pedapudi/oddstride/longshanks/README.md

# Longshanks

Longshanks is the humanoid biped robot in [Oddstride](../README.md).

This directory is for Longshanks' design notes, hardware, and software. Development is at the initial design stage.
