pedapudi/oddstride/tinfox/proposals/sculpted/model/output/flat-patterns/README.txt

TINFOX FLAT CUTTING PROFILES — MILLIMETRES

Electronics deck: the current part is 4 mm PETG, printed flat. The DXF is a
profile candidate for later flat cutting or CNC. A thinner aluminum version
requires revised screw lengths, equipment height and a stiffness check.

Fixed lower brace: 3 mm aluminum candidate. The midplane DXF gives the cut
outline and holes. Finish the four 2.5 mm pilot holes as M3 x 0.5 threads;
four 3.4 mm holes are rail clearances. Deburr edges. The STEP includes small
edge radii that a cutting operation alone does not produce.

Confirm available stock thickness, cutting process, hole limits and tapping
with the fabricator. These files are not a manufacturing release.
