pedapudi/oddstride/tinfox/proposals/sculpted/design/rounded-shell-concept-v1/index.html

# Tinfox / rounded shell concept

Proposed articulated shoulder covers, rounded structural thighs and smooth oval shins. These generated images illustrate surface shape and assembly seams. They are not CAD exports or evidence of validated clearance, strength or manufacturability.

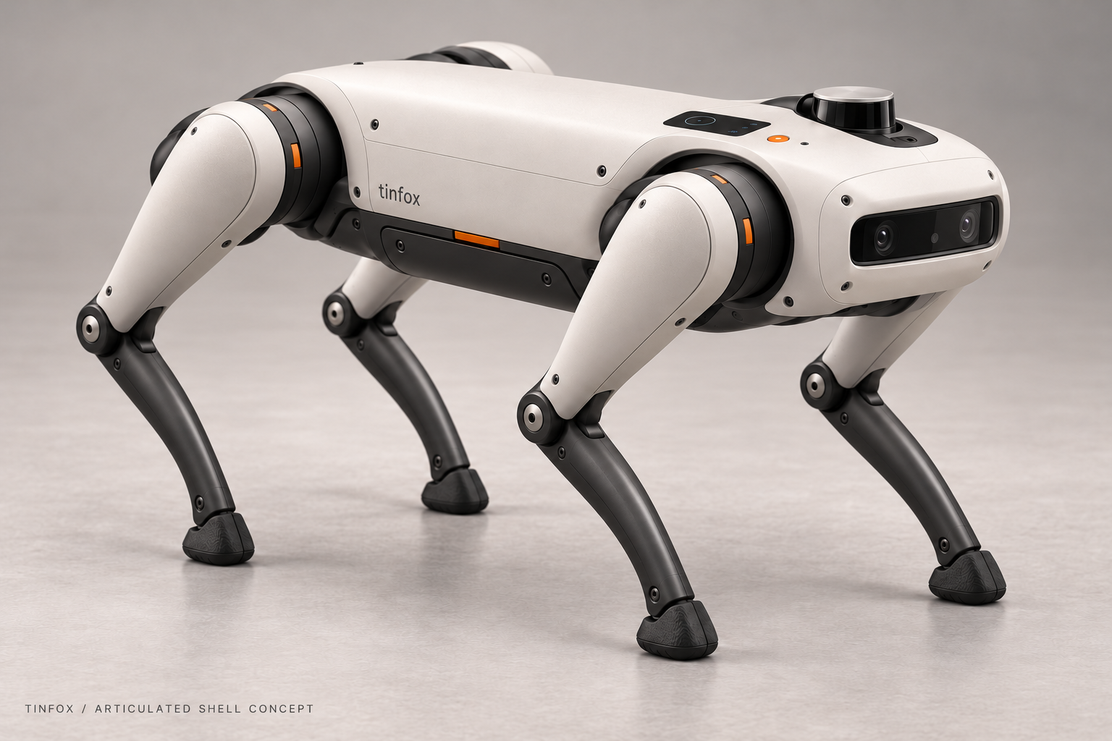
[picture p2: tinfox/proposals/sculpted/design/rounded-shell-concept-v1/full-robot.png]
Proposed Tinfox exterior with moving shoulder covers and smoothly rounded limbs


Complete robot: warm off-white body and thighs, graphite shoulder pods and closed oval shins.

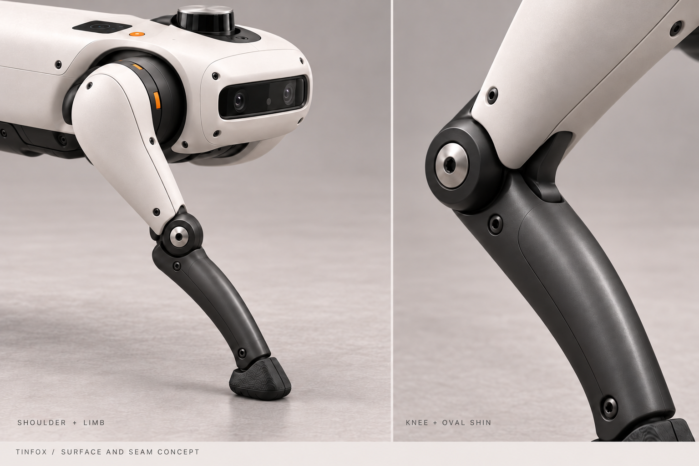
[picture p3: tinfox/proposals/sculpted/design/rounded-shell-concept-v1/limb-detail.png]
Shoulder and complete limb beside a close view of the knee transition and rounded shin


Detail: compact shoulder packaging, two-piece limb seams and broad knee transitions. Hardware interfaces remain subject to CAD development.

Generation prompts and provenance · Generated with the built-in image tool. The existing CAD and native Fusion conversion remain unchanged by this concept study.
