pedapudi/oddstride/tinfox/proposals/sculpted/model/output/service-design/README.html

# Tinfox chassis-mounted head and service revision

This CAD revision changes the shin split to two structural side halves. Each half contains a complete 28 mm bearing bore and an integral pushrod ear. The thigh cheeks provide backup axial stops. Motor connector envelopes and local housing openings are included in the robot view.

Open interactive CAD · Open bearing extraction view · Labeled bearing section · Updated whole robot STEP · Updated front-left leg STEP

## Chassis-mounted head; cosmetic rear cap removed

The narrow lower strips beneath the head and tail have been removed. The front bridge attaches directly to the chassis crossmember through a 48 mm-wide mounting lap and two vertical M3 screws. Deep rounded shoulder sockets follow a conservative hip-roll envelope. Leg loads still pass through the independent motor cartridges and metal chassis.

The curved central bridge rises locally to about 68 mm above the hip-roll axis, compared with the earlier 55.5 mm shoulder crown. This extra depth preserves material above the sockets. The front retains a reinforced lower camera surround and removable curved fascia. The rear cap carries no equipment or chassis load and has been removed, together with its two screws and two nuts. The rear chassis crossmember remains to connect the motor rails. The head bridge is not a qualified lifting handle.

The provisional lidar moves 30 mm rearward onto the central cover to clear the front bridge. The two head nuts now sit below the front chassis crossmember; the earlier placement overlapped the metal. Existing screw locations remain unchanged.

For end-module service, remove the upper body cover, disconnect sensor wiring, undo the two cap screws and lift the module. The front fascia remains independently removable for camera service. Battery removal remains independent. Print the supplied oriented head bridge with removable supports beneath curved surfaces and local returns; it is not a support-free part. Inspect the sliced screw holes and narrowest bridge sections before printing.

Inspect the head bridge · Fixed interfaces and removal-path checks

## Knee linkage display correction

The isolated thigh view previously discarded the crank and rod transforms, incorrectly drawing the rod eye at the motor center. That view now preserves the assembled transforms. The rod attaches to a pin 22 mm from the motor axis, and its eyes are 170 mm apart. The dedicated linkage view exposes both connections. The geometry audit checks both eye-to-pin positions on all four legs in all 35 sampled poses.

Inspect the knee linkage

## Native Fusion conversion

A native-feature conversion is in progress. This revision remains the reference geometry until the Fusion parts pass shape, interface, assembly, motion and editability audits. STEP files below preserve solids but do not supply a native editable feature history.

## Removing a bearing

1. Support the leg. Disconnect the pushrod and remove the knee axle retention. Separate the shin from the thigh cheeks. The cheeks normally limit outward bearing movement, with 0.3 mm nominal axial clearance.
2. Remove the two M4 × 25 cross bolts and open the shin sideways. Bearings remain in their complete circular seats. The 18 mm compression sleeves and standard nuts are removable hardware.
3. Support the removed half close to its bearing housing with an opening beneath the bearing. Insert two blunt 2 mm service pins through the 2.6 mm holes behind the bearing outer ring.
4. Apply even force with a small press or suitable parallel tool so the bearing exits outward. Avoid loading the inner ring or seals. The pins are temporary tools, not installed leg components.

The opposed inward shoulders locate the bearing outer rings. The thigh faces are backup stops and are not intended to rub continuously. The inner-race spacer stack must let normal axial loads pass through the bearings.

The access holes pass through the rear shoulder. They do not split the cylindrical seat. Their contact positions must be checked against the selected bearing's outer-ring face before pressing. The model uses nominal 12 × 28 × 8 mm bearing envelopes.

Section through the bearing shoulder and two rear extraction holes

## How the halves locate and clamp

Broad mating faces and two alignment tongues locate the side halves. Two M4 cross bolts run parallel to the knee axle. Metal compression sleeves carry bolt preload. The shin retains the curved outer profile and internal cavity. Both halves are required for operation.

The complete bore improves repeatability relative to two semicircular seats, but two printed seats can still be misaligned. The nominal 28 mm CAD bore is not a specified interference fit. Print bearing-seat coupons in the same orientation and material before choosing hole compensation. Measure the assembled axle alignment and check running resistance before and after tightening.

## Principles carried into the thigh

The thigh keeps its integrated motor cradle and removable outer structural half. The motor plate is accessible after opening the shell. Broad load paths, metal compression sleeves and open service access also apply to the shin. The revision adds knee outer-race backup stops to the existing thigh cheeks, avoiding another installed bearing cover.

The thigh does not need the same bearing-extraction holes at the knee: its knee interface holds the axle, while the rolling bearings live in the shin. The separate hip-roll bearing needs its own retention and extraction design.

## Connector geometry and assumptions

The cached RobStride STEP contains two opposed radial ports near the rear cover. Both are represented on each of the twelve motors, for 24 reserved port positions. The housing envelope uses a 15.5 × 5.2 mm mouth; the cable plug uses the AMASS 12.3 × 4.2 × 11.8 mm outline. These are packaging solids, not contact-level connector CAD.

The provisional insertion overlap is 5 mm. Heat-shrink space, a 7 mm cable-bundle envelope and a straight 22 mm cable segment are included. The model reserves a 20 × 14 mm withdrawal corridor. These dimensions do not establish a cable bend radius or qualify flexing across hip roll and pitch. Harness anchor positions, slack loops, abrasion protection and fatigue life remain open.

The knee stator plate rotates its nine-hole pattern by 20 degrees while retaining the three structural tie positions. This gives the knee ports a different clocking from the hip and roll ports to clear the proximal carrier in the named poses. Socket position is measured approximately from the cached vendor STEP; final clocking and insertion depth require a fit check with the supplied motor and plug.

Housing windows and an underside-panel opening accommodate the modeled connectors. The cutouts remain unsealed. They do not establish an environmental protection rating. Local strength around the windows requires review.

## Measured checks and limits

All 24 plug positions pass the sampled 25 mm withdrawal path in neutral with exterior body covers removed. Seven named poses clear the revised interfaces. The deep fold retains front-thigh contact with the underside panel. Additional combined-angle samples also contain collisions; the model does not establish an unrestricted joint range.

Exact-solid checks cover bearing withdrawal, shell separation, extraction-pin access, clamp hardware and nominal thigh-stop gaps. The browser highlights reported interference in the selected pose. Collision samples cover plugs, initial cable segments and revised structural parts; they do not model a deforming harness.

Estimated base mass is 13.213 kg. The modeled change is +24.9 g relative to the previous assembly. This remains a CAD estimate with battery, electronics and wiring allowances. It exceeds the 10 kg target.

Geometry checks · Recomputed torque screen · Export inventory

Load case | Payload kg | Roll, hip, knee motor torque N·m
four foot stand | 0 | 1.73, 0.11, 2.61
two foot stand | 0 | 3.90, 0.47, 5.27
three foot crouch | 0 | 2.45, 0.41, 6.34
stair reach 60 percent | 0 | 6.59, 13.43, 12.51
reach with braking | 0 | 6.59, 9.50, 11.76
splayed two foot | 0 | 13.41, 0.42, 4.96
four foot stand | 1 | 1.89, 0.14, 2.81
two foot stand | 1 | 4.23, 0.52, 5.67
three foot crouch | 1 | 2.67, 0.48, 6.83
stair reach 60 percent | 1 | 7.13, 14.46, 13.46
reach with braking | 1 | 7.13, 10.24, 12.66
splayed two foot | 1 | 14.47, 0.47, 5.34
unloaded 2p5g pulse | 0 | 10.41, 1.54, 13.26
unloaded 3g landing screen | 0 | 12.58, 1.89, 15.93

The torque screen uses prescribed foot forces and moving-link gravity. It does not certify stairs, running, jumping, thermal endurance or self-righting. Printed strength, creep, bearing fits, actual fastener lengths and cable life require physical testing.

## Printing and machining

Orient the side halves with the open cavity upward and the long limb axis in the bed plane. The bearing axis then prints vertically. Rounded exterior surfaces still need local support review in the slicer. Check first-layer distortion, bearing bores and alignment tongues. Solid infill does not establish strength or eliminate creep.

For CNC, machine complete bearing seats from common datums and inspect the assembled coaxiality. The two rear access holes are straight drilling operations. The integral fork and cross-bolt pockets still require tool-reach and setup review. STEP files preserve solids but not a native Fusion feature timeline.

## Printed fit parts

The keyed two-piece motor-carrier mockups include connector windows. These files are left-side fit mockups; right-side carriers require mirroring. They remain unloaded prototypes.

- printed carrier -1 trunnion · STL
- printed carrier -1 flange · STL
- printed carrier 1 trunnion · STL
- printed carrier 1 flange · STL
- bearing coupon 27p9 · STL
- bearing coupon 28p0 · STL
- bearing coupon 28p1 · STL
- bearing coupon 28p2 · STL

## Sources

- RobStride RS02 manual (https://www.robstride.com/assets/product_manual_robStride02-e7f9f7c4.pdf): connector pair and motor interface.
- RobStride product repository (https://github.com/RobStride/Product_Information): manufacturer CAD reference. This revision uses the previously cached RS02 STEP.
- AMASS connector catalog, page 11 (https://www.china-amass.com/public/upload/20240723/c1ae9604bbe795ebfd366c9063019e3e.pdf): XT30(2+2)-F plug outline.
- AMASS XT30 2+2 PB-M specification (https://www.tme.eu/Document/127227924e5d7adc643d586e8218a55a/XT30PB-M.pdf): board connector outline.
