pedapudi/oddstride/tinfox/analysis/dfma/fastener-reduction/thigh-detail/300-root.png

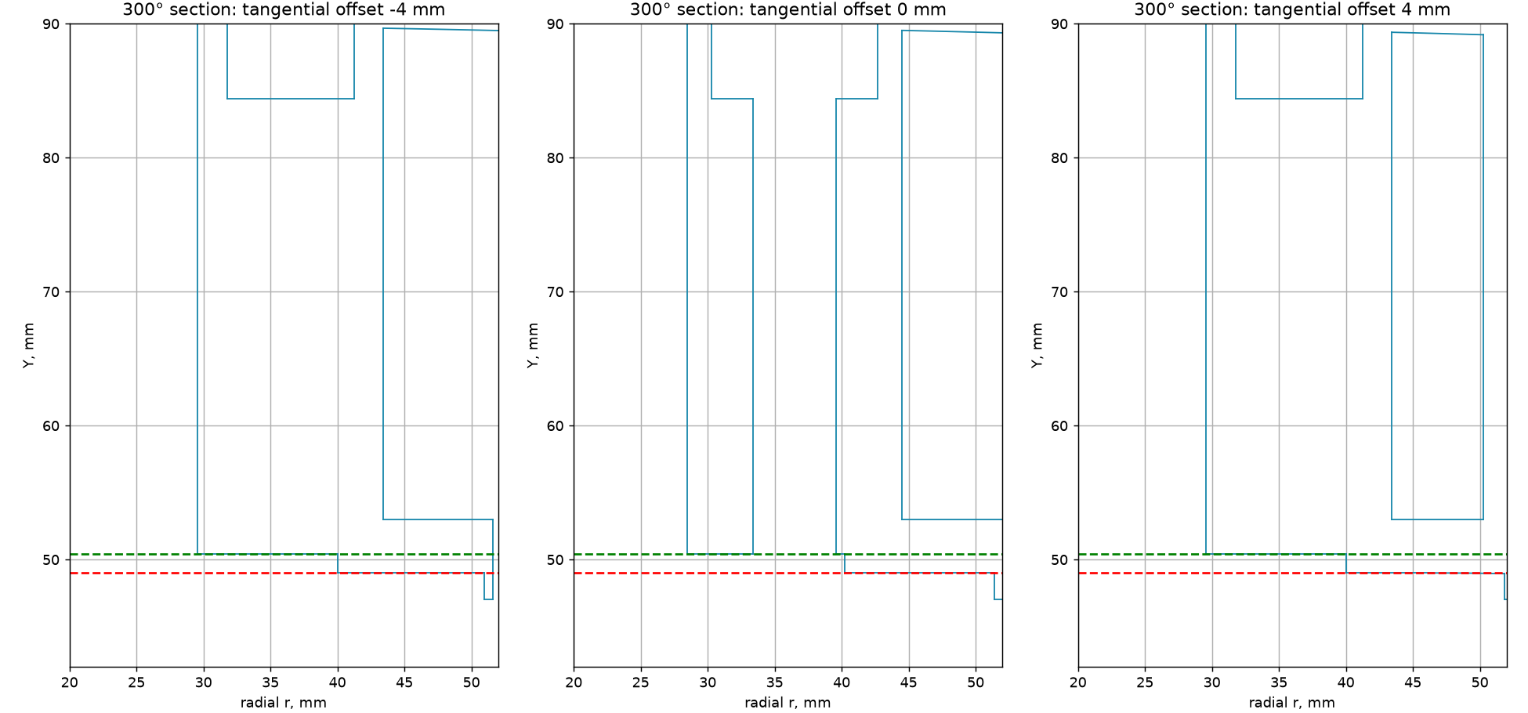
tinfox/analysis/dfma/fastener-reduction/thigh-detail/300-root.png
