pedapudi/oddstride/tinfox/analysis/dfma/fastener-reduction/thigh-detail/sections-y.png

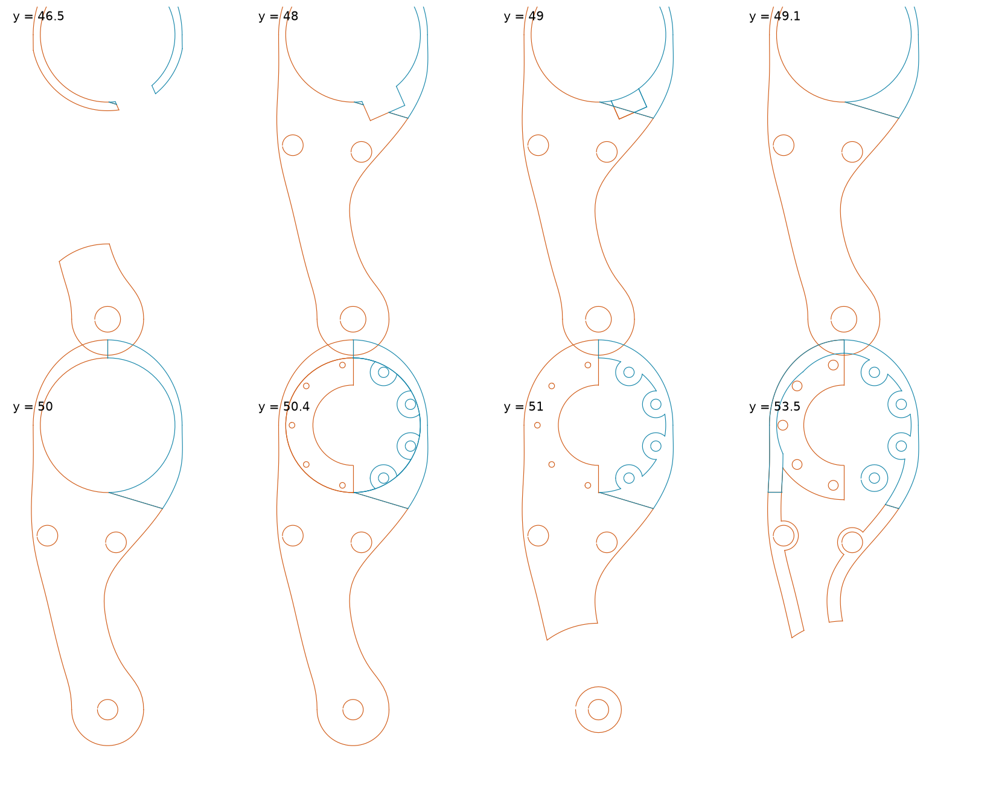
tinfox/analysis/dfma/fastener-reduction/thigh-detail/sections-y.png
