pedapudi/oddstride/tinfox/analysis/dfma/fastener-reduction/thigh-detail/sections-z.png

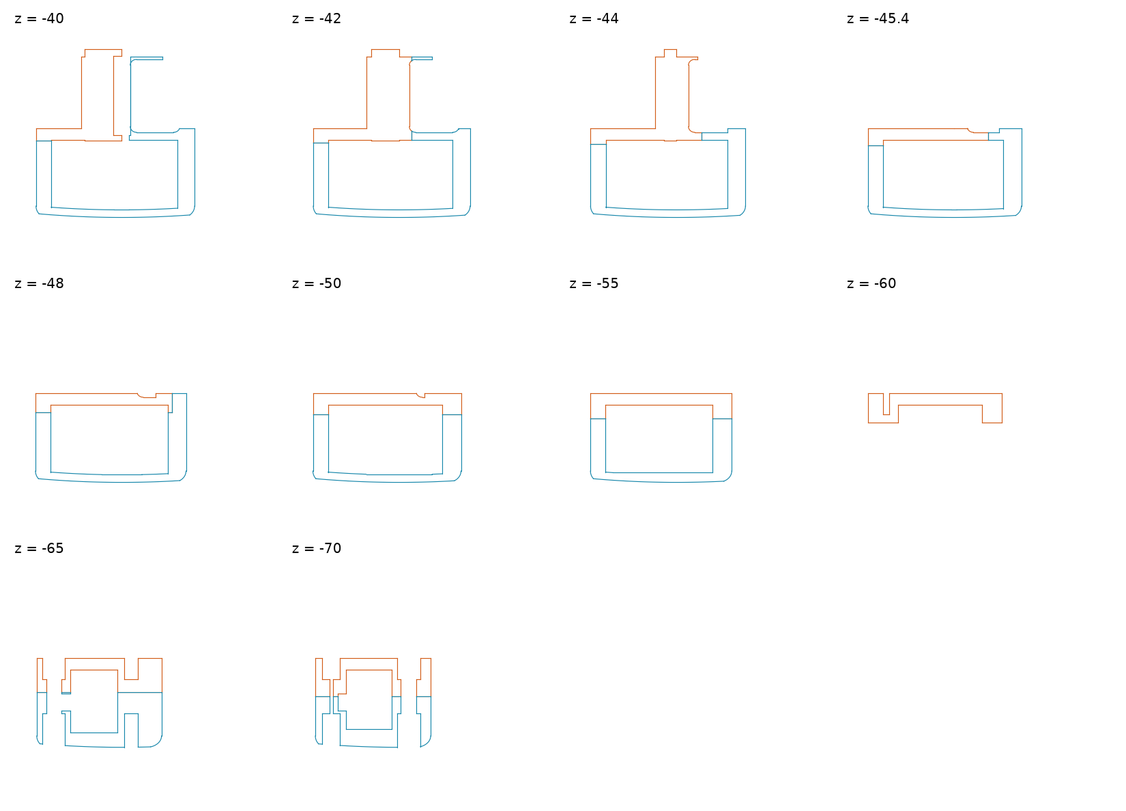
tinfox/analysis/dfma/fastener-reduction/thigh-detail/sections-z.png
