pedapudi/oddstride/tinfox/analysis/dfma/motor-complex-fit/rs02-side-datums.png

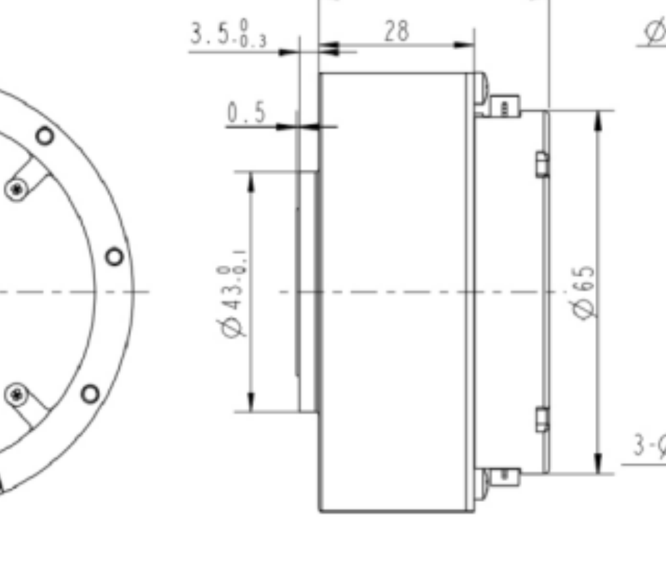
tinfox/analysis/dfma/motor-complex-fit/rs02-side-datums.png
