pedapudi/oddstride/tinfox/design/06-tinfox-instrument-concept.png

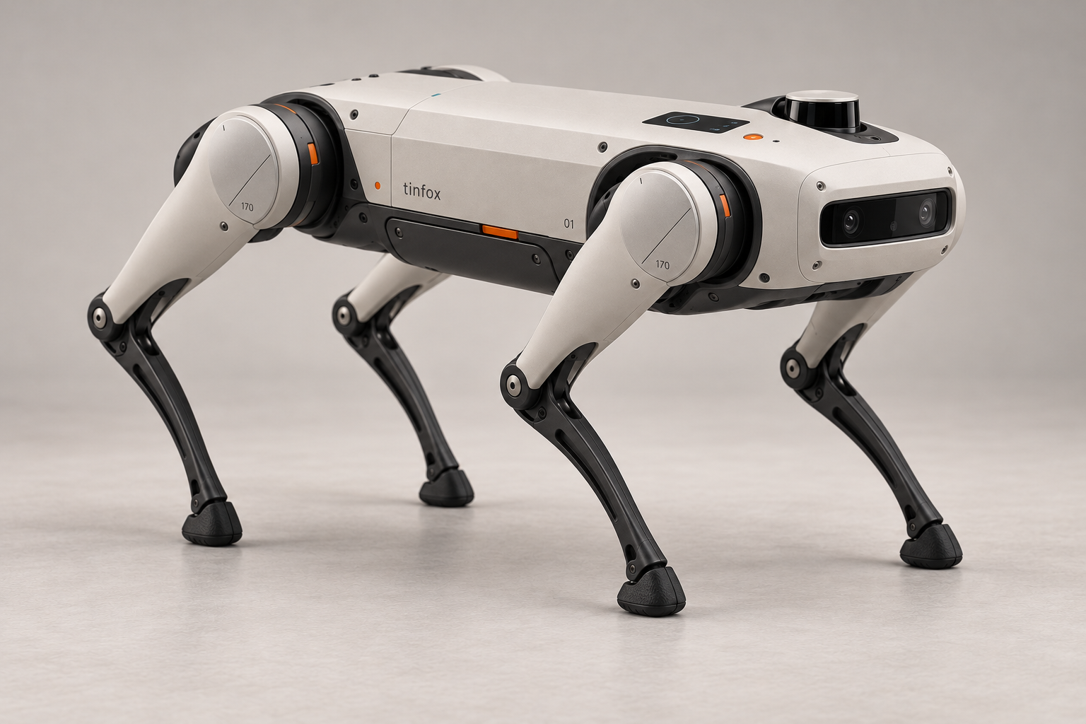
tinfox/design/06-tinfox-instrument-concept.png
