pedapudi/oddstride/tinfox/design/08-articulated-hip-studio.png

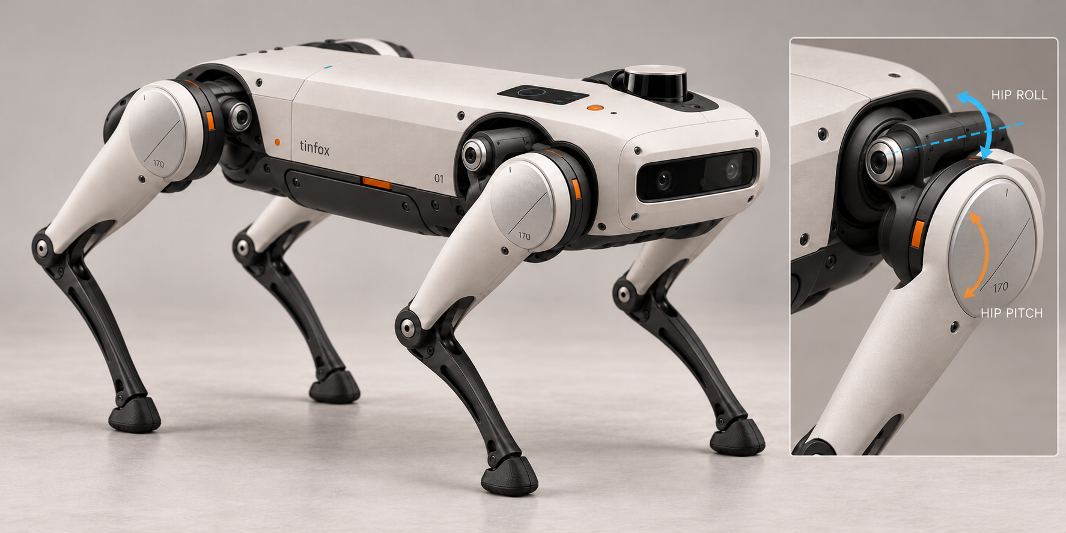
tinfox/design/08-articulated-hip-studio.png
