pedapudi/oddstride/tinfox/design/09-cad-studio.png

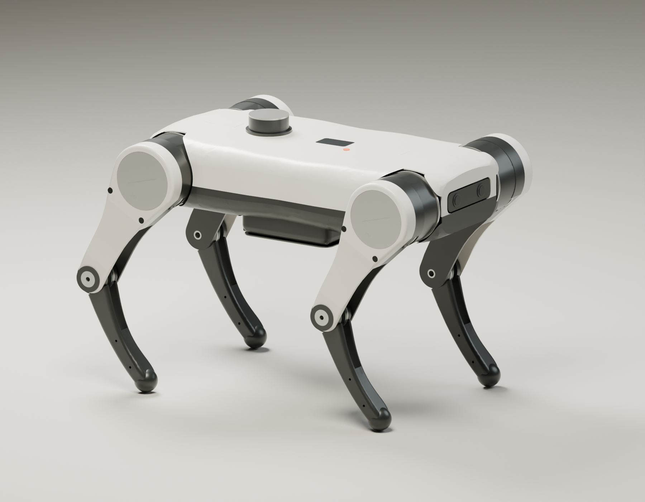
tinfox/design/09-cad-studio.png
