pedapudi/oddstride/tinfox/design/body-options/01-pebble.png

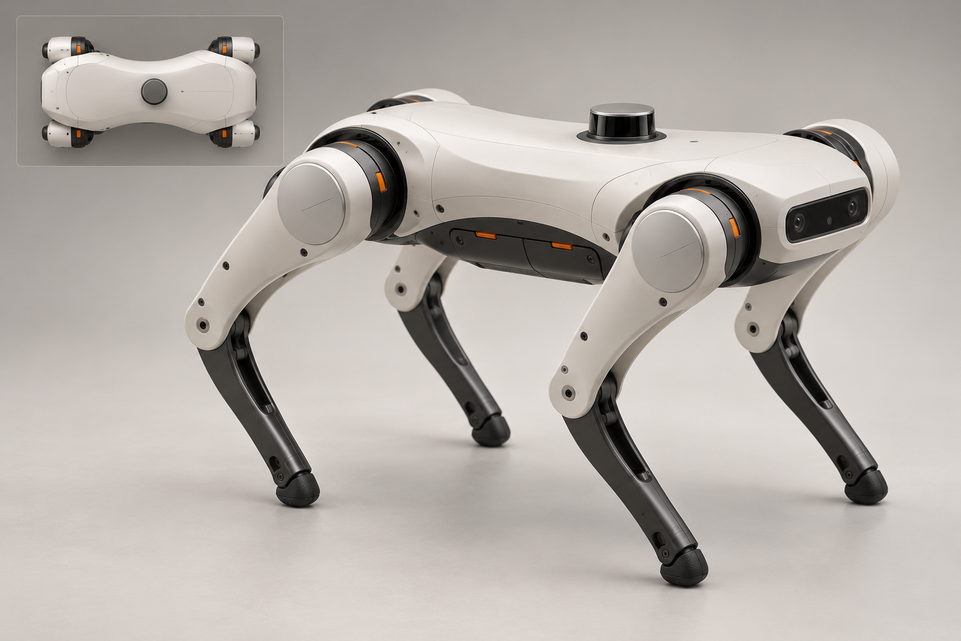
tinfox/design/body-options/01-pebble.png
