pedapudi/oddstride/tinfox/design/body-options/02-keel.png

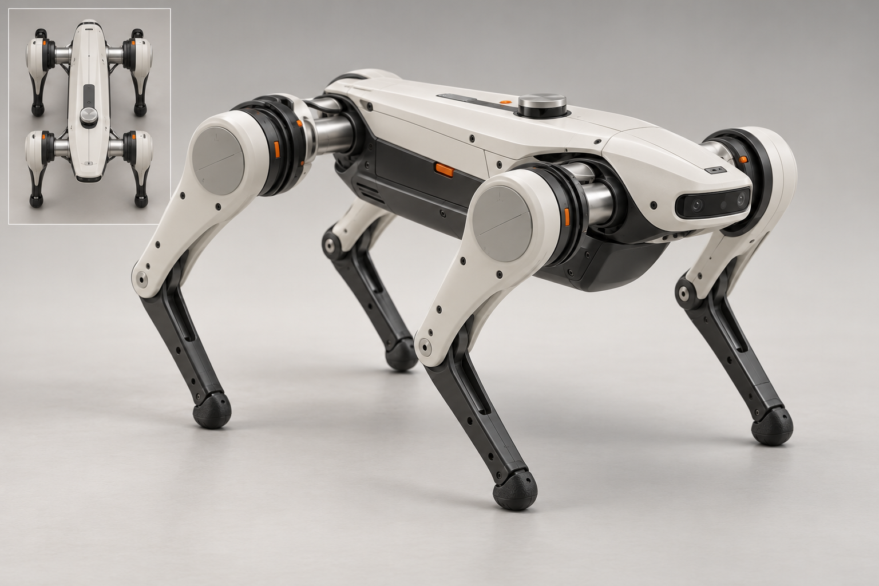
tinfox/design/body-options/02-keel.png
