pedapudi/oddstride/tinfox/design/body-options/03-twin-rail.png

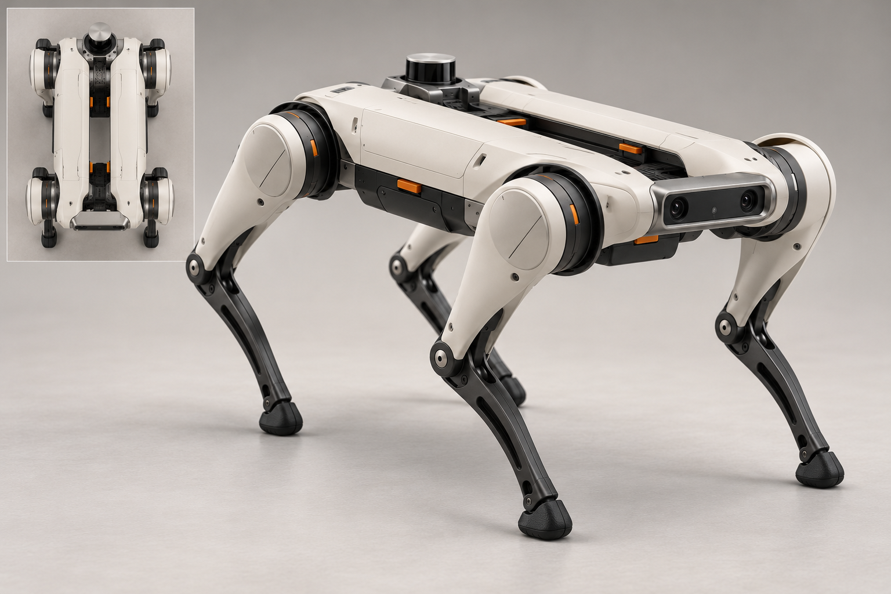
tinfox/design/body-options/03-twin-rail.png
