pedapudi/oddstride/tinfox/design/body-options/04-manta.png

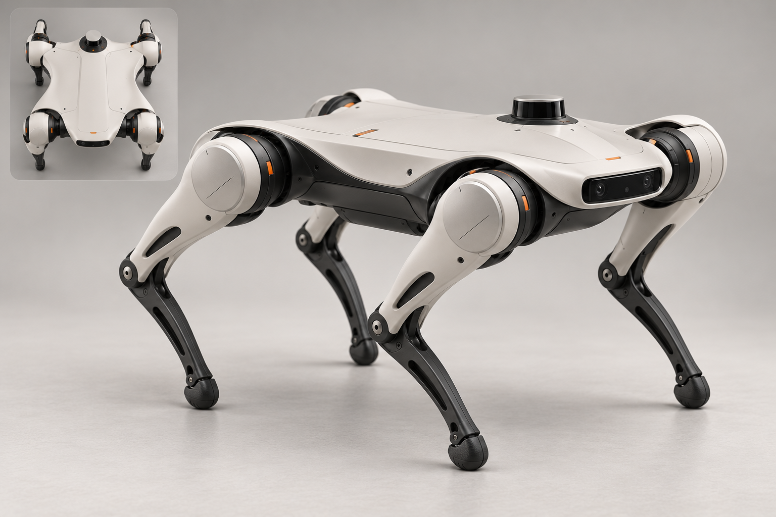
tinfox/design/body-options/04-manta.png
