pedapudi/oddstride/tinfox/design/body-options/baseline-cad.png

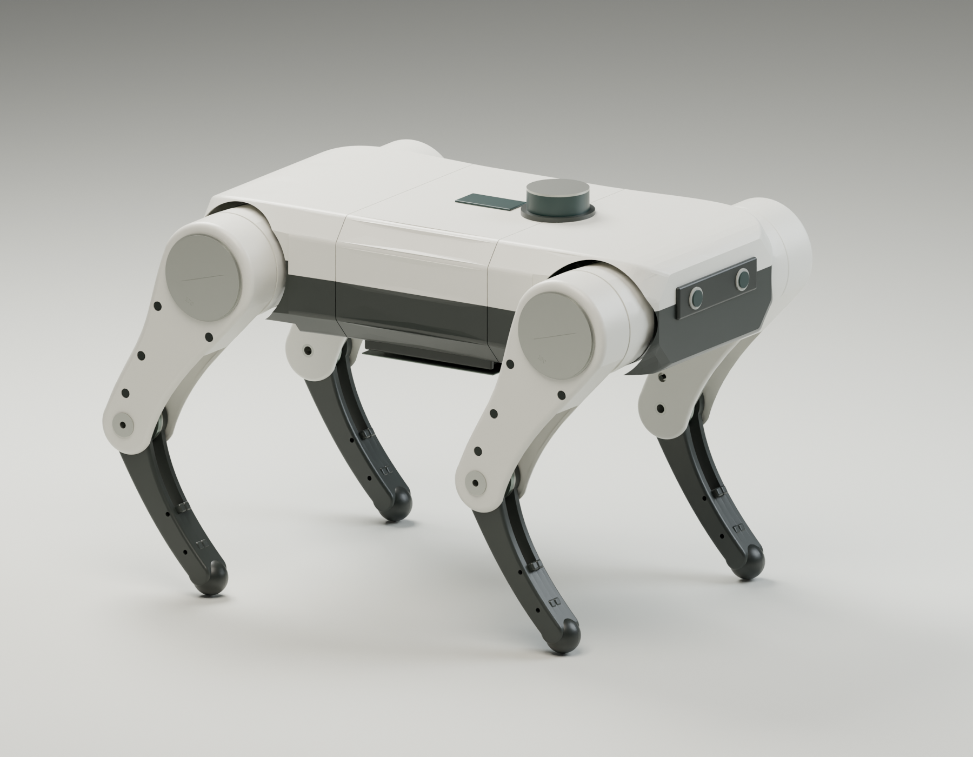
tinfox/design/body-options/baseline-cad.png
