pedapudi/oddstride/tinfox/design/body-options/review-preview.png

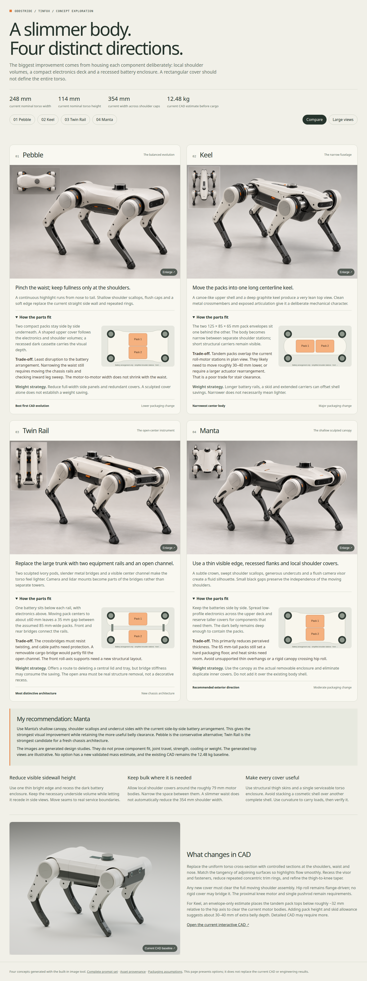
tinfox/design/body-options/review-preview.png
