pedapudi/oddstride/tinfox/model/output/body-comparison-preview.png

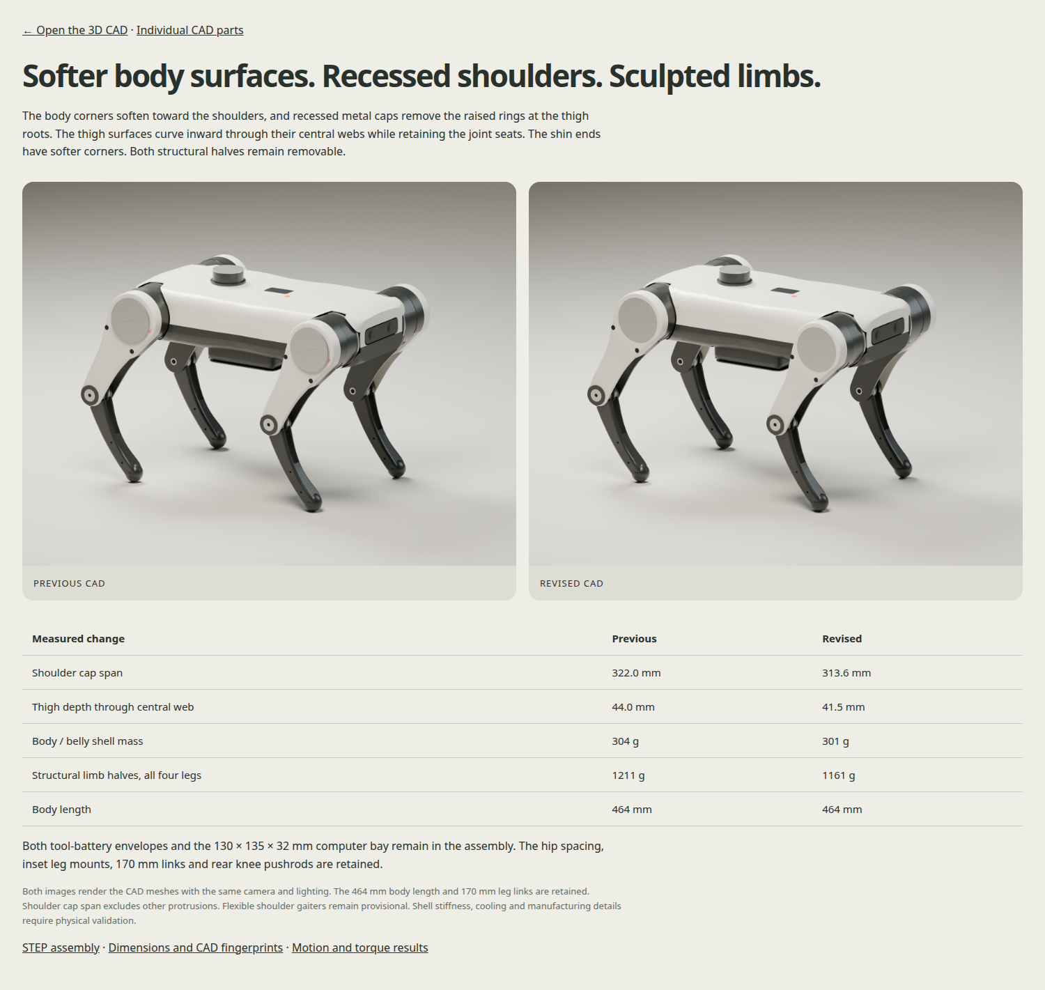
tinfox/model/output/body-comparison-preview.png
