pedapudi/oddstride/tinfox/model/output/exterior-preview.png

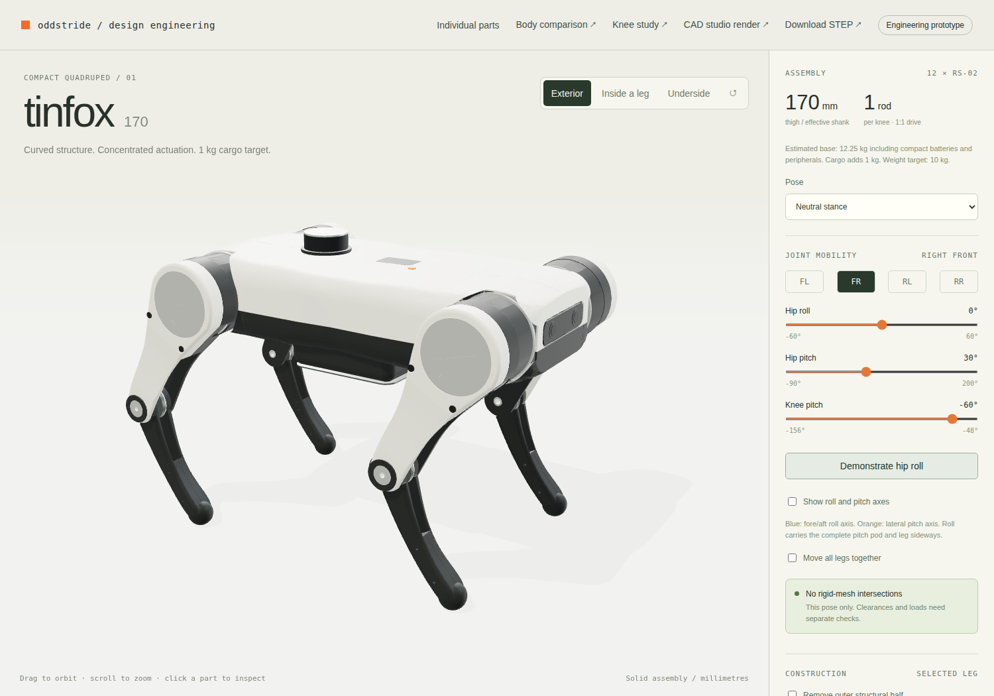
tinfox/model/output/exterior-preview.png
