pedapudi/oddstride/tinfox/model/output/integrated-thigh-preview.png

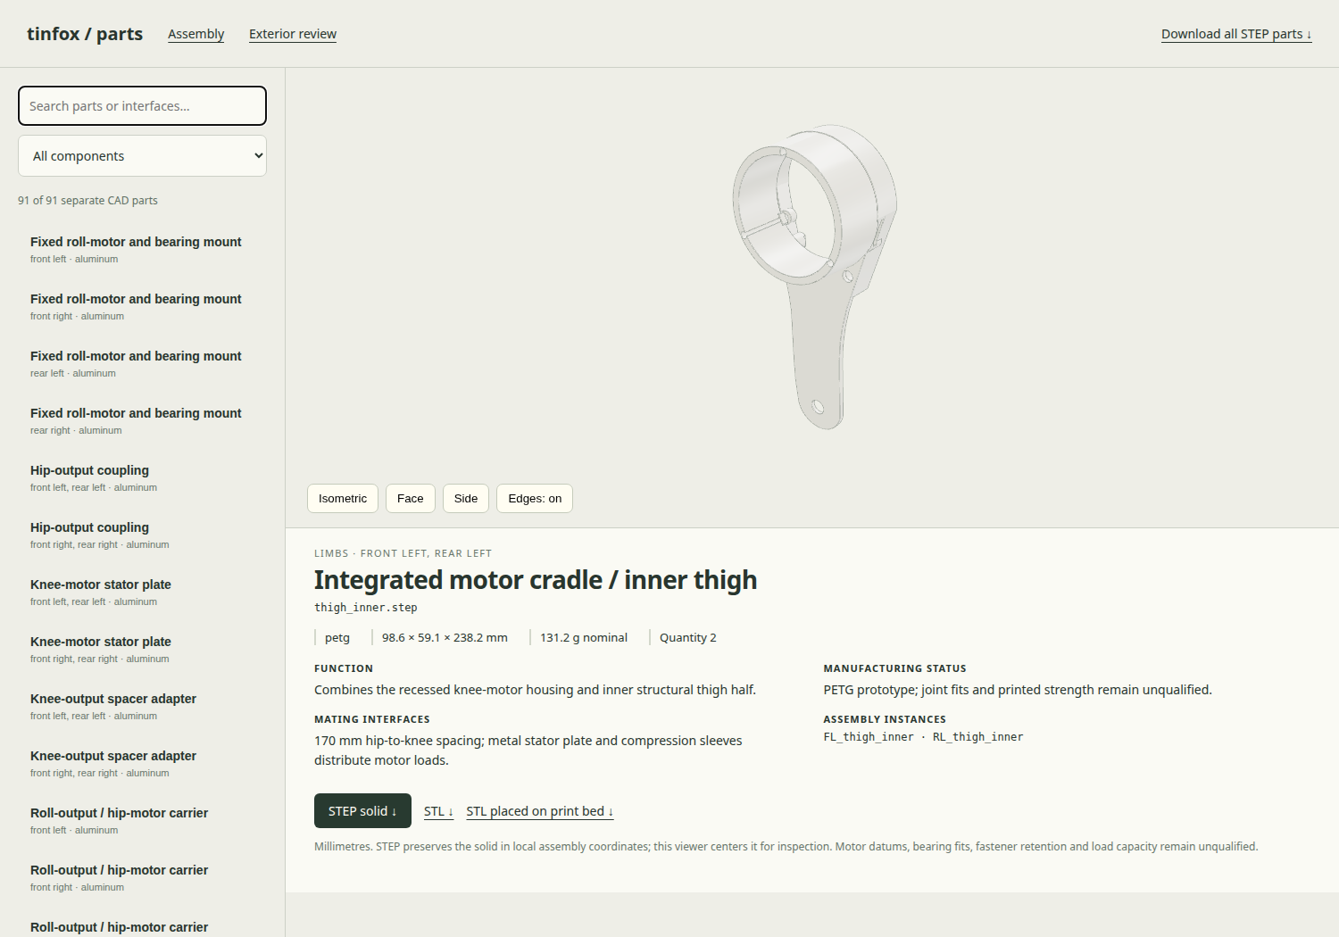
tinfox/model/output/integrated-thigh-preview.png
