pedapudi/oddstride/tinfox/model/output/knee-study-preview.png

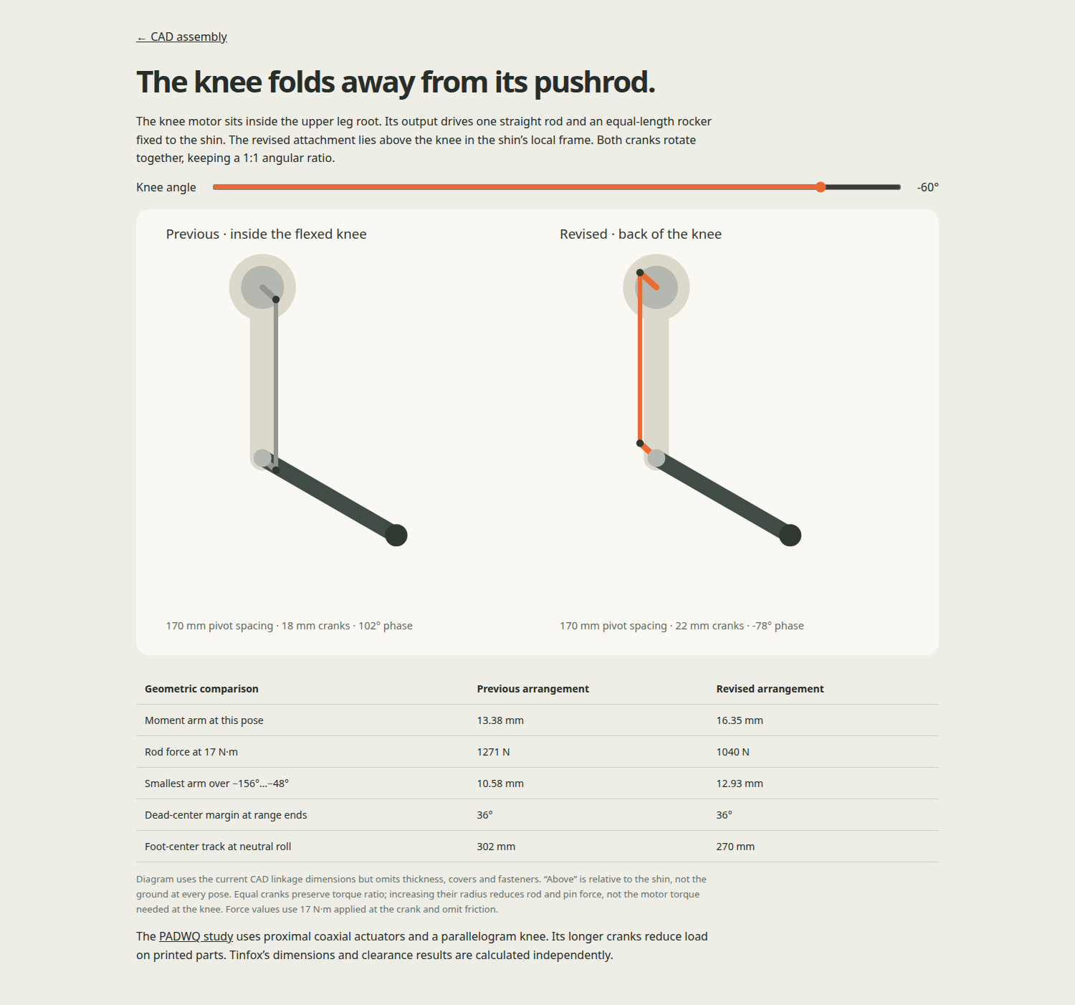
tinfox/model/output/knee-study-preview.png
