pedapudi/oddstride/tinfox/model/output/leg-section-preview.png

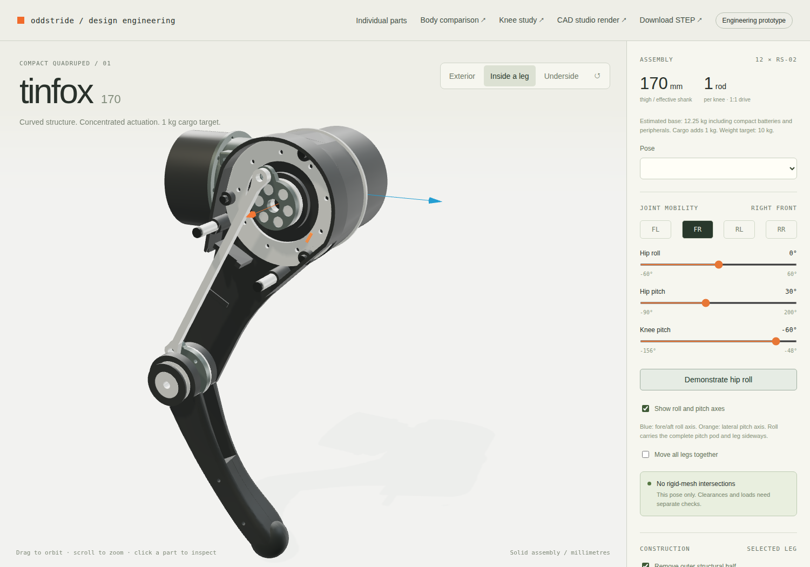
tinfox/model/output/leg-section-preview.png
