pedapudi/oddstride/tinfox/model/output/motor-carrier-preview.png

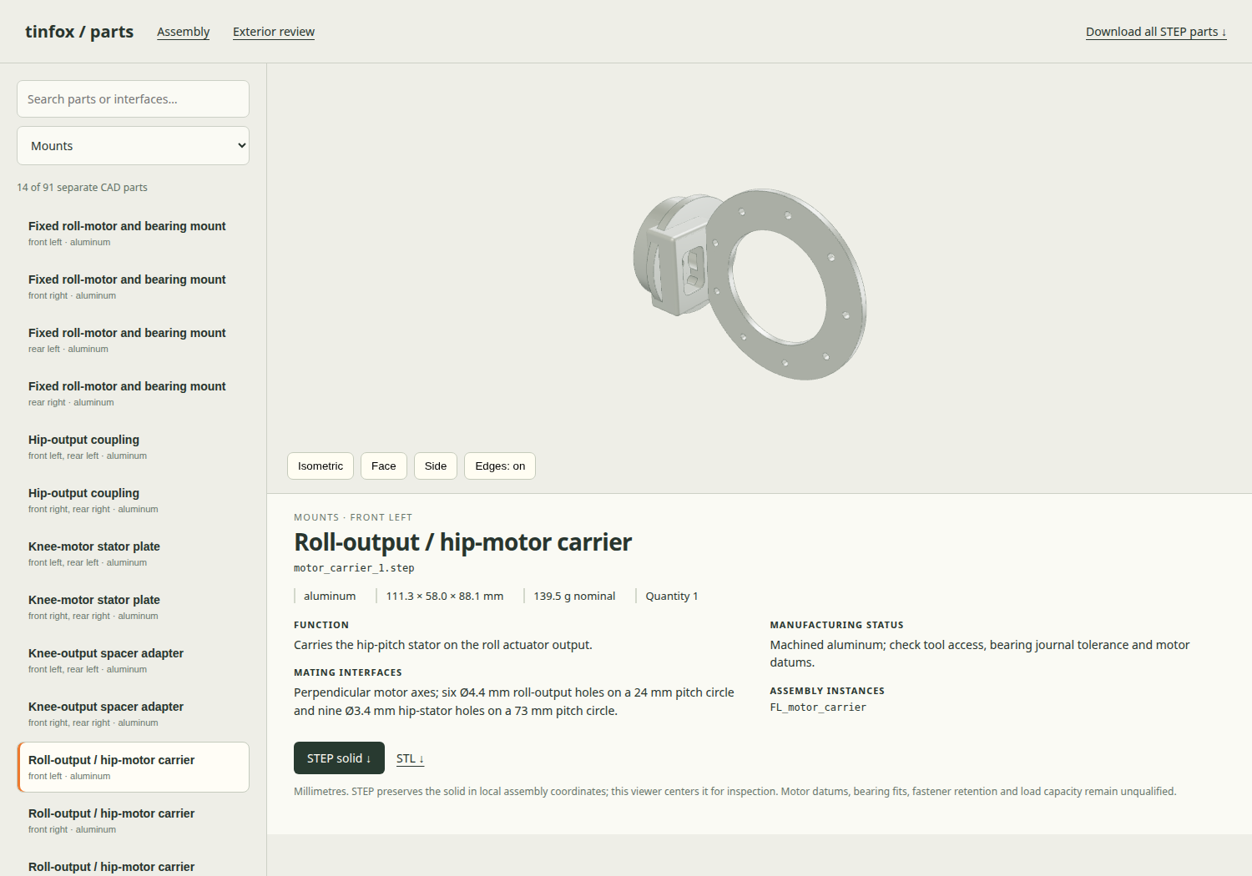
tinfox/model/output/motor-carrier-preview.png
