pedapudi/oddstride/tinfox/proposals/baseline-comparison-preview.png

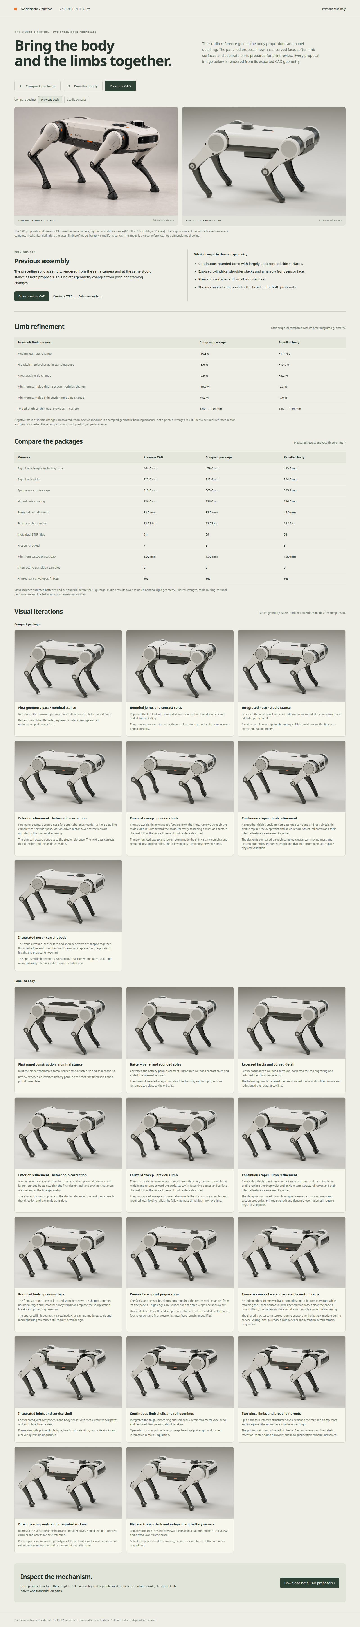
tinfox/proposals/baseline-comparison-preview.png
