pedapudi/oddstride/tinfox/proposals/baseline-studio-view.png

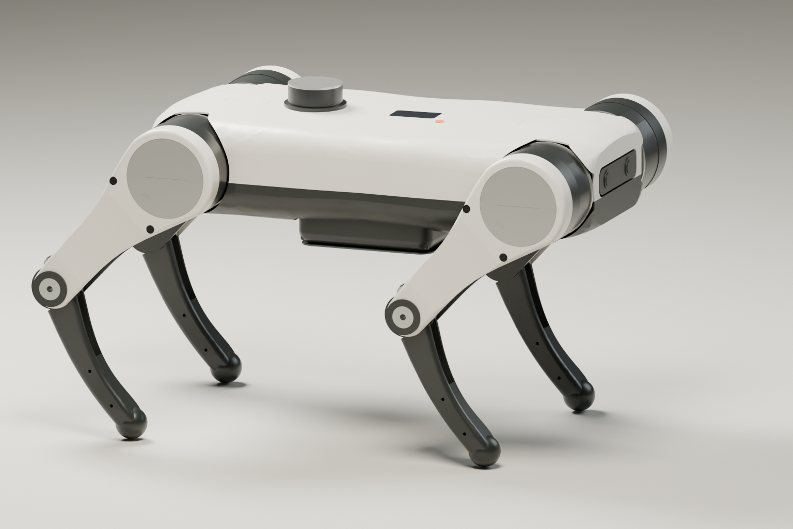
tinfox/proposals/baseline-studio-view.png
