pedapudi/oddstride/tinfox/proposals/compact-comparison-preview.png

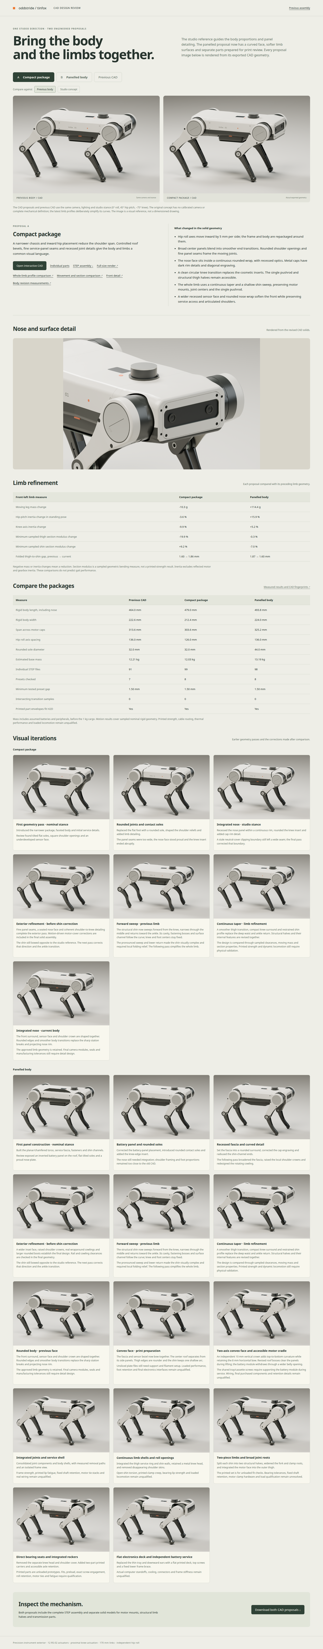
tinfox/proposals/compact-comparison-preview.png
