pedapudi/oddstride/tinfox/proposals/compact/design/09-cad-studio.png

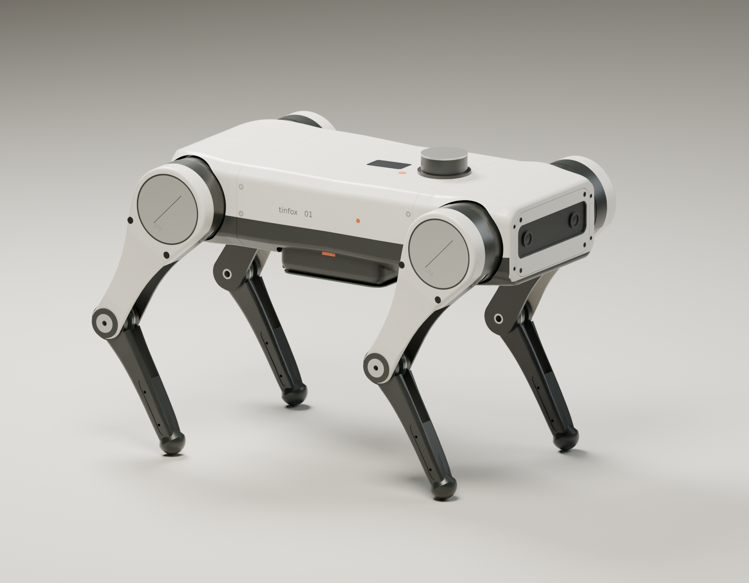
tinfox/proposals/compact/design/09-cad-studio.png
