pedapudi/oddstride/tinfox/proposals/compact/design/12-studio-view.png

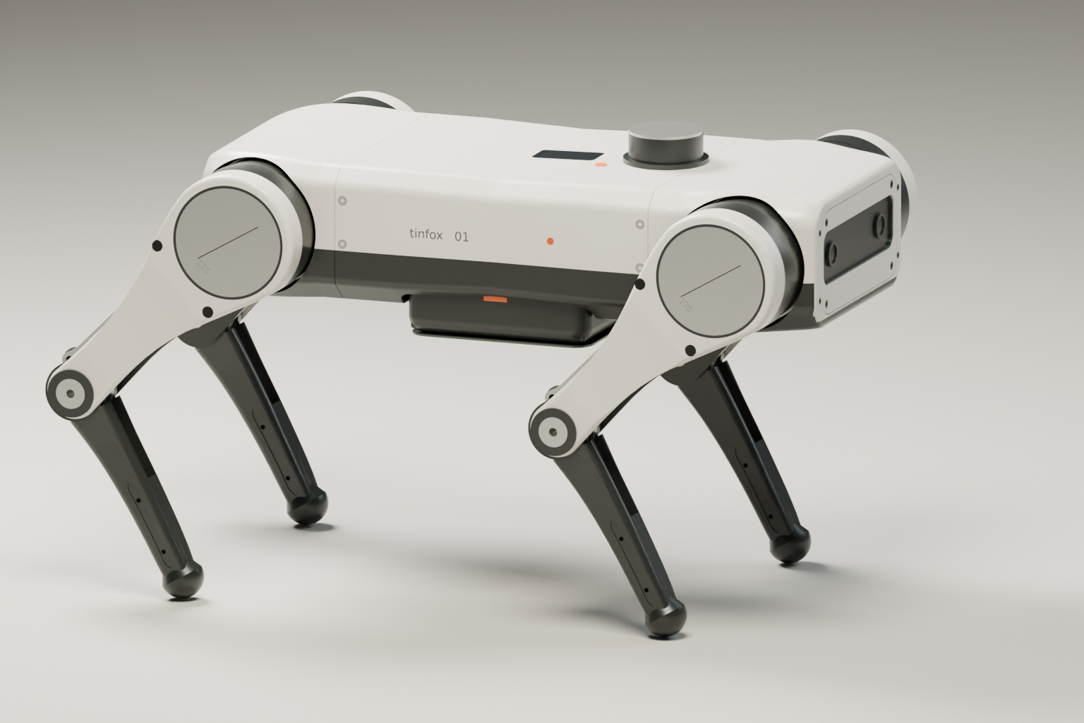
tinfox/proposals/compact/design/12-studio-view.png
