pedapudi/oddstride/tinfox/proposals/compact/design/15-body-detail.png

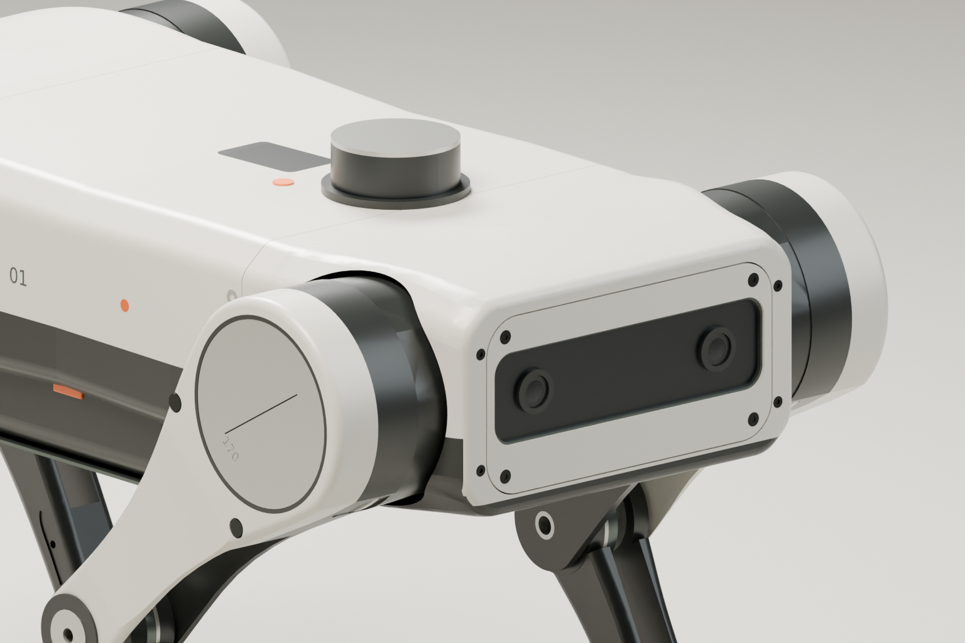
tinfox/proposals/compact/design/15-body-detail.png
