pedapudi/oddstride/tinfox/proposals/compact/model/output/exterior-preview.png

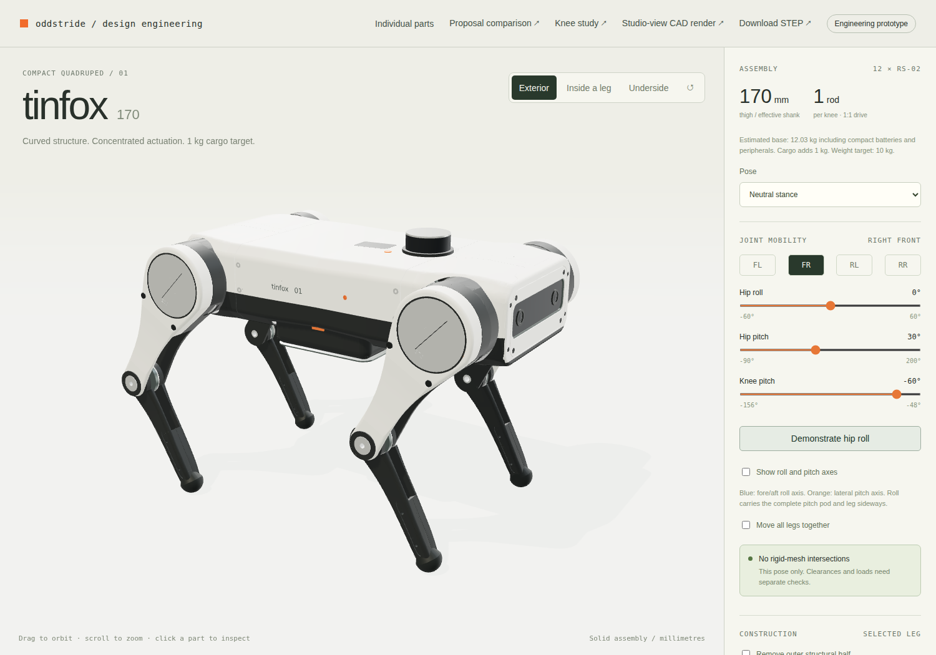
tinfox/proposals/compact/model/output/exterior-preview.png
