pedapudi/oddstride/tinfox/proposals/compact/model/output/hip-roll-preview.png

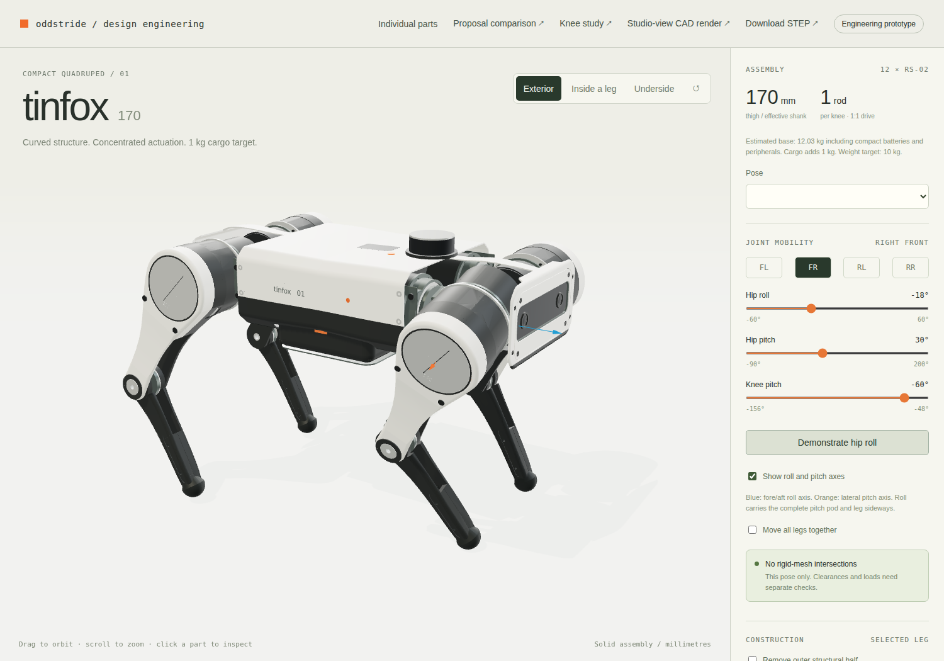
tinfox/proposals/compact/model/output/hip-roll-preview.png
