pedapudi/oddstride/tinfox/proposals/compact/model/output/limb-profile-preview.png

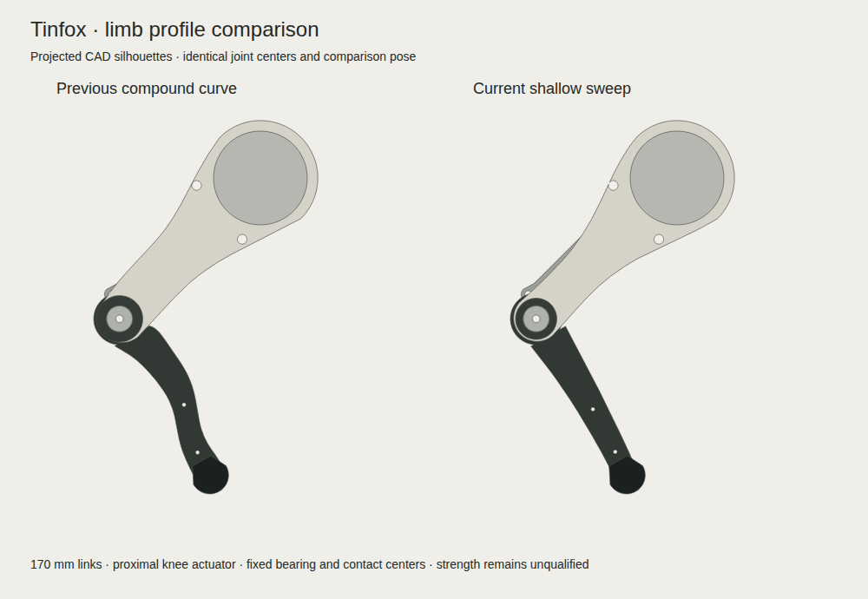
tinfox/proposals/compact/model/output/limb-profile-preview.png
