pedapudi/oddstride/tinfox/proposals/sculpted/design/09-cad-studio.png

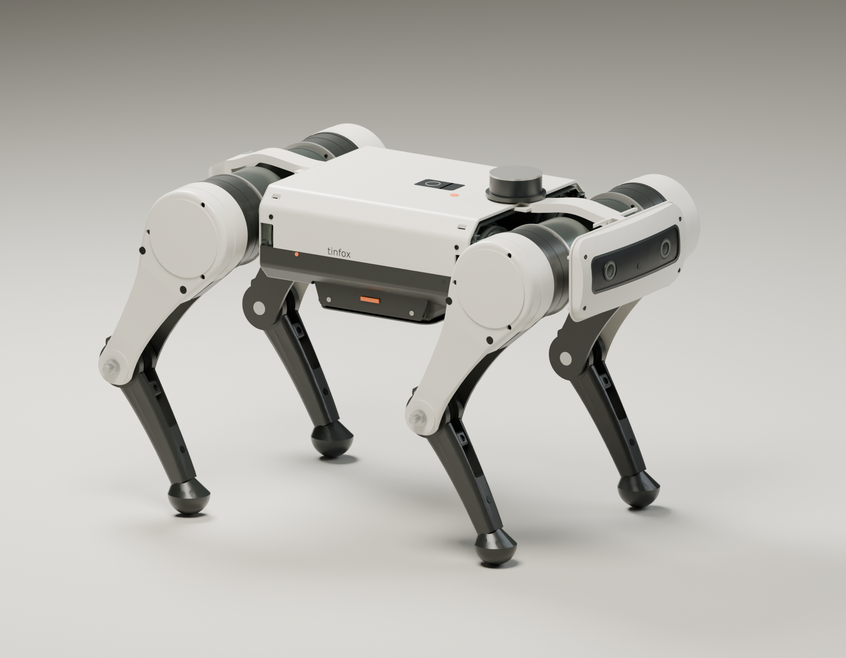
tinfox/proposals/sculpted/design/09-cad-studio.png
