pedapudi/oddstride/tinfox/proposals/sculpted/design/15-body-detail.png

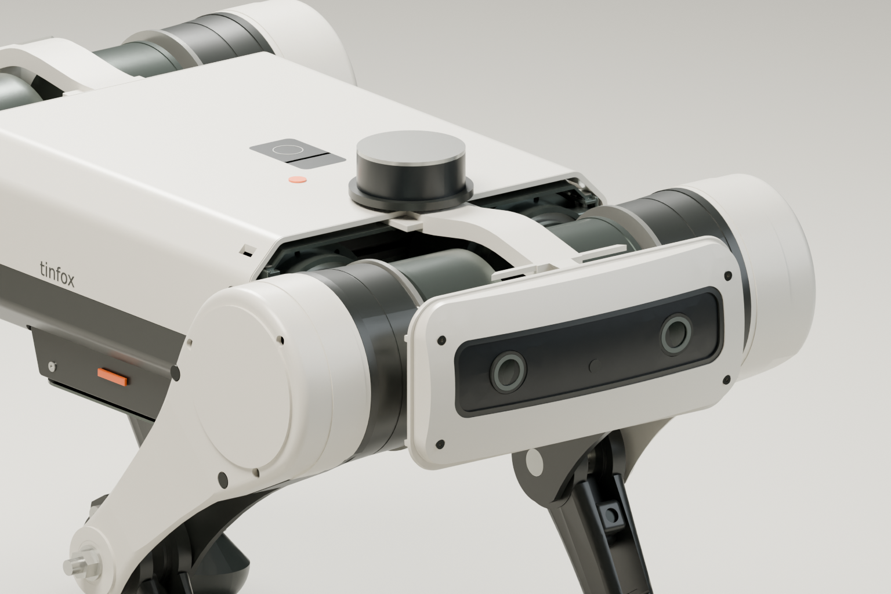
tinfox/proposals/sculpted/design/15-body-detail.png
