pedapudi/oddstride/tinfox/proposals/sculpted/design/20-face-profile.png

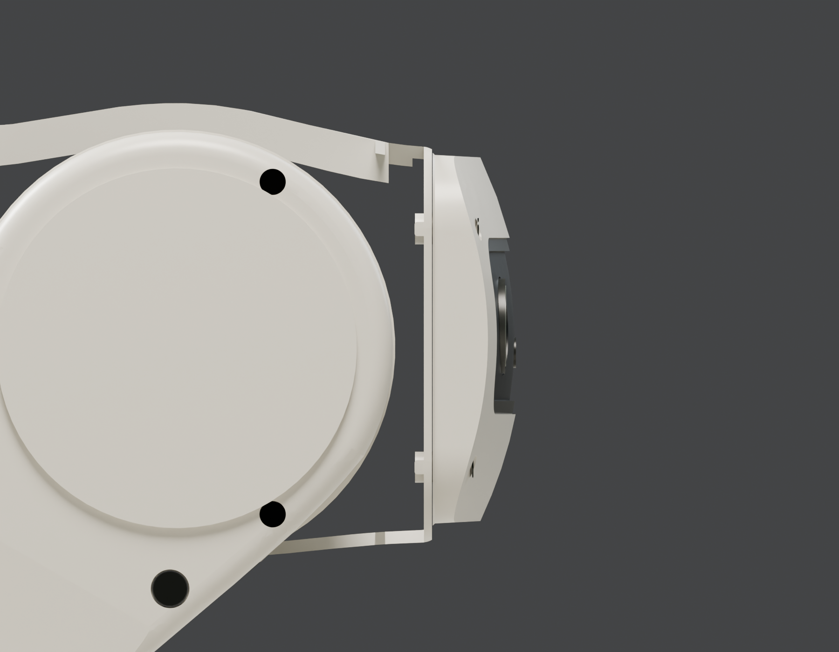
tinfox/proposals/sculpted/design/20-face-profile.png
