pedapudi/oddstride/tinfox/proposals/sculpted/model/fusion_native/audits/cohesive-leg-silhouettes.png

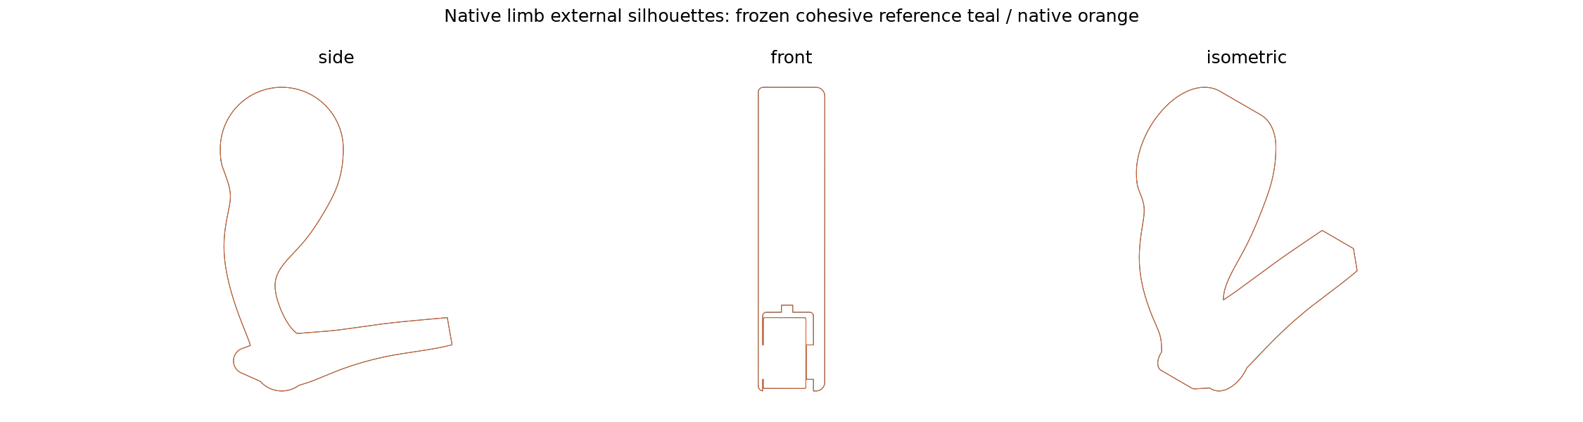
tinfox/proposals/sculpted/model/fusion_native/audits/cohesive-leg-silhouettes.png
