pedapudi/oddstride/tinfox/proposals/sculpted/model/fusion_native/audits/cohesive-shin-silhouettes.png

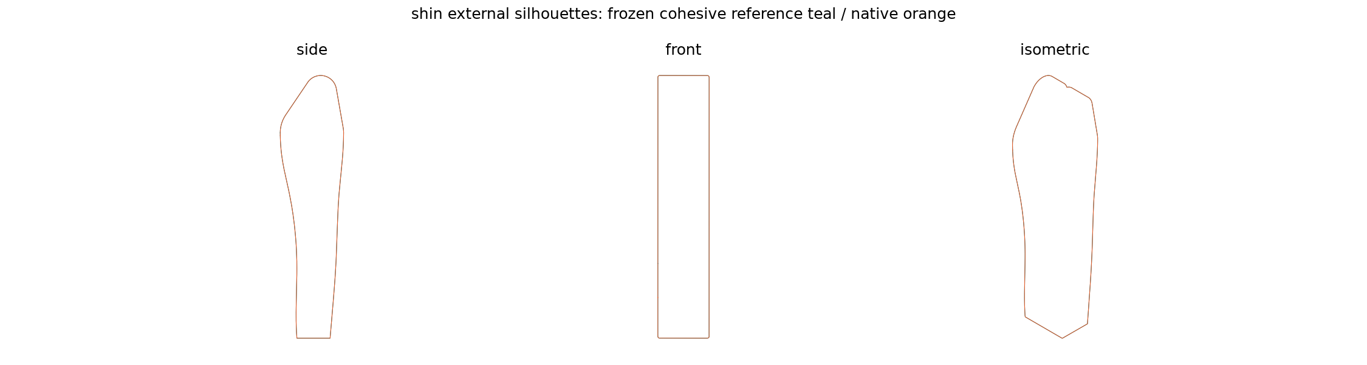
tinfox/proposals/sculpted/model/fusion_native/audits/cohesive-shin-silhouettes.png
