pedapudi/oddstride/tinfox/proposals/sculpted/model/fusion_native/audits/corrected-bench-browser.png

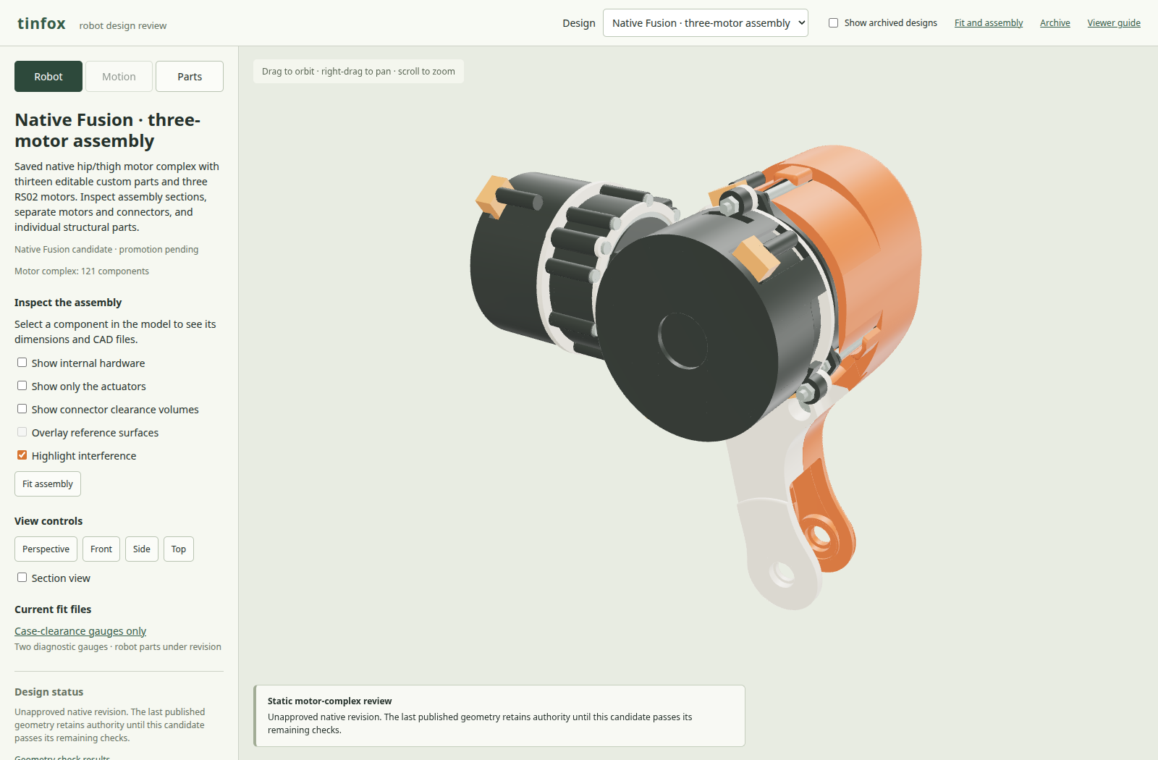
tinfox/proposals/sculpted/model/fusion_native/audits/corrected-bench-browser.png
