pedapudi/oddstride/tinfox/proposals/sculpted/model/fusion_native/audits/dfma-master64-browser.png

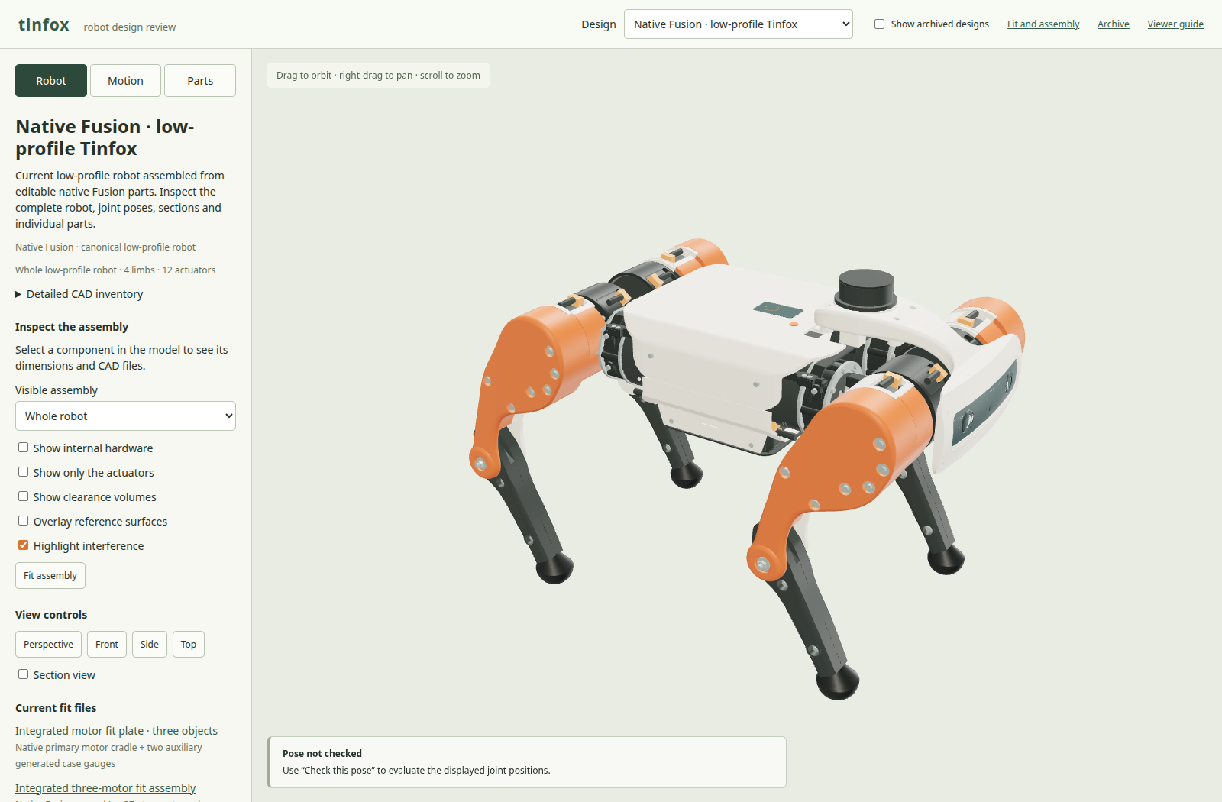
tinfox/proposals/sculpted/model/fusion_native/audits/dfma-master64-browser.png
