pedapudi/oddstride/tinfox/proposals/sculpted/model/fusion_native/audits/head-silhouettes.png

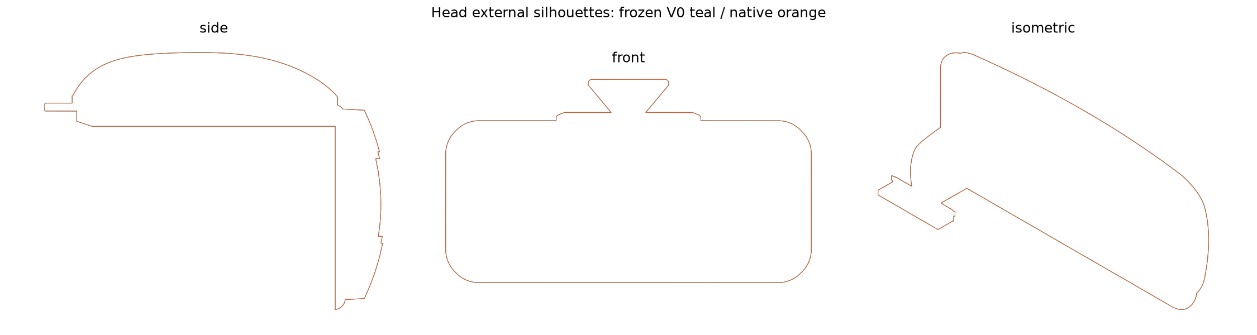
tinfox/proposals/sculpted/model/fusion_native/audits/head-silhouettes.png
