pedapudi/oddstride/tinfox/proposals/sculpted/model/fusion_native/audits/whole-browser-candidate/native-candidate-front.png

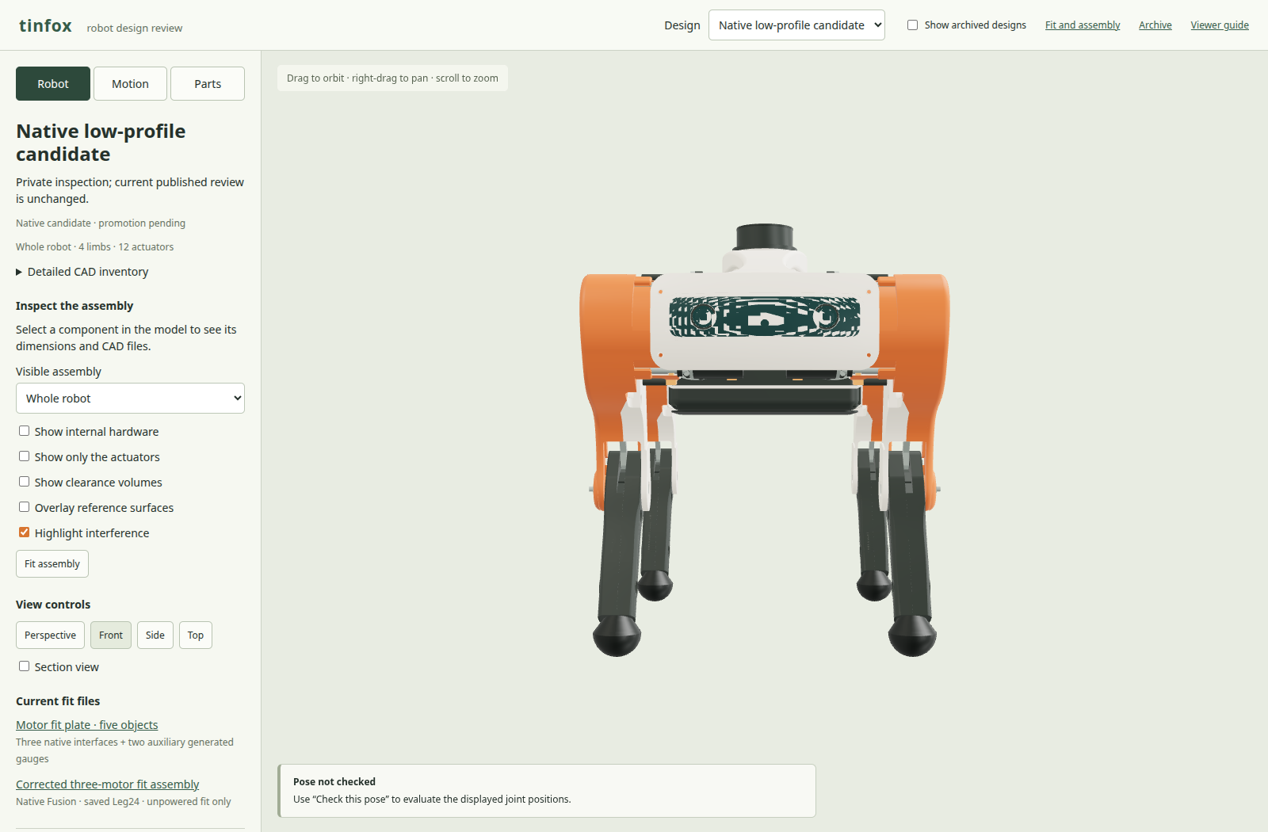
tinfox/proposals/sculpted/model/fusion_native/audits/whole-browser-candidate/native-candidate-front.png
