pedapudi/oddstride/tinfox/proposals/sculpted/model/fusion_native/audits/whole-browser-candidate/native-candidate-side.png

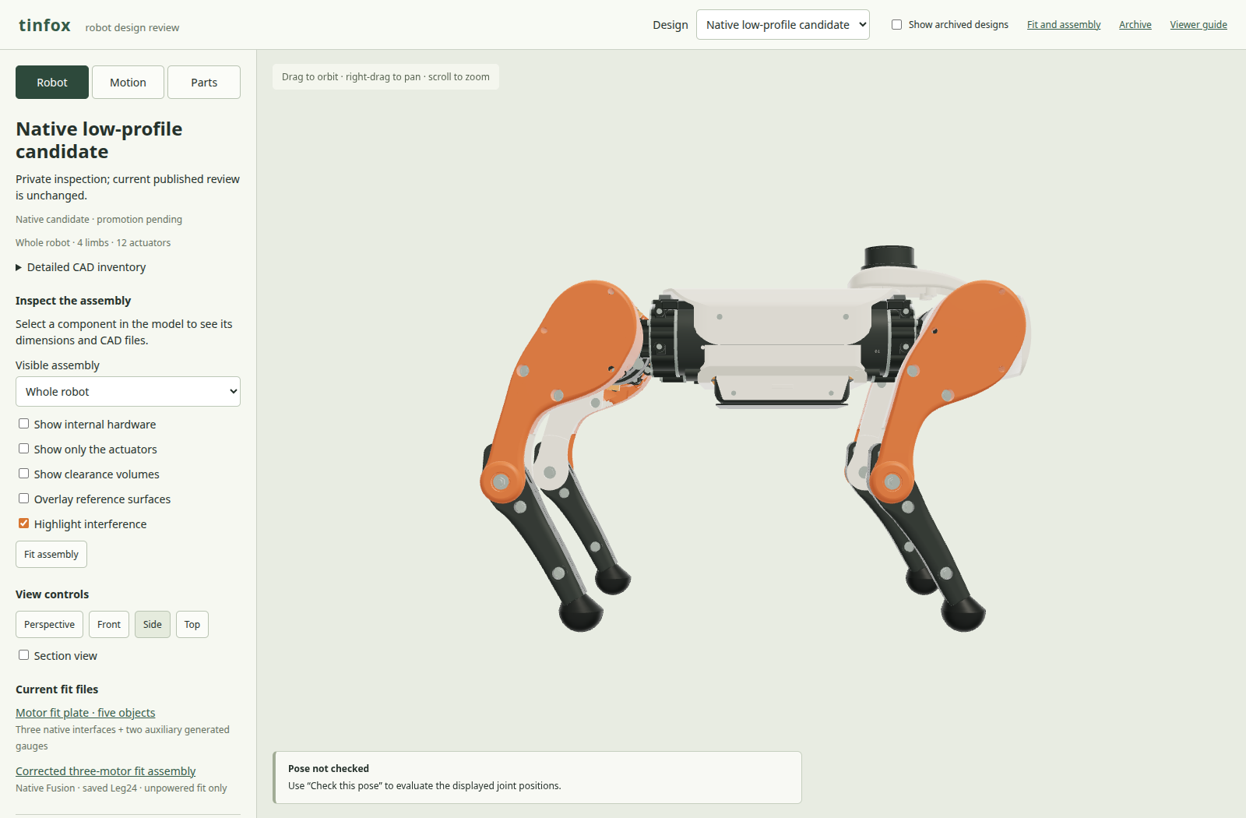
tinfox/proposals/sculpted/model/fusion_native/audits/whole-browser-candidate/native-candidate-side.png
