pedapudi/oddstride/tinfox/proposals/sculpted/model/fusion_native/exports/dfma-architecture-v1/dfma-bearing-cup-proposal.png

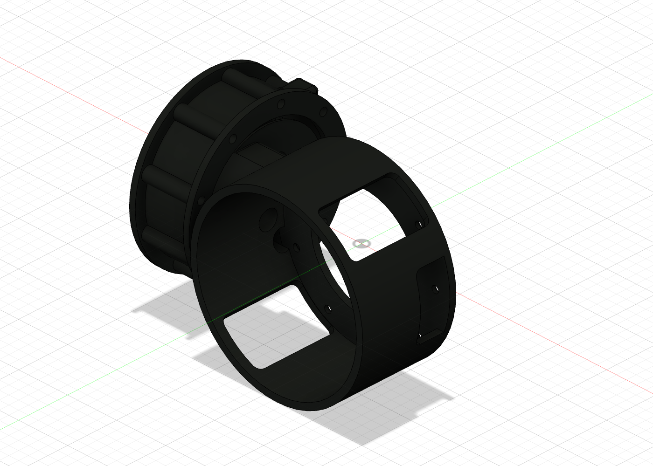
tinfox/proposals/sculpted/model/fusion_native/exports/dfma-architecture-v1/dfma-bearing-cup-proposal.png
