pedapudi/oddstride/tinfox/proposals/sculpted/model/fusion_native/exports/dfma-architecture-v1/dfma-integrated-motor-complex.png

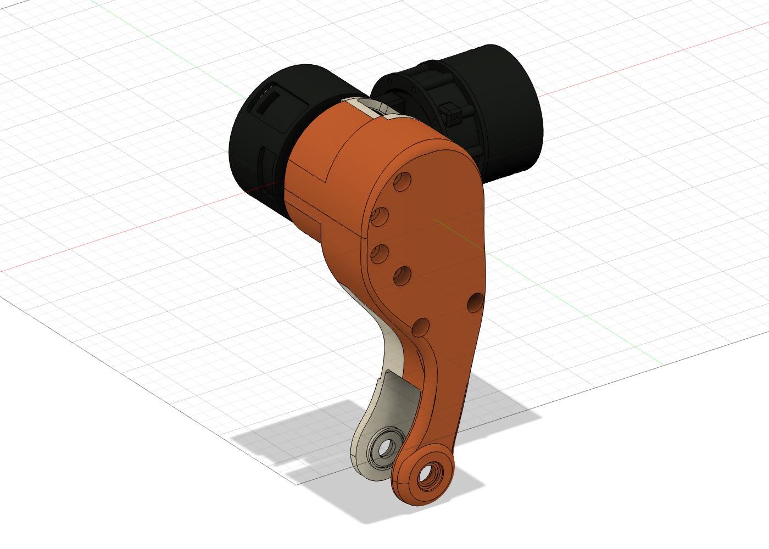
tinfox/proposals/sculpted/model/fusion_native/exports/dfma-architecture-v1/dfma-integrated-motor-complex.png
