pedapudi/oddstride/tinfox/proposals/sculpted/model/fusion_native/exports/dfma-architecture-v1/dfma-thigh-round-inboard-open.png

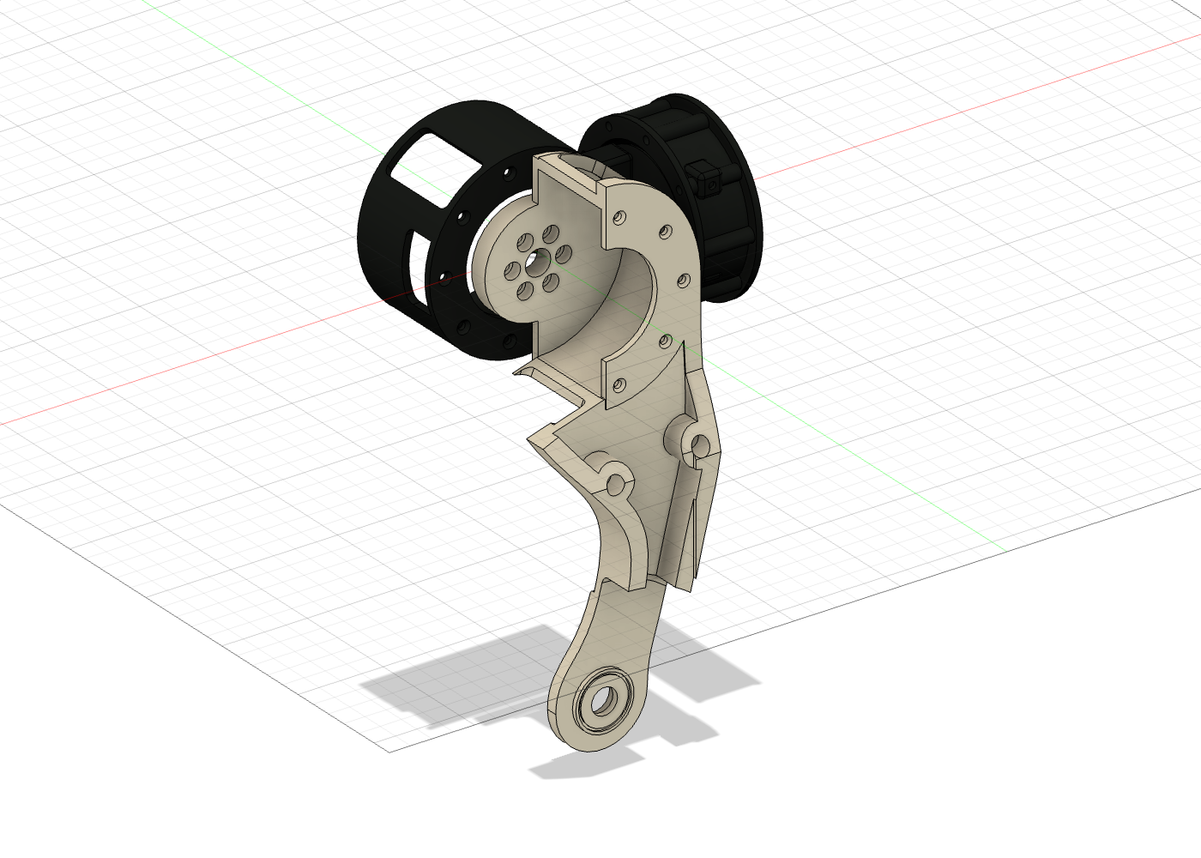
tinfox/proposals/sculpted/model/fusion_native/exports/dfma-architecture-v1/dfma-thigh-round-inboard-open.png
