pedapudi/oddstride/tinfox/proposals/sculpted/model/fusion_native/exports/Tinfox-Head-native-checkpoint.png

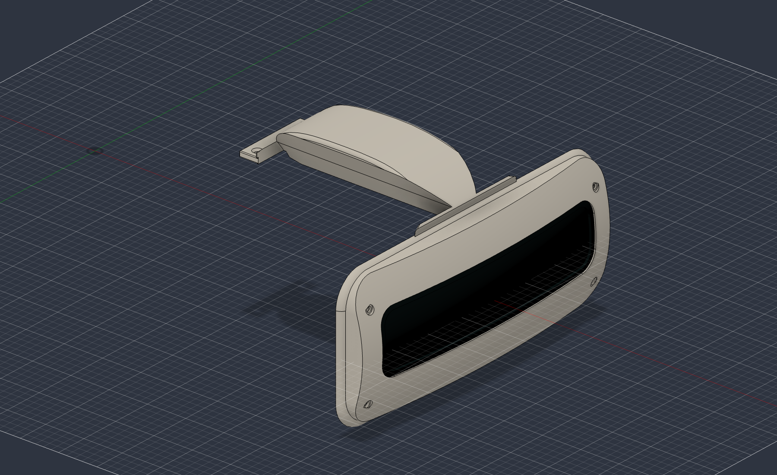
tinfox/proposals/sculpted/model/fusion_native/exports/Tinfox-Head-native-checkpoint.png
