pedapudi/oddstride/tinfox/proposals/sculpted/model/fusion_native/exports/Tinfox-native-robot-candidate.png

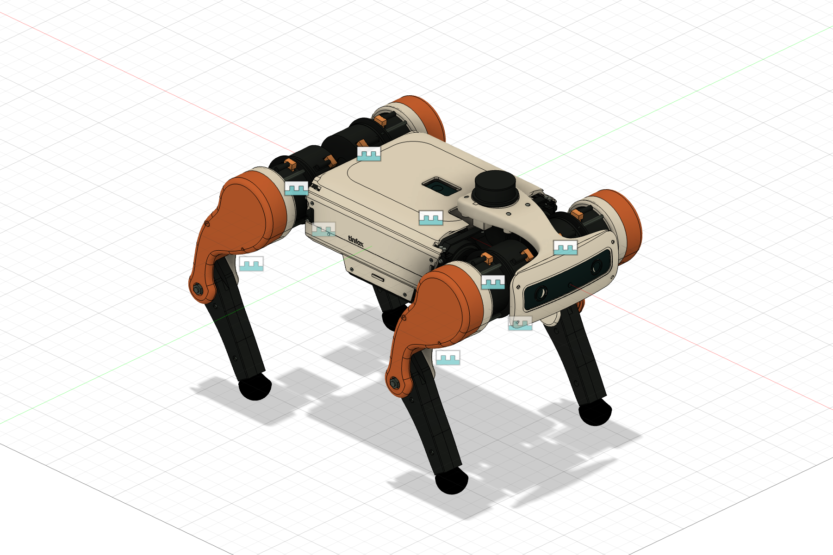
tinfox/proposals/sculpted/model/fusion_native/exports/Tinfox-native-robot-candidate.png
