pedapudi/oddstride/tinfox/proposals/sculpted/model/output/chassis_lower_brace-review.png

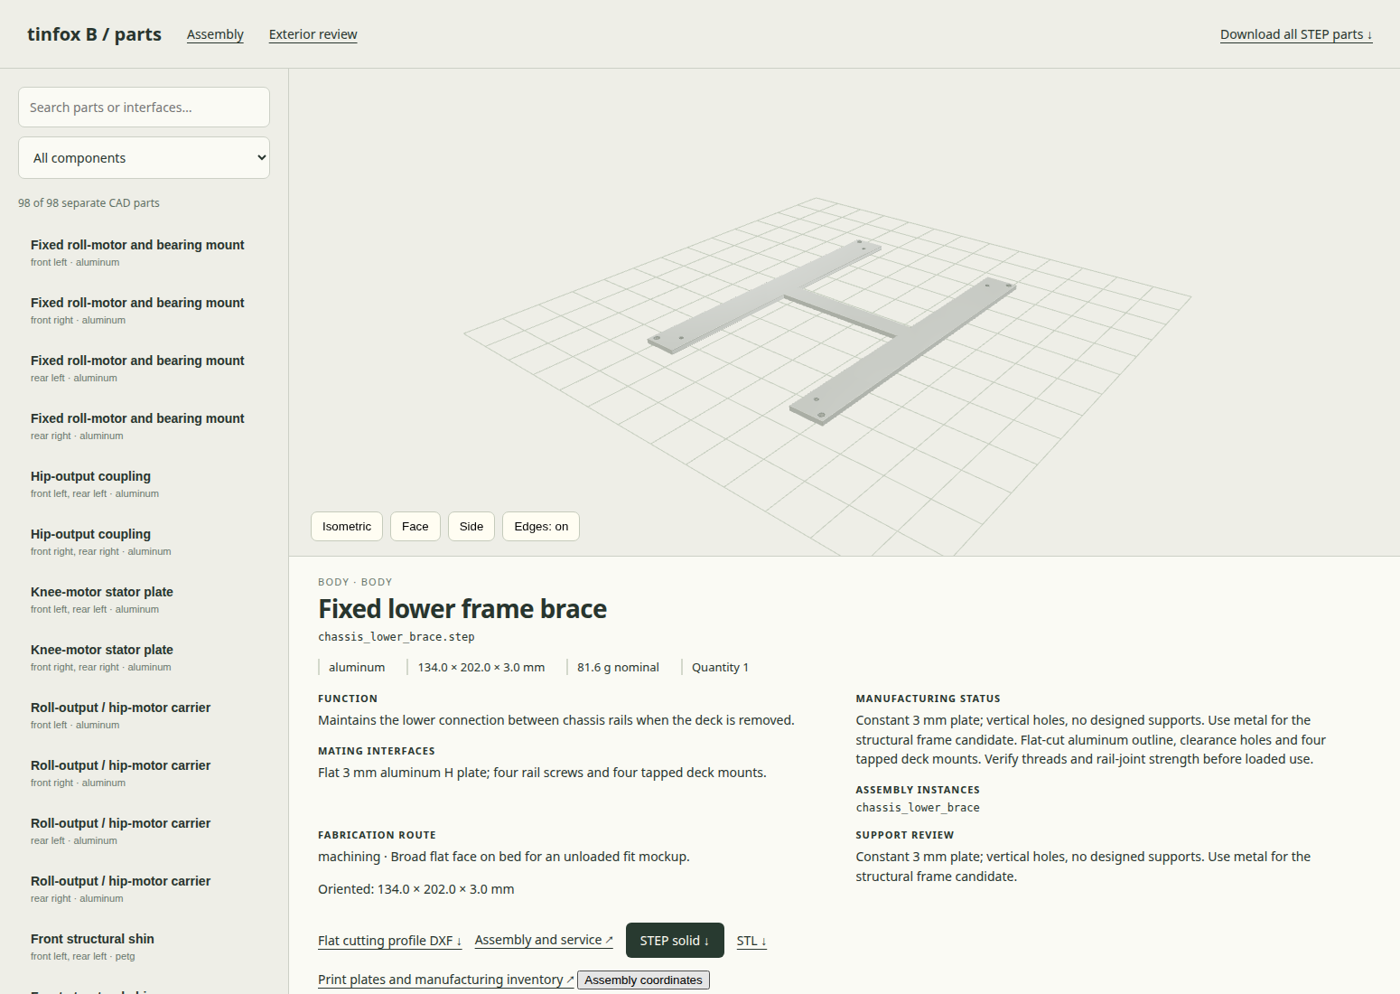
tinfox/proposals/sculpted/model/output/chassis_lower_brace-review.png
