pedapudi/oddstride/tinfox/proposals/sculpted/model/output/deck-service-stage-2.png

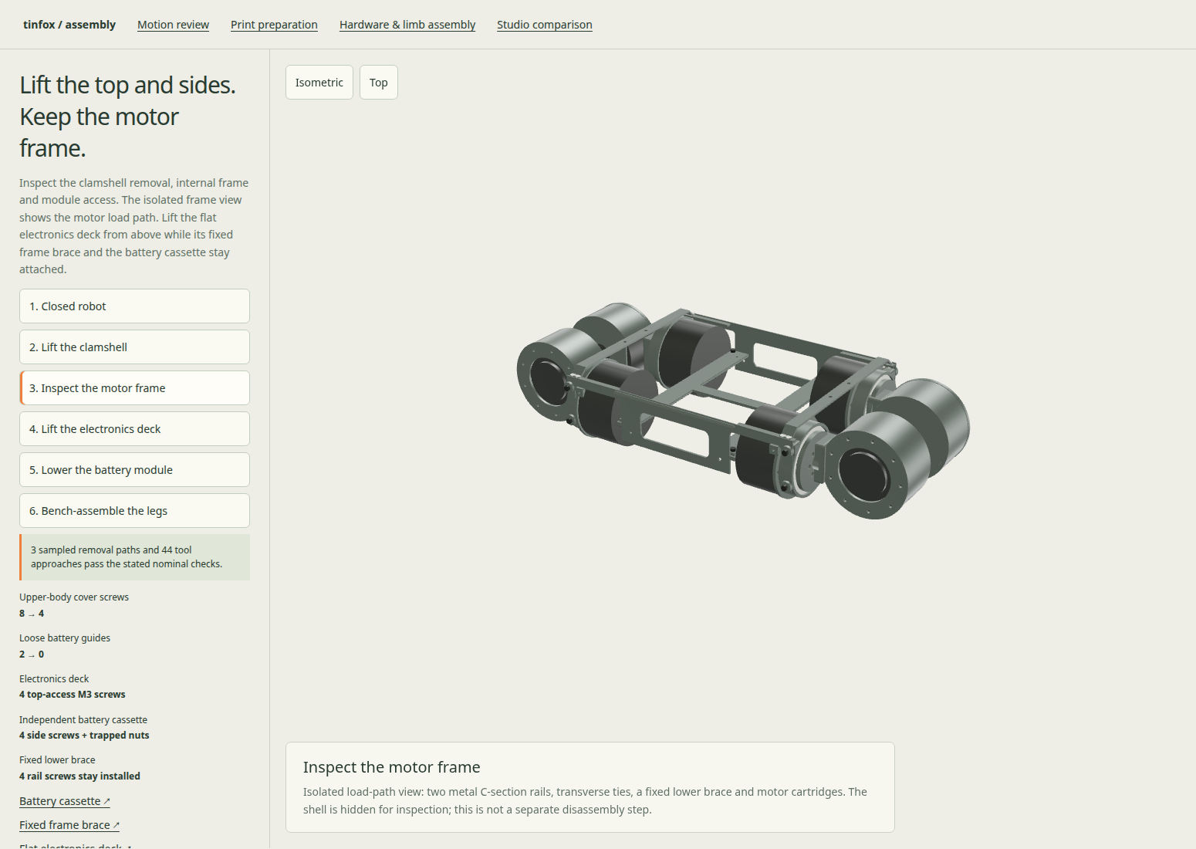
tinfox/proposals/sculpted/model/output/deck-service-stage-2.png
