pedapudi/oddstride/tinfox/proposals/sculpted/model/output/deck-service-stage-3.png

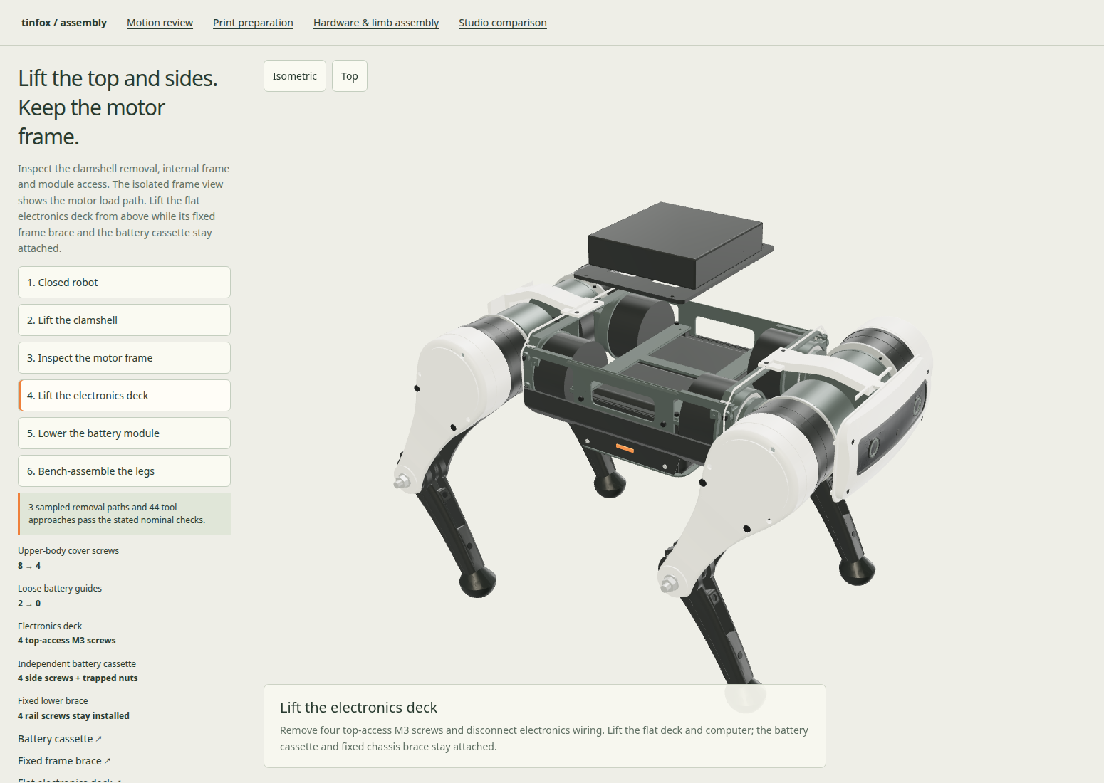
tinfox/proposals/sculpted/model/output/deck-service-stage-3.png
