pedapudi/oddstride/tinfox/proposals/sculpted/model/output/deck-service-stage-4.png

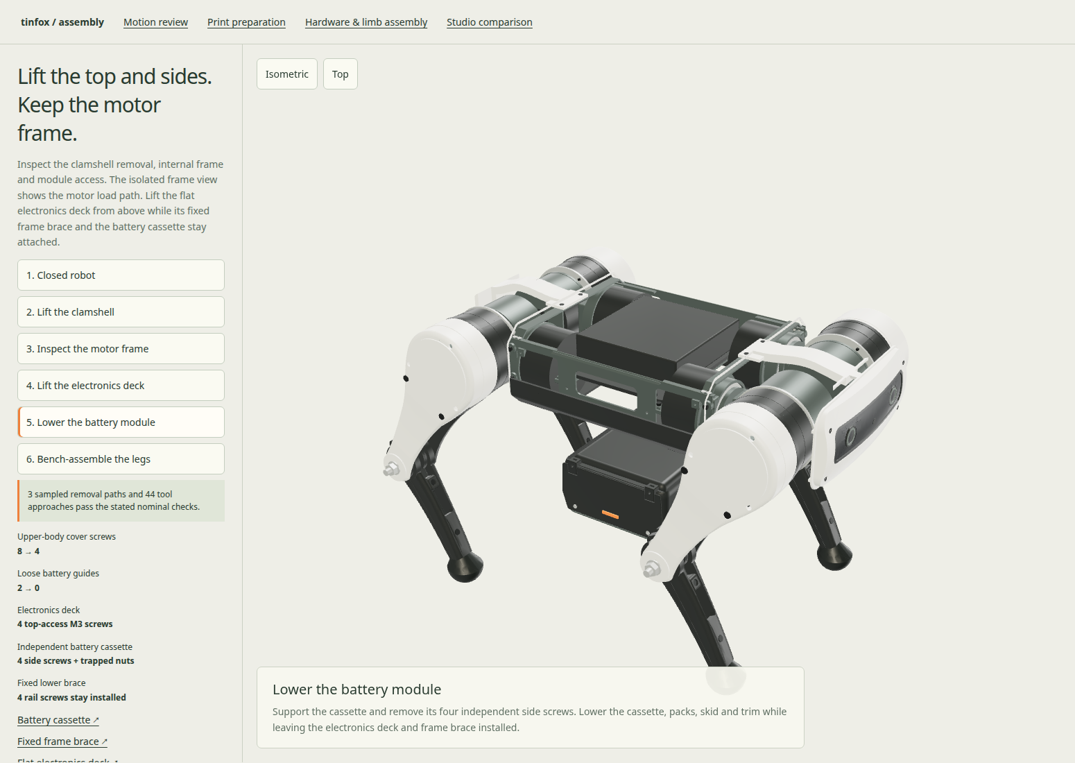
tinfox/proposals/sculpted/model/output/deck-service-stage-4.png
