pedapudi/oddstride/tinfox/proposals/sculpted/model/output/exterior-preview.png

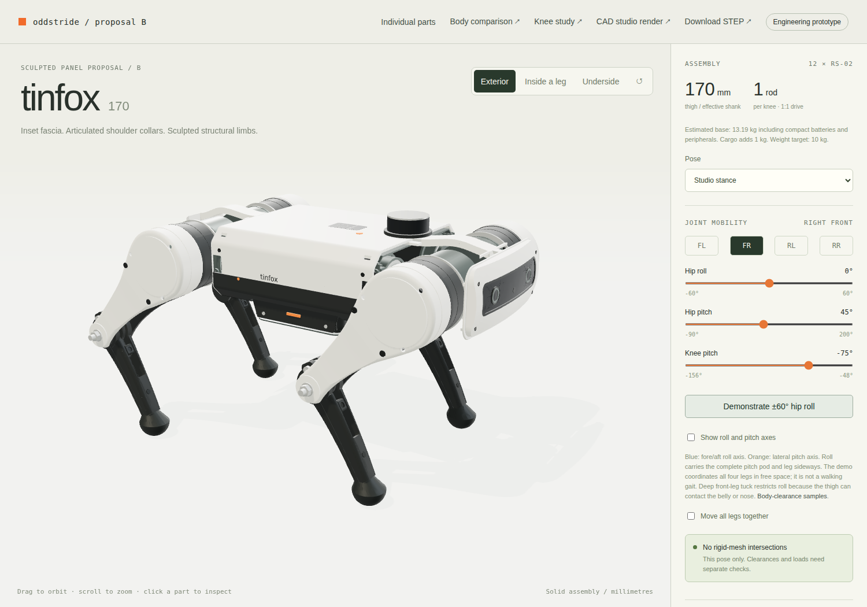
tinfox/proposals/sculpted/model/output/exterior-preview.png
