pedapudi/oddstride/tinfox/proposals/sculpted/model/output/front-fascia-preview.png

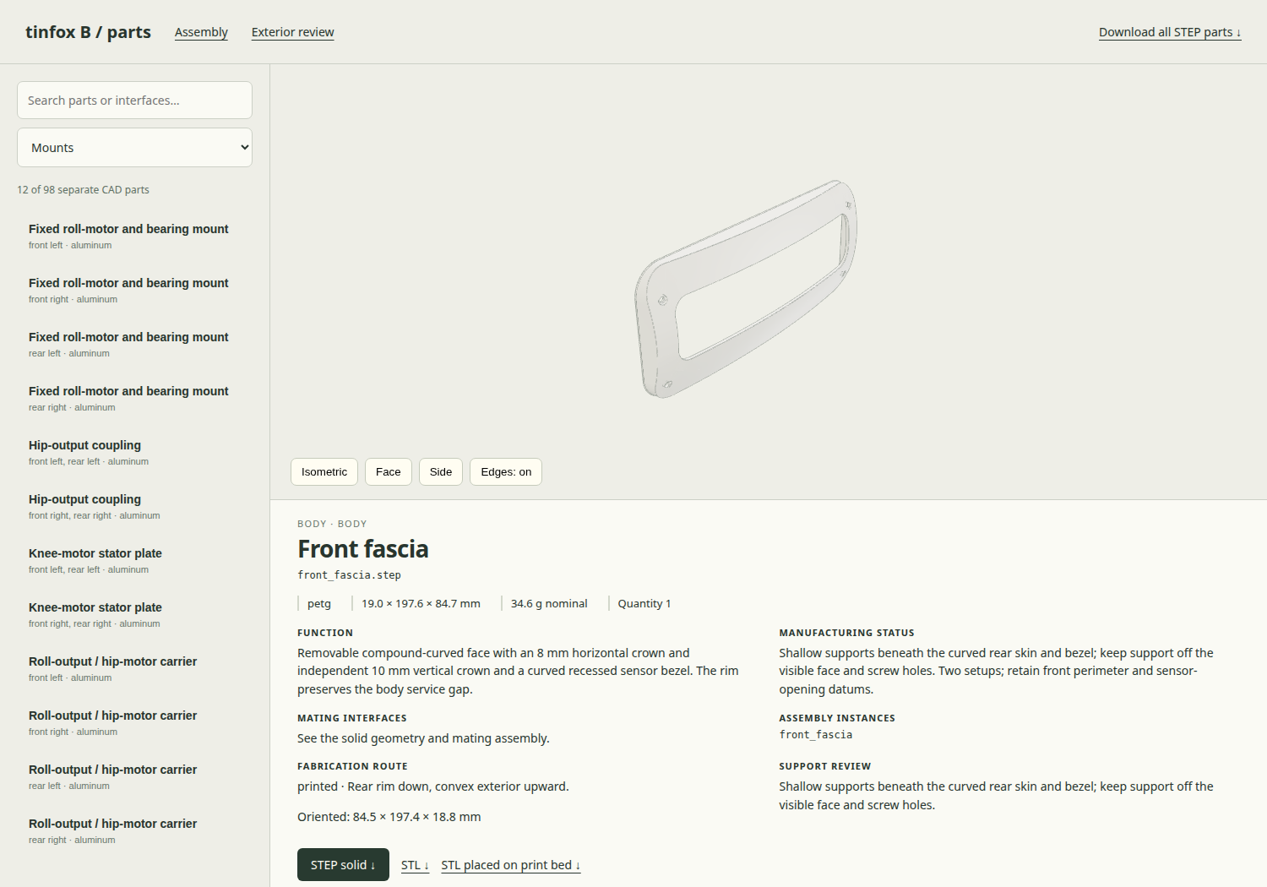
tinfox/proposals/sculpted/model/output/front-fascia-preview.png
