pedapudi/oddstride/tinfox/proposals/sculpted/model/output/hardware-review-preview.png

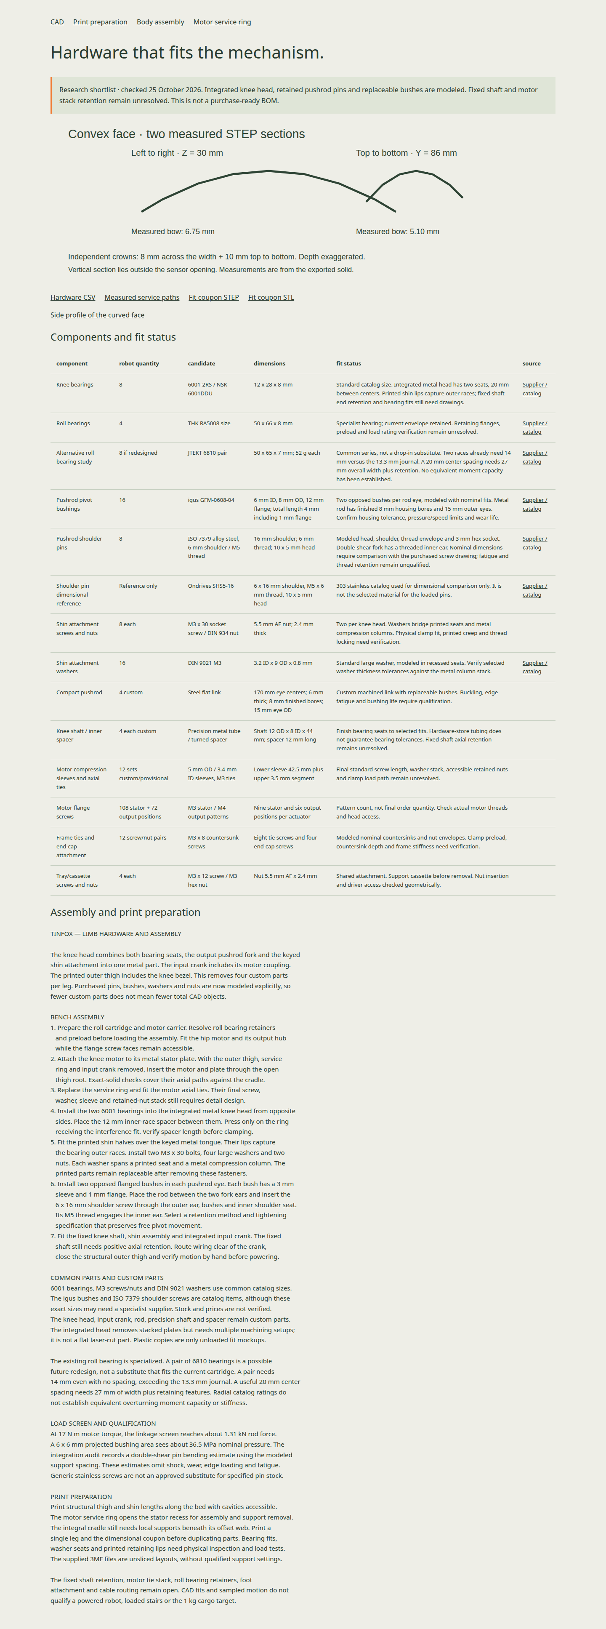
tinfox/proposals/sculpted/model/output/hardware-review-preview.png
