pedapudi/oddstride/tinfox/proposals/sculpted/model/output/limb-variants/cnc/carrier-service-preview.png

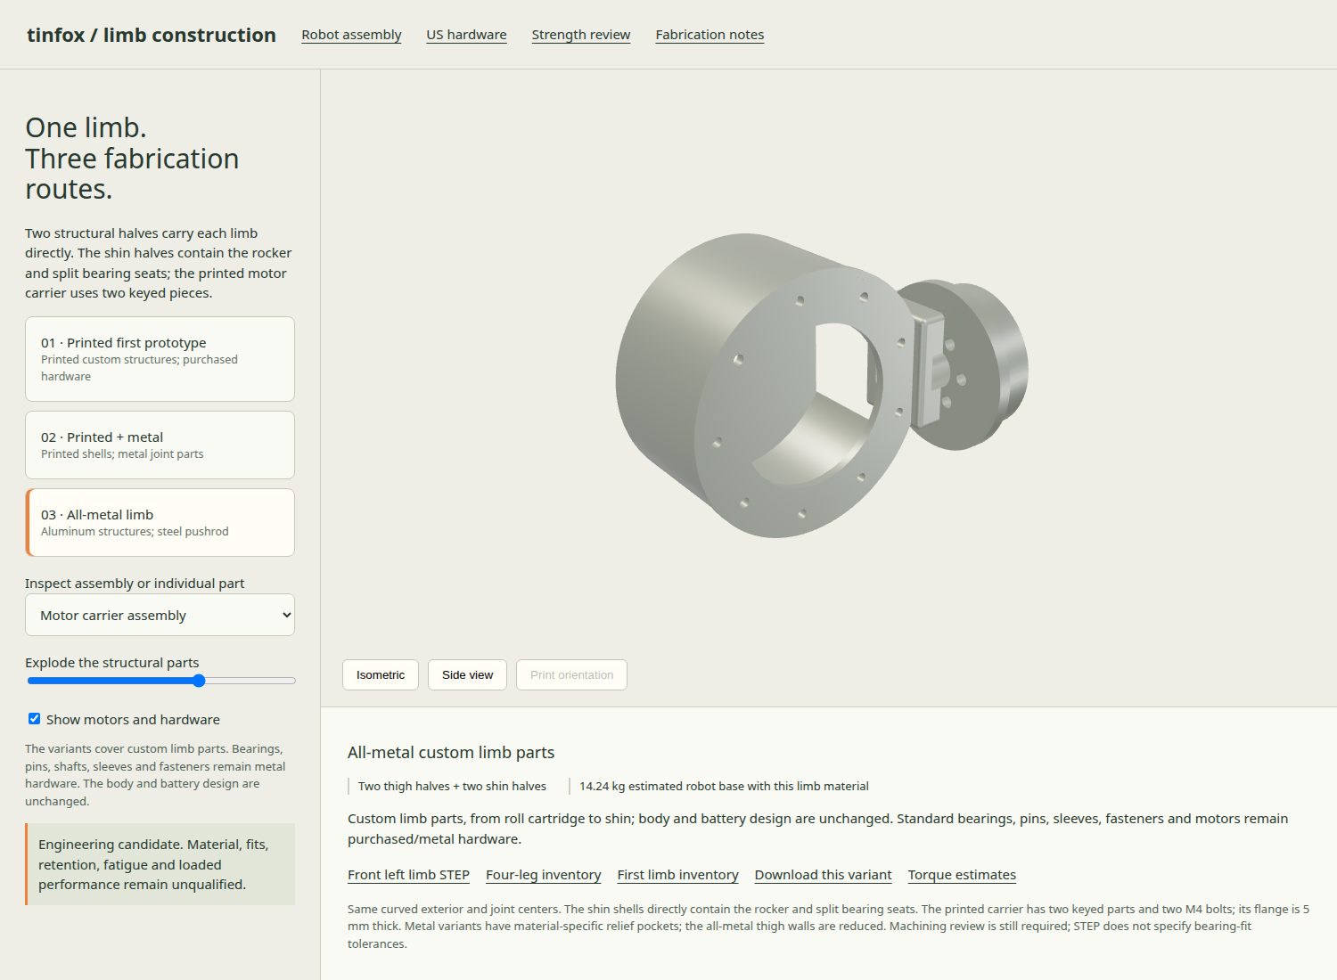
tinfox/proposals/sculpted/model/output/limb-variants/cnc/carrier-service-preview.png
