pedapudi/oddstride/tinfox/proposals/sculpted/model/output/limb-variants/cnc/shin-preview.png

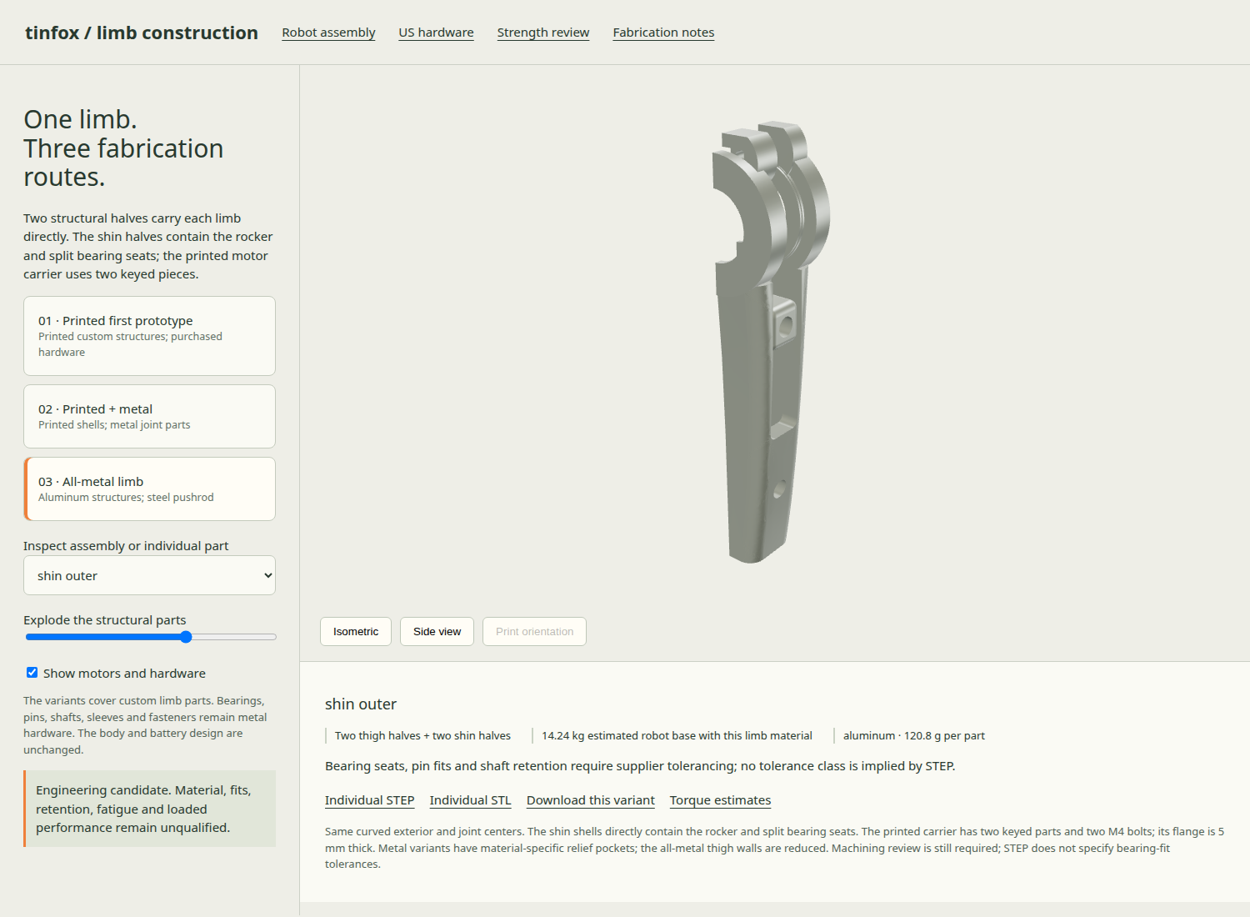
tinfox/proposals/sculpted/model/output/limb-variants/cnc/shin-preview.png
