pedapudi/oddstride/tinfox/proposals/sculpted/model/output/limb-variants/hybrid/knee-service-preview.png

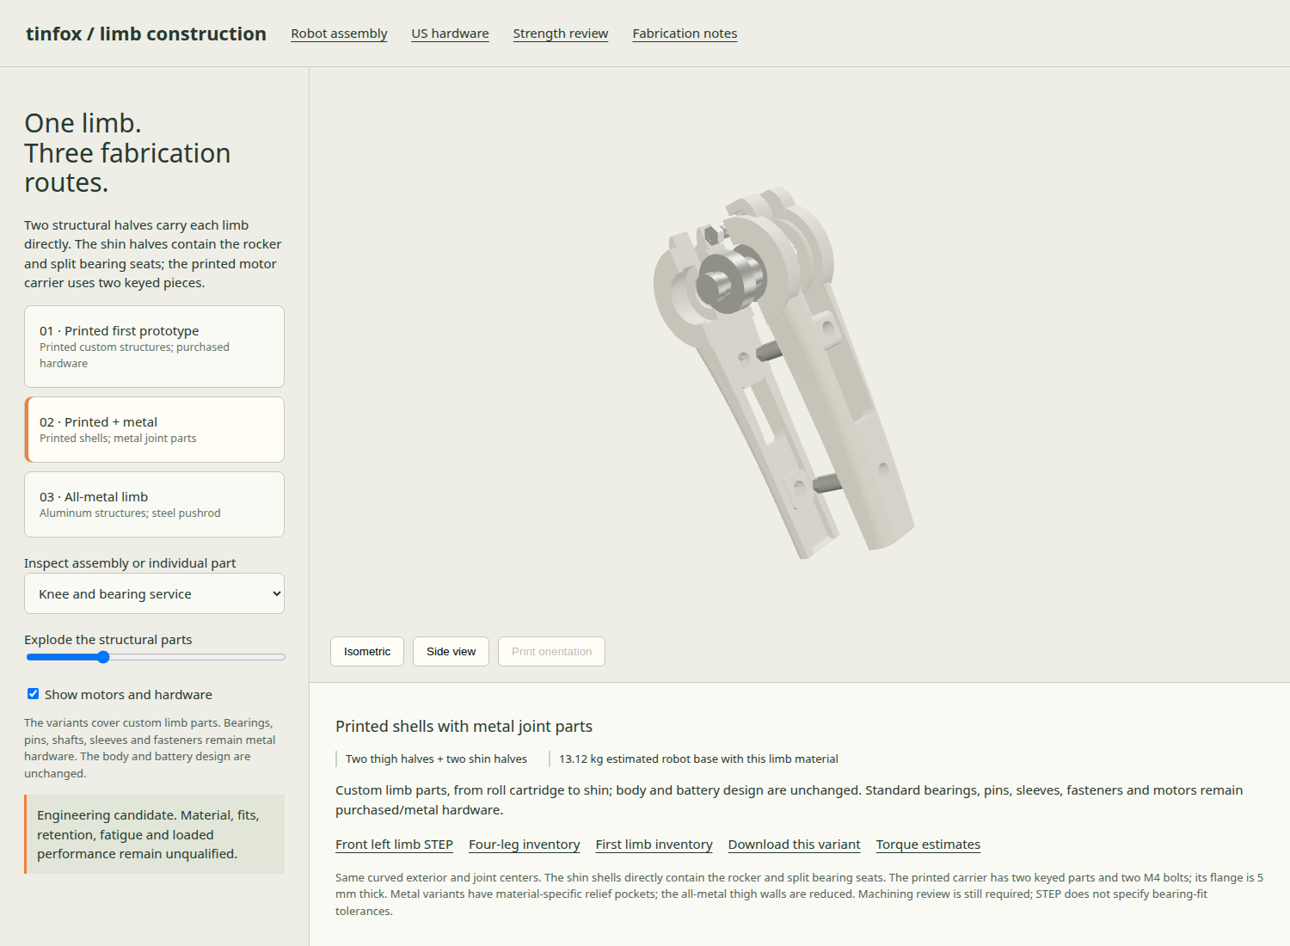
tinfox/proposals/sculpted/model/output/limb-variants/hybrid/knee-service-preview.png
