pedapudi/oddstride/tinfox/proposals/sculpted/model/output/limb-variants/hybrid/shin-preview.png

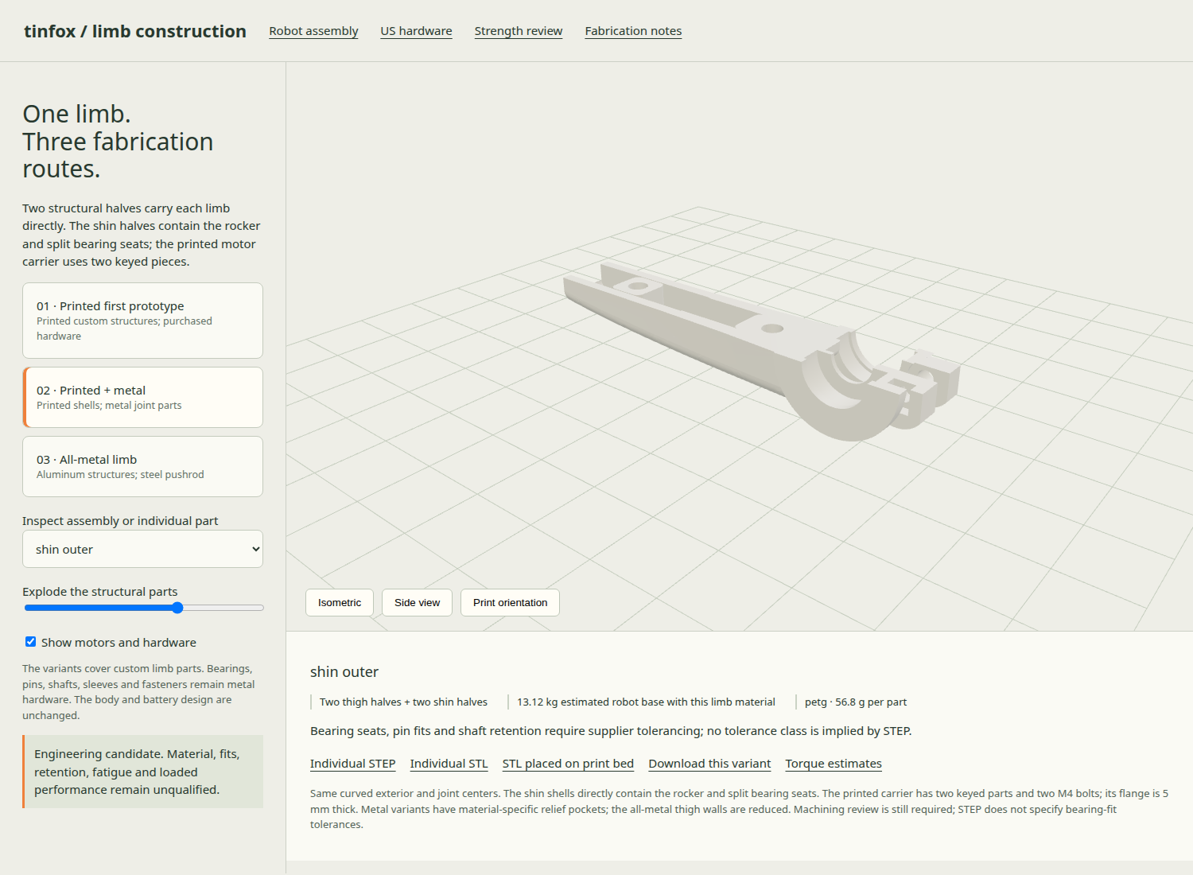
tinfox/proposals/sculpted/model/output/limb-variants/hybrid/shin-preview.png
