pedapudi/oddstride/tinfox/proposals/sculpted/model/output/service-design/review-stage-0.png

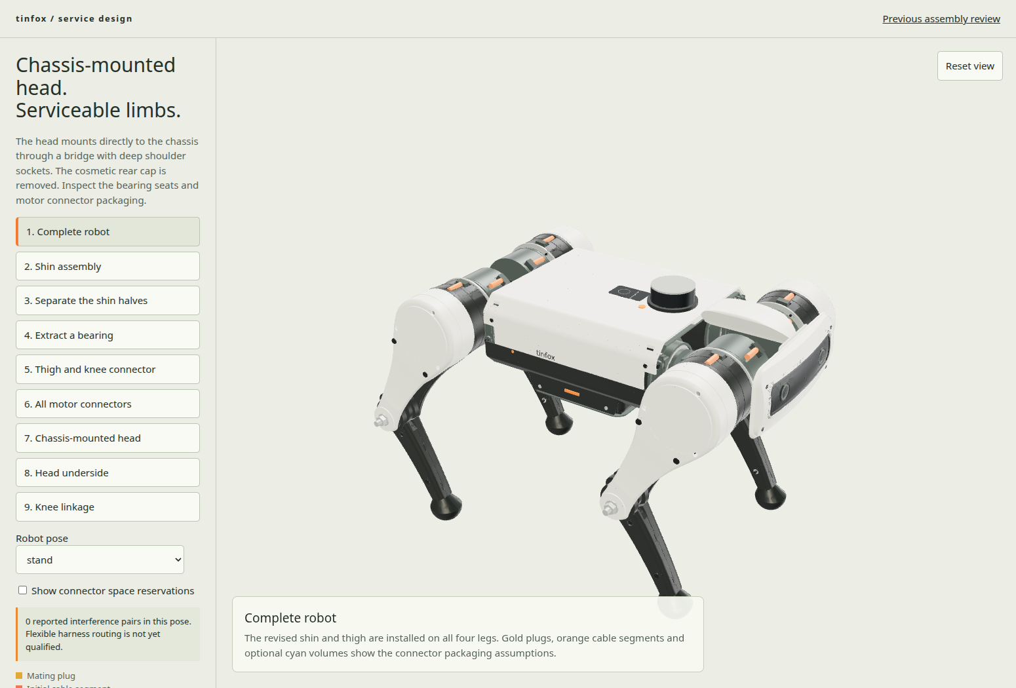
tinfox/proposals/sculpted/model/output/service-design/review-stage-0.png
