pedapudi/oddstride/tinfox/proposals/sculpted/model/output/service-design/review-stage-1.png

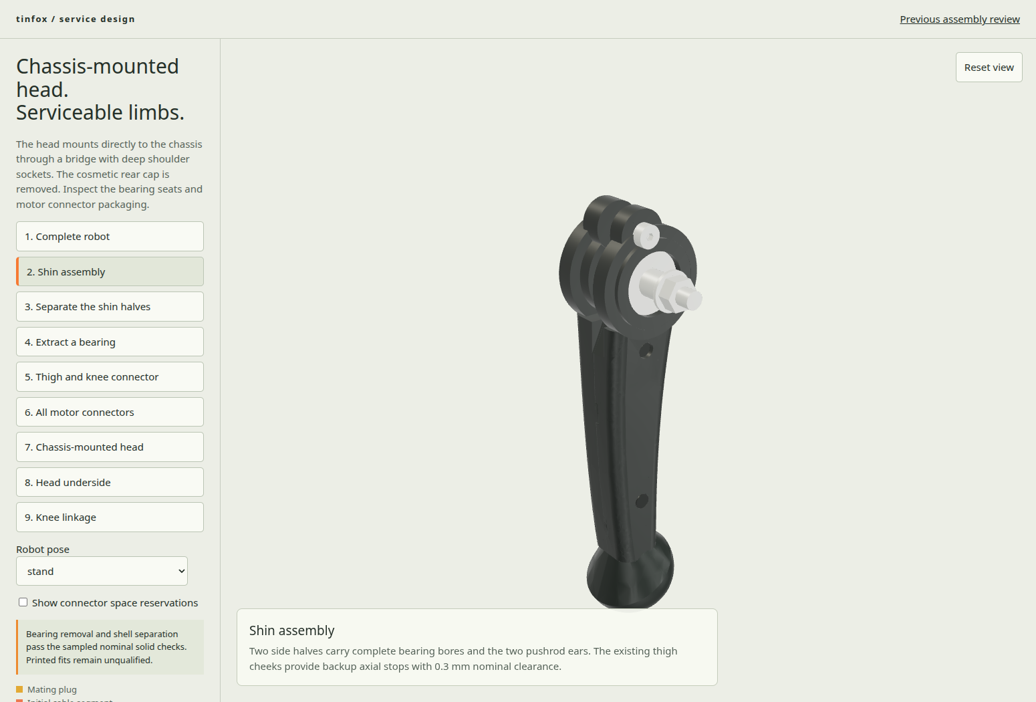
tinfox/proposals/sculpted/model/output/service-design/review-stage-1.png
