pedapudi/oddstride/tinfox/proposals/sculpted/model/output/service-design/review-stage-2.png

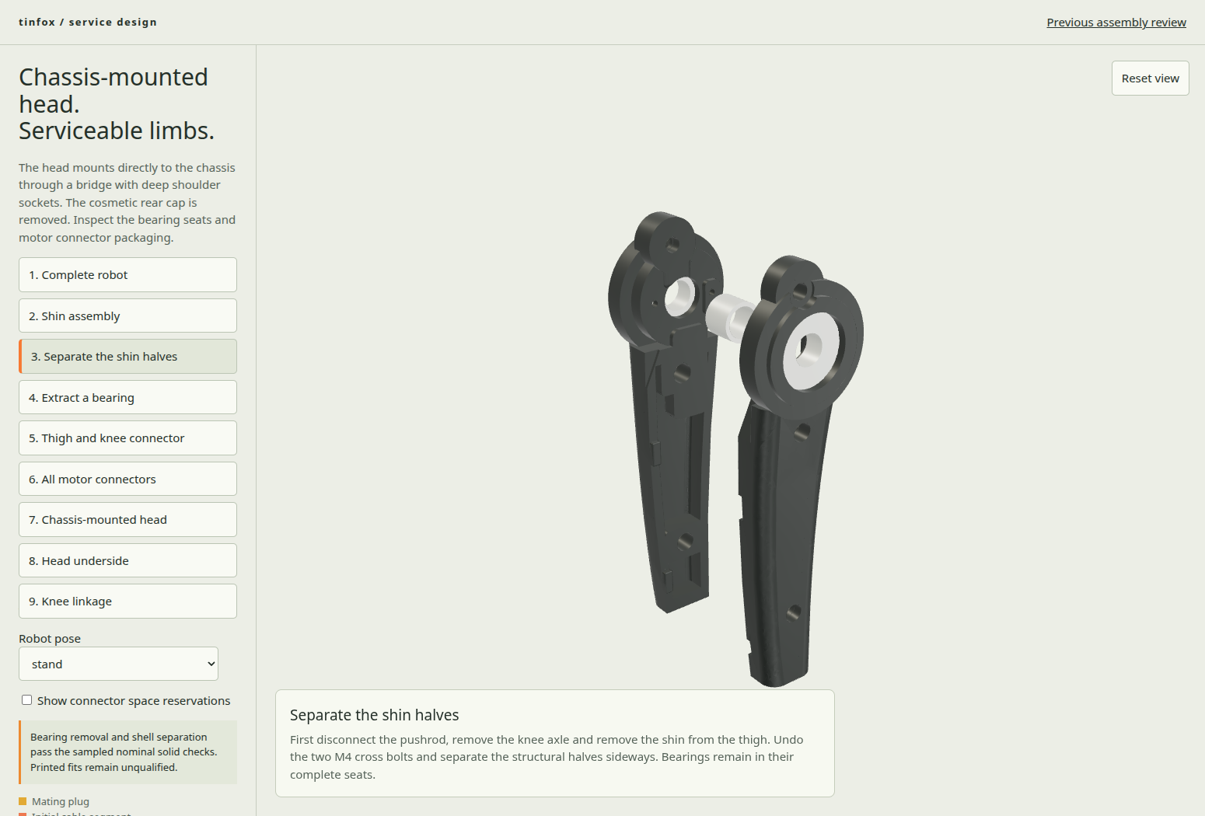
tinfox/proposals/sculpted/model/output/service-design/review-stage-2.png
