pedapudi/oddstride/tinfox/proposals/sculpted/model/output/service-design/review-stage-3.png

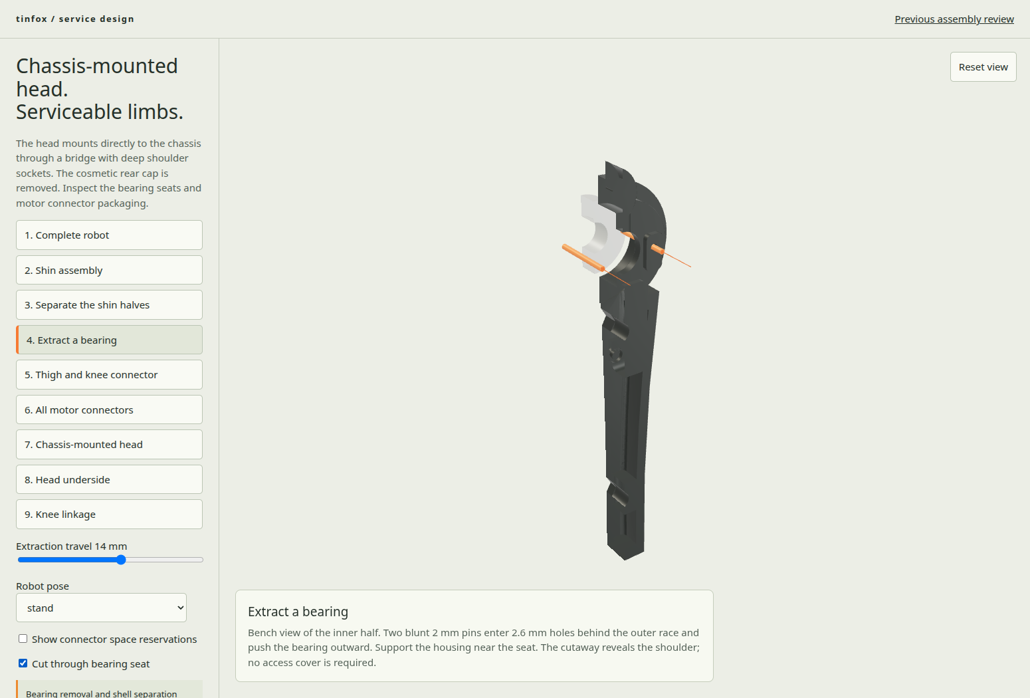
tinfox/proposals/sculpted/model/output/service-design/review-stage-3.png
