pedapudi/oddstride/tinfox/proposals/sculpted/model/output/service-design/review-stage-4.png

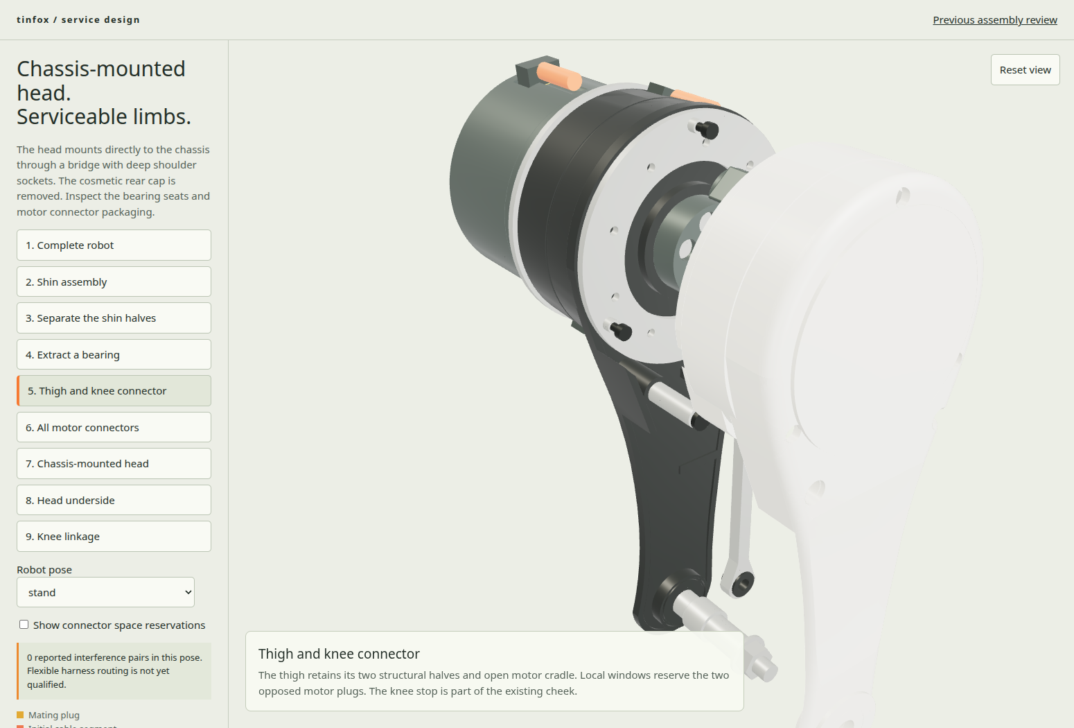
tinfox/proposals/sculpted/model/output/service-design/review-stage-4.png
