pedapudi/oddstride/tinfox/proposals/sculpted/model/output/service-design/review-stage-5.png

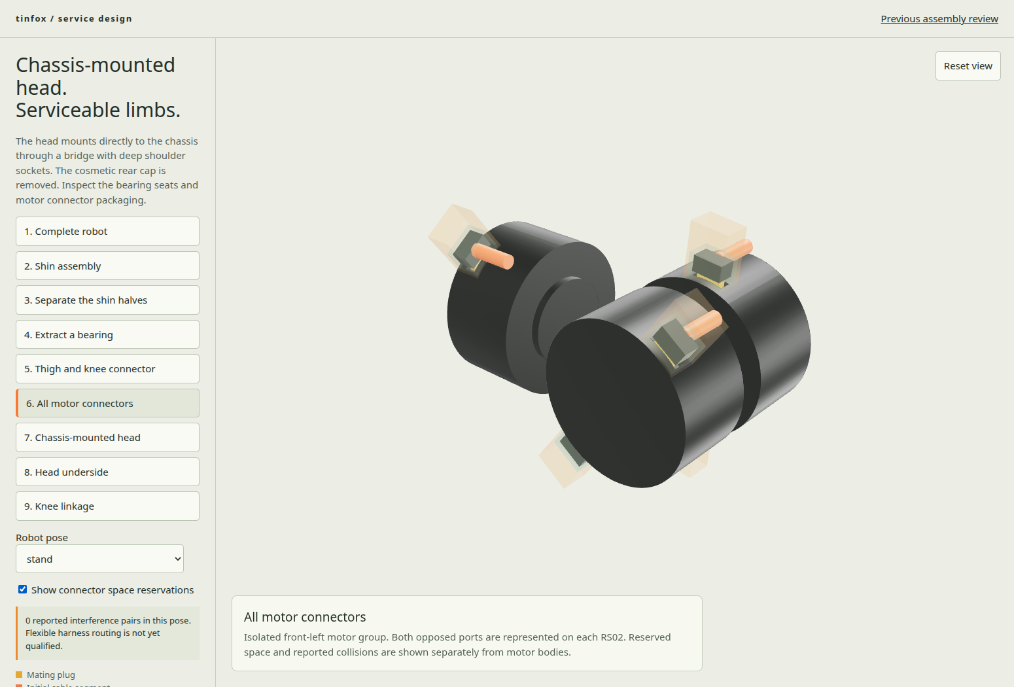
tinfox/proposals/sculpted/model/output/service-design/review-stage-5.png
