pedapudi/oddstride/tinfox/proposals/sculpted/model/output/service-design/review-stage-6.png

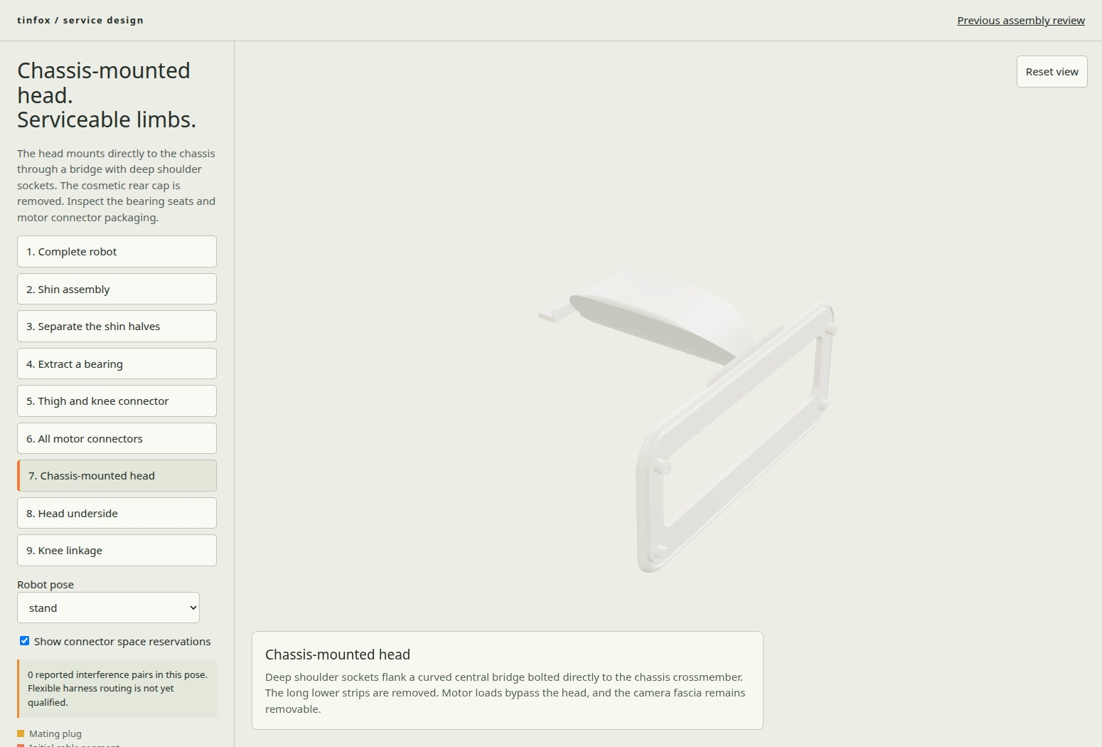
tinfox/proposals/sculpted/model/output/service-design/review-stage-6.png
