pedapudi/oddstride/tinfox/proposals/sculpted/model/output/service-design/review-stage-7.png

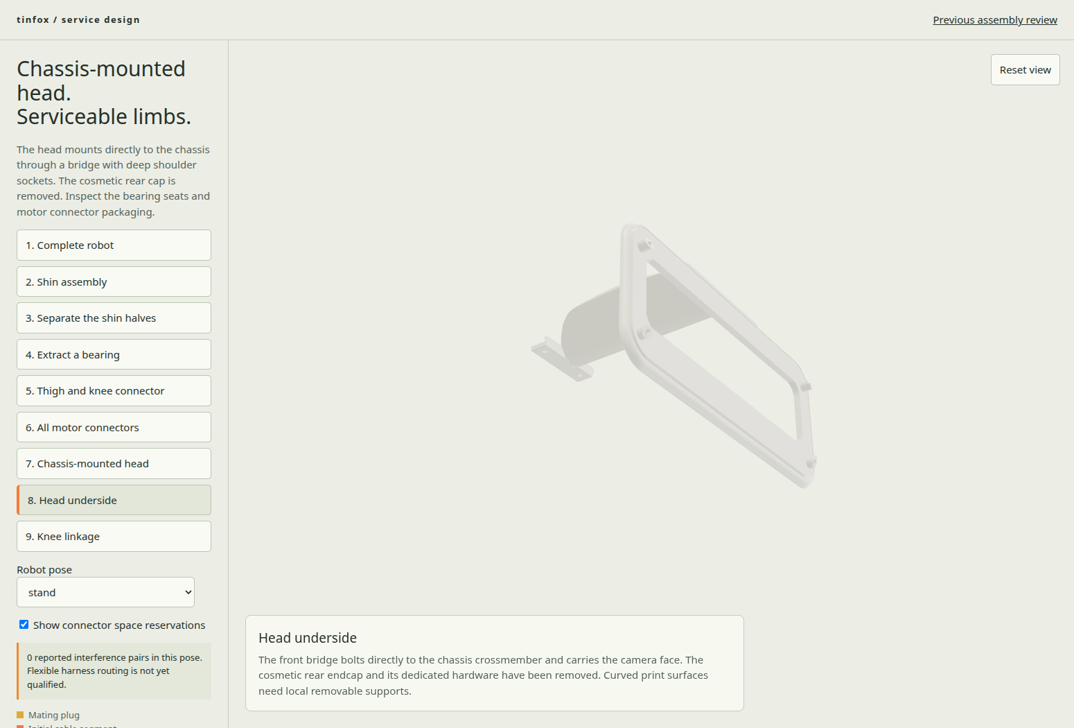
tinfox/proposals/sculpted/model/output/service-design/review-stage-7.png
