pedapudi/oddstride/tinfox/model/output/parts.csv

part | quantity | material | each_mass_kg | status
FL_hip_output_bolt_0 | 1 | steel | 0.001208 | Recessed M4 socket-head envelope; screw length and actuator thread engagement require supplier confirmation.
FL_hip_output_bolt_120 | 1 | steel | 0.001208 | Recessed M4 socket-head envelope; screw length and actuator thread engagement require supplier confirmation.
FL_hip_output_bolt_180 | 1 | steel | 0.001208 | Recessed M4 socket-head envelope; screw length and actuator thread engagement require supplier confirmation.
FL_hip_output_bolt_240 | 1 | steel | 0.001208 | Recessed M4 socket-head envelope; screw length and actuator thread engagement require supplier confirmation.
FL_hip_output_bolt_300 | 1 | steel | 0.001208 | Recessed M4 socket-head envelope; screw length and actuator thread engagement require supplier confirmation.
FL_hip_output_bolt_60 | 1 | steel | 0.001208 | Recessed M4 socket-head envelope; screw length and actuator thread engagement require supplier confirmation.
FL_input_bolt_0 | 1 | steel | 0.000783 | Recessed M4 low-head envelope; 0.6 mm below crank face. Select screw length after confirming motor engagement.
FL_input_bolt_120 | 1 | steel | 0.000783 | Recessed M4 low-head envelope; 0.6 mm below crank face. Select screw length after confirming motor engagement.
FL_input_bolt_180 | 1 | steel | 0.000783 | Recessed M4 low-head envelope; 0.6 mm below crank face. Select screw length after confirming motor engagement.
FL_input_bolt_240 | 1 | steel | 0.000783 | Recessed M4 low-head envelope; 0.6 mm below crank face. Select screw length after confirming motor engagement.
FL_input_bolt_300 | 1 | steel | 0.000783 | Recessed M4 low-head envelope; 0.6 mm below crank face. Select screw length after confirming motor engagement.
FL_input_bolt_60 | 1 | steel | 0.000783 | Recessed M4 low-head envelope; 0.6 mm below crank face. Select screw length after confirming motor engagement.
FL_roll_bearing | 1 | steel | 0.08 | Geometry prototype; manufacturing qualification outstanding.
FR_hip_output_bolt_0_right | 1 | steel | 0.001208 | Recessed M4 socket-head envelope; screw length and actuator thread engagement require supplier confirmation.
FR_hip_output_bolt_120_right | 1 | steel | 0.001208 | Recessed M4 socket-head envelope; screw length and actuator thread engagement require supplier confirmation.
FR_hip_output_bolt_180_right | 1 | steel | 0.001208 | Recessed M4 socket-head envelope; screw length and actuator thread engagement require supplier confirmation.
FR_hip_output_bolt_240_right | 1 | steel | 0.001208 | Recessed M4 socket-head envelope; screw length and actuator thread engagement require supplier confirmation.
FR_hip_output_bolt_300_right | 1 | steel | 0.001208 | Recessed M4 socket-head envelope; screw length and actuator thread engagement require supplier confirmation.
FR_hip_output_bolt_60_right | 1 | steel | 0.001208 | Recessed M4 socket-head envelope; screw length and actuator thread engagement require supplier confirmation.
FR_input_bolt_0_right | 1 | steel | 0.000783 | Recessed M4 low-head envelope; 0.6 mm below crank face. Select screw length after confirming motor engagement.
FR_input_bolt_120_right | 1 | steel | 0.000783 | Recessed M4 low-head envelope; 0.6 mm below crank face. Select screw length after confirming motor engagement.
FR_input_bolt_180_right | 1 | steel | 0.000783 | Recessed M4 low-head envelope; 0.6 mm below crank face. Select screw length after confirming motor engagement.
FR_input_bolt_240_right | 1 | steel | 0.000783 | Recessed M4 low-head envelope; 0.6 mm below crank face. Select screw length after confirming motor engagement.
FR_input_bolt_300_right | 1 | steel | 0.000783 | Recessed M4 low-head envelope; 0.6 mm below crank face. Select screw length after confirming motor engagement.
FR_input_bolt_60_right | 1 | steel | 0.000783 | Recessed M4 low-head envelope; 0.6 mm below crank face. Select screw length after confirming motor engagement.
FR_roll_bearing_right | 1 | steel | 0.08 | Geometry prototype; manufacturing qualification outstanding.
RL_hip_output_bolt_0 | 1 | steel | 0.001208 | Recessed M4 socket-head envelope; screw length and actuator thread engagement require supplier confirmation.
RL_hip_output_bolt_120 | 1 | steel | 0.001208 | Recessed M4 socket-head envelope; screw length and actuator thread engagement require supplier confirmation.
RL_hip_output_bolt_180 | 1 | steel | 0.001208 | Recessed M4 socket-head envelope; screw length and actuator thread engagement require supplier confirmation.
RL_hip_output_bolt_240 | 1 | steel | 0.001208 | Recessed M4 socket-head envelope; screw length and actuator thread engagement require supplier confirmation.
RL_hip_output_bolt_300 | 1 | steel | 0.001208 | Recessed M4 socket-head envelope; screw length and actuator thread engagement require supplier confirmation.
RL_hip_output_bolt_60 | 1 | steel | 0.001208 | Recessed M4 socket-head envelope; screw length and actuator thread engagement require supplier confirmation.
RL_input_bolt_0 | 1 | steel | 0.000783 | Recessed M4 low-head envelope; 0.6 mm below crank face. Select screw length after confirming motor engagement.
RL_input_bolt_120 | 1 | steel | 0.000783 | Recessed M4 low-head envelope; 0.6 mm below crank face. Select screw length after confirming motor engagement.
RL_input_bolt_180 | 1 | steel | 0.000783 | Recessed M4 low-head envelope; 0.6 mm below crank face. Select screw length after confirming motor engagement.
RL_input_bolt_240 | 1 | steel | 0.000783 | Recessed M4 low-head envelope; 0.6 mm below crank face. Select screw length after confirming motor engagement.
RL_input_bolt_300 | 1 | steel | 0.000783 | Recessed M4 low-head envelope; 0.6 mm below crank face. Select screw length after confirming motor engagement.
RL_input_bolt_60 | 1 | steel | 0.000783 | Recessed M4 low-head envelope; 0.6 mm below crank face. Select screw length after confirming motor engagement.
RL_roll_bearing | 1 | steel | 0.08 | Geometry prototype; manufacturing qualification outstanding.
RR_hip_output_bolt_0_right | 1 | steel | 0.001208 | Recessed M4 socket-head envelope; screw length and actuator thread engagement require supplier confirmation.
RR_hip_output_bolt_120_right | 1 | steel | 0.001208 | Recessed M4 socket-head envelope; screw length and actuator thread engagement require supplier confirmation.
RR_hip_output_bolt_180_right | 1 | steel | 0.001208 | Recessed M4 socket-head envelope; screw length and actuator thread engagement require supplier confirmation.
RR_hip_output_bolt_240_right | 1 | steel | 0.001208 | Recessed M4 socket-head envelope; screw length and actuator thread engagement require supplier confirmation.
RR_hip_output_bolt_300_right | 1 | steel | 0.001208 | Recessed M4 socket-head envelope; screw length and actuator thread engagement require supplier confirmation.
RR_hip_output_bolt_60_right | 1 | steel | 0.001208 | Recessed M4 socket-head envelope; screw length and actuator thread engagement require supplier confirmation.
RR_input_bolt_0_right | 1 | steel | 0.000783 | Recessed M4 low-head envelope; 0.6 mm below crank face. Select screw length after confirming motor engagement.
RR_input_bolt_120_right | 1 | steel | 0.000783 | Recessed M4 low-head envelope; 0.6 mm below crank face. Select screw length after confirming motor engagement.
RR_input_bolt_180_right | 1 | steel | 0.000783 | Recessed M4 low-head envelope; 0.6 mm below crank face. Select screw length after confirming motor engagement.
RR_input_bolt_240_right | 1 | steel | 0.000783 | Recessed M4 low-head envelope; 0.6 mm below crank face. Select screw length after confirming motor engagement.
RR_input_bolt_300_right | 1 | steel | 0.000783 | Recessed M4 low-head envelope; 0.6 mm below crank face. Select screw length after confirming motor engagement.
RR_input_bolt_60_right | 1 | steel | 0.000783 | Recessed M4 low-head envelope; 0.6 mm below crank face. Select screw length after confirming motor engagement.
RR_roll_bearing_right | 1 | steel | 0.08 | Geometry prototype; manufacturing qualification outstanding.
battery_-1 | 1 | envelope | 0.7 | Pack plus adapter envelope; exact commercial pack remains unselected.
battery_1 | 1 | envelope | 0.7 | Pack plus adapter envelope; exact commercial pack remains unselected.
battery_cassette | 1 | petg | 0.158718 | Rounded structural underside enclosure; pack adapters and contacts remain unselected.
battery_latch_-1 | 1 | petg | 0.000903 | Geometry prototype; manufacturing qualification outstanding.
battery_latch_1 | 1 | petg | 0.000903 | Geometry prototype; manufacturing qualification outstanding.
battery_rail_-90.5 | 1 | petg | 0.019309 | Geometry prototype; manufacturing qualification outstanding.
battery_rail_90.5 | 1 | petg | 0.019309 | Geometry prototype; manufacturing qualification outstanding.
battery_skid | 1 | aluminum | 0.105409 | Geometry prototype; manufacturing qualification outstanding.
bearing_67 | 2 | steel | 0.022 | Geometry prototype; manufacturing qualification outstanding.
bearing_67_right | 2 | steel | 0.022 | Geometry prototype; manufacturing qualification outstanding.
bearing_91 | 2 | steel | 0.022 | Geometry prototype; manufacturing qualification outstanding.
bearing_91_right | 2 | steel | 0.022 | Geometry prototype; manufacturing qualification outstanding.
belly_aft_0 | 1 | petg | 0.012399 | Geometry prototype; manufacturing qualification outstanding.
belly_center_0 | 1 | petg | 0.08035 | Geometry prototype; manufacturing qualification outstanding.
belly_front_0 | 1 | petg | 0.012399 | Geometry prototype; manufacturing qualification outstanding.
body_aft_0 | 1 | petg | 0.018388 | Geometry prototype; manufacturing qualification outstanding.
body_center_0 | 1 | petg | 0.166918 | Geometry prototype; manufacturing qualification outstanding.
body_front_0 | 1 | petg | 0.010378 | Geometry prototype; manufacturing qualification outstanding.
bolt_0 | 2 | steel | 0.005053 | Geometry prototype; manufacturing qualification outstanding.
bolt_0_right | 2 | steel | 0.005053 | Geometry prototype; manufacturing qualification outstanding.
bolt_1 | 2 | steel | 0.005053 | Geometry prototype; manufacturing qualification outstanding.
bolt_1_right | 2 | steel | 0.005053 | Geometry prototype; manufacturing qualification outstanding.
camera_-30 | 1 | envelope | 0.025 | Geometry prototype; manufacturing qualification outstanding.
camera_30 | 1 | envelope | 0.025 | Geometry prototype; manufacturing qualification outstanding.
chassis_beam_-102 | 1 | aluminum | 0.035595 | Geometry prototype; manufacturing qualification outstanding.
chassis_beam_102 | 1 | aluminum | 0.035595 | Geometry prototype; manufacturing qualification outstanding.
chassis_bolt_-1_-125.5_-12 | 1 | steel | 0.001939 | Geometry prototype; manufacturing qualification outstanding.
chassis_bolt_-1_-125.5_24 | 1 | steel | 0.001939 | Geometry prototype; manufacturing qualification outstanding.
chassis_bolt_-1_125.5_-12 | 1 | steel | 0.001939 | Geometry prototype; manufacturing qualification outstanding.
chassis_bolt_-1_125.5_24 | 1 | steel | 0.001939 | Geometry prototype; manufacturing qualification outstanding.
chassis_bolt_1_-125.5_-12 | 1 | steel | 0.001939 | Geometry prototype; manufacturing qualification outstanding.
chassis_bolt_1_-125.5_24 | 1 | steel | 0.001939 | Geometry prototype; manufacturing qualification outstanding.
chassis_bolt_1_125.5_-12 | 1 | steel | 0.001939 | Geometry prototype; manufacturing qualification outstanding.
chassis_bolt_1_125.5_24 | 1 | steel | 0.001939 | Geometry prototype; manufacturing qualification outstanding.
electronics_clearance | 1 | envelope | 0.0 | Reserved 130 x 135 x 32 mm computer volume; mass is in the electronics allowance. Exact computer and heat sink are unselected.
electronics_shelf | 1 | aluminum | 0.047498 | Geometry prototype; manufacturing qualification outstanding.
flexible_gaiter_lower_-1_-1 | 1 | fabric | 0.018 | Neutral flexible gaiter envelope; not a rigid shoulder. Deformation and attachment remain to be developed.
flexible_gaiter_lower_-1_1 | 1 | fabric | 0.018 | Neutral flexible gaiter envelope; not a rigid shoulder. Deformation and attachment remain to be developed.
flexible_gaiter_lower_1_-1 | 1 | fabric | 0.018 | Neutral flexible gaiter envelope; not a rigid shoulder. Deformation and attachment remain to be developed.
flexible_gaiter_lower_1_1 | 1 | fabric | 0.018 | Neutral flexible gaiter envelope; not a rigid shoulder. Deformation and attachment remain to be developed.
flexible_gaiter_upper_-1_-1 | 1 | fabric | 0.018 | Neutral flexible gaiter envelope; not a rigid shoulder. Deformation and attachment remain to be developed.
flexible_gaiter_upper_-1_1 | 1 | fabric | 0.018 | Neutral flexible gaiter envelope; not a rigid shoulder. Deformation and attachment remain to be developed.
flexible_gaiter_upper_1_-1 | 1 | fabric | 0.018 | Neutral flexible gaiter envelope; not a rigid shoulder. Deformation and attachment remain to be developed.
flexible_gaiter_upper_1_1 | 1 | fabric | 0.018 | Neutral flexible gaiter envelope; not a rigid shoulder. Deformation and attachment remain to be developed.
foot | 2 | rubber | 0.019769 | Geometry prototype; manufacturing qualification outstanding.
foot_right | 2 | rubber | 0.019769 | Geometry prototype; manufacturing qualification outstanding.
hip_disc | 2 | aluminum | 0.014913 | Geometry prototype; manufacturing qualification outstanding.
hip_disc_right | 2 | aluminum | 0.014913 | Geometry prototype; manufacturing qualification outstanding.
hip_hub | 2 | aluminum | 0.062676 | Geometry prototype; manufacturing qualification outstanding.
hip_hub_right | 2 | aluminum | 0.062676 | Geometry prototype; manufacturing qualification outstanding.
hip_index | 2 | petg | 1e-05 | Geometry prototype; manufacturing qualification outstanding.
hip_index_right | 2 | petg | 1e-05 | Geometry prototype; manufacturing qualification outstanding.
hip_motor | 2 | envelope | 0.405 | Geometry prototype; manufacturing qualification outstanding.
hip_motor_right | 2 | envelope | 0.405 | Geometry prototype; manufacturing qualification outstanding.
input_crank | 2 | aluminum | 0.011399 | Geometry prototype; manufacturing qualification outstanding.
input_crank_right | 2 | aluminum | 0.011399 | Geometry prototype; manufacturing qualification outstanding.
knee_axle | 2 | steel | 0.021702 | Fixed 12 x 8 mm tubular shaft ties the thigh cheeks; shin rotates on two bearings.
knee_axle_right | 2 | steel | 0.021702 | Fixed 12 x 8 mm tubular shaft ties the thigh cheeks; shin rotates on two bearings.
knee_bezel | 2 | petg | 0.001268 | Geometry prototype; manufacturing qualification outstanding.
knee_bezel_right | 2 | petg | 0.001268 | Geometry prototype; manufacturing qualification outstanding.
knee_drive_adapter | 2 | aluminum | 0.011979 | Geometry prototype; manufacturing qualification outstanding.
knee_drive_adapter_right | 2 | aluminum | 0.011979 | Geometry prototype; manufacturing qualification outstanding.
knee_end_cap | 2 | aluminum | 0.001409 | Geometry prototype; manufacturing qualification outstanding.
knee_end_cap_right | 2 | aluminum | 0.001409 | Geometry prototype; manufacturing qualification outstanding.
knee_inner_spacer | 2 | steel | 0.010811 | Geometry prototype; manufacturing qualification outstanding.
knee_inner_spacer_right | 2 | steel | 0.010811 | Geometry prototype; manufacturing qualification outstanding.
knee_motor | 2 | envelope | 0.405 | Geometry prototype; manufacturing qualification outstanding.
knee_motor_right | 2 | envelope | 0.405 | Geometry prototype; manufacturing qualification outstanding.
lens_-30 | 1 | envelope | 0.0 | Geometry prototype; manufacturing qualification outstanding.
lens_30 | 1 | envelope | 0.0 | Geometry prototype; manufacturing qualification outstanding.
lidar | 1 | envelope | 0.15 | Geometry prototype; manufacturing qualification outstanding.
lidar_base | 1 | envelope | 0.04 | Geometry prototype; manufacturing qualification outstanding.
lidar_lid | 1 | aluminum | 0.012367 | Geometry prototype; manufacturing qualification outstanding.
motor_carrier_-1 | 1 | aluminum | 0.139536 | Single machined elbow carrier includes the roll-output coupling, bearing journal and perpendicular hip-stator mounting flange.
motor_carrier_-1_right | 1 | aluminum | 0.139536 | Single machined elbow carrier includes the roll-output coupling, bearing journal and perpendicular hip-stator mounting flange.
motor_carrier_1 | 1 | aluminum | 0.139536 | Single machined elbow carrier includes the roll-output coupling, bearing journal and perpendicular hip-stator mounting flange.
motor_carrier_1_right | 1 | aluminum | 0.139536 | Single machined elbow carrier includes the roll-output coupling, bearing journal and perpendicular hip-stator mounting flange.
motor_mount_ring | 2 | aluminum | 0.034845 | Geometry prototype; manufacturing qualification outstanding.
motor_mount_ring_right | 2 | aluminum | 0.034845 | Geometry prototype; manufacturing qualification outstanding.
output_crank | 2 | aluminum | 0.018072 | Geometry prototype; manufacturing qualification outstanding.
output_crank_right | 2 | aluminum | 0.018072 | Geometry prototype; manufacturing qualification outstanding.
pod_sleeve_210 | 2 | aluminum | 0.001311 | Geometry prototype; manufacturing qualification outstanding.
pod_sleeve_210_right | 2 | aluminum | 0.001311 | Geometry prototype; manufacturing qualification outstanding.
pod_sleeve_330 | 2 | aluminum | 0.001311 | Geometry prototype; manufacturing qualification outstanding.
pod_sleeve_330_right | 2 | aluminum | 0.001311 | Geometry prototype; manufacturing qualification outstanding.
pod_sleeve_90 | 2 | aluminum | 0.001311 | Geometry prototype; manufacturing qualification outstanding.
pod_sleeve_90_right | 2 | aluminum | 0.001311 | Geometry prototype; manufacturing qualification outstanding.
pod_tie_210 | 2 | steel | 0.003798 | Geometry prototype; manufacturing qualification outstanding.
pod_tie_210_right | 2 | steel | 0.003798 | Geometry prototype; manufacturing qualification outstanding.
pod_tie_330 | 2 | steel | 0.003798 | Geometry prototype; manufacturing qualification outstanding.
pod_tie_330_right | 2 | steel | 0.003798 | Geometry prototype; manufacturing qualification outstanding.
pod_tie_90 | 2 | steel | 0.003798 | Geometry prototype; manufacturing qualification outstanding.
pod_tie_90_right | 2 | steel | 0.003798 | Geometry prototype; manufacturing qualification outstanding.
power_button | 1 | petg | 8.1e-05 | Geometry prototype; manufacturing qualification outstanding.
pushrod | 2 | steel | 0.053531 | Geometry prototype; manufacturing qualification outstanding.
pushrod_right | 2 | steel | 0.053531 | Geometry prototype; manufacturing qualification outstanding.
roll_cartridge_-1 | 1 | aluminum | 0.045979 | 50 x 66 x 8 RA5008-size crossed-roller bearing envelope; preload, retention and moment capacity require supplier review.
roll_cartridge_-1_right | 1 | aluminum | 0.045979 | 50 x 66 x 8 RA5008-size crossed-roller bearing envelope; preload, retention and moment capacity require supplier review.
roll_cartridge_1 | 1 | aluminum | 0.045979 | 50 x 66 x 8 RA5008-size crossed-roller bearing envelope; preload, retention and moment capacity require supplier review.
roll_cartridge_1_right | 1 | aluminum | 0.045979 | 50 x 66 x 8 RA5008-size crossed-roller bearing envelope; preload, retention and moment capacity require supplier review.
roll_motor_-1 | 1 | envelope | 0.405 | Geometry prototype; manufacturing qualification outstanding.
roll_motor_-1_right | 1 | envelope | 0.405 | Geometry prototype; manufacturing qualification outstanding.
roll_motor_1 | 1 | envelope | 0.405 | Geometry prototype; manufacturing qualification outstanding.
roll_motor_1_right | 1 | envelope | 0.405 | Geometry prototype; manufacturing qualification outstanding.
sensor_window | 1 | envelope | 0.09 | Geometry prototype; manufacturing qualification outstanding.
shin_carrier_67 | 2 | aluminum | 0.013032 | Geometry prototype; manufacturing qualification outstanding.
shin_carrier_67_right | 2 | aluminum | 0.013032 | Geometry prototype; manufacturing qualification outstanding.
shin_carrier_91 | 2 | aluminum | 0.00612 | Geometry prototype; manufacturing qualification outstanding.
shin_carrier_91_right | 2 | aluminum | 0.00612 | Geometry prototype; manufacturing qualification outstanding.
shin_inner | 2 | petg | 0.046734 | Geometry prototype; manufacturing qualification outstanding.
shin_inner_right | 2 | petg | 0.046734 | Geometry prototype; manufacturing qualification outstanding.
shin_outer | 2 | petg | 0.046734 | Geometry prototype; manufacturing qualification outstanding.
shin_outer_right | 2 | petg | 0.046734 | Geometry prototype; manufacturing qualification outstanding.
shoulder_cover_-1 | 1 | petg | 0.036831 | Motor cup rotates with the roll output carrier; no rigid shoulder bridges the joint.
shoulder_cover_-1_right | 1 | petg | 0.036831 | Motor cup rotates with the roll output carrier; no rigid shoulder bridges the joint.
shoulder_cover_1 | 1 | petg | 0.036831 | Motor cup rotates with the roll output carrier; no rigid shoulder bridges the joint.
shoulder_cover_1_right | 1 | petg | 0.036831 | Motor cup rotates with the roll output carrier; no rigid shoulder bridges the joint.
sleeve_0 | 2 | aluminum | 0.003597 | Geometry prototype; manufacturing qualification outstanding.
sleeve_0_right | 2 | aluminum | 0.003597 | Geometry prototype; manufacturing qualification outstanding.
sleeve_1 | 2 | aluminum | 0.003597 | Geometry prototype; manufacturing qualification outstanding.
sleeve_1_right | 2 | aluminum | 0.003597 | Geometry prototype; manufacturing qualification outstanding.
status_display | 1 | envelope | 0.03 | Geometry prototype; manufacturing qualification outstanding.
thigh_inner | 2 | petg | 0.131239 | One structural motor cradle and thigh cheek. Knee actuator is recessed 12 mm into the limb root; metal flange and compression sleeves spread mounting loads.
thigh_inner_right | 2 | petg | 0.131239 | One structural motor cradle and thigh cheek. Knee actuator is recessed 12 mm into the limb root; metal flange and compression sleeves spread mounting loads.
thigh_outer | 2 | petg | 0.065511 | Geometry prototype; manufacturing qualification outstanding.
thigh_outer_right | 2 | petg | 0.065511 | Geometry prototype; manufacturing qualification outstanding.
