pedapudi/oddstride/tinfox/proposals/sculpted/model/output/parts.csv

part | quantity | material | each_mass_kg | status
FL_hip_output_bolt_0 | 1 | steel | 0.001208 | Recessed M4 socket-head envelope; screw length and actuator thread engagement require supplier confirmation.
FL_hip_output_bolt_120 | 1 | steel | 0.001208 | Recessed M4 socket-head envelope; screw length and actuator thread engagement require supplier confirmation.
FL_hip_output_bolt_180 | 1 | steel | 0.001208 | Recessed M4 socket-head envelope; screw length and actuator thread engagement require supplier confirmation.
FL_hip_output_bolt_240 | 1 | steel | 0.001208 | Recessed M4 socket-head envelope; screw length and actuator thread engagement require supplier confirmation.
FL_hip_output_bolt_300 | 1 | steel | 0.001208 | Recessed M4 socket-head envelope; screw length and actuator thread engagement require supplier confirmation.
FL_hip_output_bolt_60 | 1 | steel | 0.001208 | Recessed M4 socket-head envelope; screw length and actuator thread engagement require supplier confirmation.
FL_input_bolt_0 | 1 | steel | 0.000783 | Low-head M4 envelope; length and actuator engagement require vendor confirmation.
FL_input_bolt_120 | 1 | steel | 0.000783 | Low-head M4 envelope; length and actuator engagement require vendor confirmation.
FL_input_bolt_180 | 1 | steel | 0.000783 | Low-head M4 envelope; length and actuator engagement require vendor confirmation.
FL_input_bolt_240 | 1 | steel | 0.000783 | Low-head M4 envelope; length and actuator engagement require vendor confirmation.
FL_input_bolt_300 | 1 | steel | 0.000783 | Low-head M4 envelope; length and actuator engagement require vendor confirmation.
FL_input_bolt_60 | 1 | steel | 0.000783 | Low-head M4 envelope; length and actuator engagement require vendor confirmation.
FL_roll_bearing | 1 | steel | 0.08 | Geometry prototype; manufacturing qualification outstanding.
FR_hip_output_bolt_0_right | 1 | steel | 0.001208 | Recessed M4 socket-head envelope; screw length and actuator thread engagement require supplier confirmation.
FR_hip_output_bolt_120_right | 1 | steel | 0.001208 | Recessed M4 socket-head envelope; screw length and actuator thread engagement require supplier confirmation.
FR_hip_output_bolt_180_right | 1 | steel | 0.001208 | Recessed M4 socket-head envelope; screw length and actuator thread engagement require supplier confirmation.
FR_hip_output_bolt_240_right | 1 | steel | 0.001208 | Recessed M4 socket-head envelope; screw length and actuator thread engagement require supplier confirmation.
FR_hip_output_bolt_300_right | 1 | steel | 0.001208 | Recessed M4 socket-head envelope; screw length and actuator thread engagement require supplier confirmation.
FR_hip_output_bolt_60_right | 1 | steel | 0.001208 | Recessed M4 socket-head envelope; screw length and actuator thread engagement require supplier confirmation.
FR_input_bolt_0_right | 1 | steel | 0.000783 | Low-head M4 envelope; length and actuator engagement require vendor confirmation.
FR_input_bolt_120_right | 1 | steel | 0.000783 | Low-head M4 envelope; length and actuator engagement require vendor confirmation.
FR_input_bolt_180_right | 1 | steel | 0.000783 | Low-head M4 envelope; length and actuator engagement require vendor confirmation.
FR_input_bolt_240_right | 1 | steel | 0.000783 | Low-head M4 envelope; length and actuator engagement require vendor confirmation.
FR_input_bolt_300_right | 1 | steel | 0.000783 | Low-head M4 envelope; length and actuator engagement require vendor confirmation.
FR_input_bolt_60_right | 1 | steel | 0.000783 | Low-head M4 envelope; length and actuator engagement require vendor confirmation.
FR_roll_bearing_right | 1 | steel | 0.08 | Geometry prototype; manufacturing qualification outstanding.
RL_hip_output_bolt_0 | 1 | steel | 0.001208 | Recessed M4 socket-head envelope; screw length and actuator thread engagement require supplier confirmation.
RL_hip_output_bolt_120 | 1 | steel | 0.001208 | Recessed M4 socket-head envelope; screw length and actuator thread engagement require supplier confirmation.
RL_hip_output_bolt_180 | 1 | steel | 0.001208 | Recessed M4 socket-head envelope; screw length and actuator thread engagement require supplier confirmation.
RL_hip_output_bolt_240 | 1 | steel | 0.001208 | Recessed M4 socket-head envelope; screw length and actuator thread engagement require supplier confirmation.
RL_hip_output_bolt_300 | 1 | steel | 0.001208 | Recessed M4 socket-head envelope; screw length and actuator thread engagement require supplier confirmation.
RL_hip_output_bolt_60 | 1 | steel | 0.001208 | Recessed M4 socket-head envelope; screw length and actuator thread engagement require supplier confirmation.
RL_input_bolt_0 | 1 | steel | 0.000783 | Low-head M4 envelope; length and actuator engagement require vendor confirmation.
RL_input_bolt_120 | 1 | steel | 0.000783 | Low-head M4 envelope; length and actuator engagement require vendor confirmation.
RL_input_bolt_180 | 1 | steel | 0.000783 | Low-head M4 envelope; length and actuator engagement require vendor confirmation.
RL_input_bolt_240 | 1 | steel | 0.000783 | Low-head M4 envelope; length and actuator engagement require vendor confirmation.
RL_input_bolt_300 | 1 | steel | 0.000783 | Low-head M4 envelope; length and actuator engagement require vendor confirmation.
RL_input_bolt_60 | 1 | steel | 0.000783 | Low-head M4 envelope; length and actuator engagement require vendor confirmation.
RL_roll_bearing | 1 | steel | 0.08 | Geometry prototype; manufacturing qualification outstanding.
RR_hip_output_bolt_0_right | 1 | steel | 0.001208 | Recessed M4 socket-head envelope; screw length and actuator thread engagement require supplier confirmation.
RR_hip_output_bolt_120_right | 1 | steel | 0.001208 | Recessed M4 socket-head envelope; screw length and actuator thread engagement require supplier confirmation.
RR_hip_output_bolt_180_right | 1 | steel | 0.001208 | Recessed M4 socket-head envelope; screw length and actuator thread engagement require supplier confirmation.
RR_hip_output_bolt_240_right | 1 | steel | 0.001208 | Recessed M4 socket-head envelope; screw length and actuator thread engagement require supplier confirmation.
RR_hip_output_bolt_300_right | 1 | steel | 0.001208 | Recessed M4 socket-head envelope; screw length and actuator thread engagement require supplier confirmation.
RR_hip_output_bolt_60_right | 1 | steel | 0.001208 | Recessed M4 socket-head envelope; screw length and actuator thread engagement require supplier confirmation.
RR_input_bolt_0_right | 1 | steel | 0.000783 | Low-head M4 envelope; length and actuator engagement require vendor confirmation.
RR_input_bolt_120_right | 1 | steel | 0.000783 | Low-head M4 envelope; length and actuator engagement require vendor confirmation.
RR_input_bolt_180_right | 1 | steel | 0.000783 | Low-head M4 envelope; length and actuator engagement require vendor confirmation.
RR_input_bolt_240_right | 1 | steel | 0.000783 | Low-head M4 envelope; length and actuator engagement require vendor confirmation.
RR_input_bolt_300_right | 1 | steel | 0.000783 | Low-head M4 envelope; length and actuator engagement require vendor confirmation.
RR_input_bolt_60_right | 1 | steel | 0.000783 | Low-head M4 envelope; length and actuator engagement require vendor confirmation.
RR_roll_bearing_right | 1 | steel | 0.08 | Geometry prototype; manufacturing qualification outstanding.
axle_bolt | 2 | steel | 0.028992 | M8 x 60 button-head screw envelope, 14 mm head diameter and 4.4 mm height. Head recessed flush to the inner thigh; flange nut is outboard. Withdraw after removing the nut.
axle_bolt_right | 2 | steel | 0.028992 | M8 x 60 button-head screw envelope, 14 mm head diameter and 4.4 mm height. Head recessed flush to the inner thigh; flange nut is outboard. Withdraw after removing the nut.
axle_nut | 2 | steel | 0.007357 | M8 flange-nut envelope. Socket access and final preload require verification; no loose external axle spacer.
axle_nut_right | 2 | steel | 0.007357 | M8 flange-nut envelope. Socket access and final preload require verification; no loose external axle spacer.
battery_-1 | 1 | envelope | 0.7 | Pack plus adapter envelope; exact commercial pack remains unselected.
battery_1 | 1 | envelope | 0.7 | Pack plus adapter envelope; exact commercial pack remains unselected.
battery_access_latch_-1 | 1 | petg | 0.000194 | Geometry prototype; manufacturing qualification outstanding.
battery_access_latch_1 | 1 | petg | 0.000194 | Geometry prototype; manufacturing qualification outstanding.
battery_access_screw_-1_-50 | 1 | steel | 0.000539 | Geometry prototype; manufacturing qualification outstanding.
battery_access_screw_-1_50 | 1 | steel | 0.000539 | Geometry prototype; manufacturing qualification outstanding.
battery_access_screw_1_-50 | 1 | steel | 0.000539 | Geometry prototype; manufacturing qualification outstanding.
battery_access_screw_1_50 | 1 | steel | 0.000539 | Geometry prototype; manufacturing qualification outstanding.
battery_cassette | 1 | petg | 0.216332 | One-piece underside cassette with integral pack guides and four captive-nut pockets. Four side-access M3 screws attach the cassette independently to the frame. Pack adapters and contacts remain unselected.
battery_latch_-1 | 1 | petg | 0.000903 | Geometry prototype; manufacturing qualification outstanding.
battery_latch_1 | 1 | petg | 0.000903 | Geometry prototype; manufacturing qualification outstanding.
battery_side_panel_-1 | 1 | petg | 0.015441 | Compact lower trim panel stays within the cassette withdrawal envelope. Two M3 clearance holes align with integral cassette pilot bosses; screw specification remains provisional.
battery_side_panel_1 | 1 | petg | 0.015441 | Compact lower trim panel stays within the cassette withdrawal envelope. Two M3 clearance holes align with integral cassette pilot bosses; screw specification remains provisional.
battery_skid | 1 | aluminum | 0.105409 | Geometry prototype; manufacturing qualification outstanding.
bearing_inner | 2 | steel | 0.022 | Geometry prototype; manufacturing qualification outstanding.
bearing_inner_right | 2 | steel | 0.022 | Geometry prototype; manufacturing qualification outstanding.
bearing_outer | 2 | steel | 0.022 | Geometry prototype; manufacturing qualification outstanding.
bearing_outer_right | 2 | steel | 0.022 | Geometry prototype; manufacturing qualification outstanding.
belly_center_0 | 1 | petg | 0.13361 | Separate lower protective shell around the removable battery opening; does not carry actuator loads.
body_aft_0 | 1 | petg | 0.06258 | Combined rear upper/lower shell, 2.8 mm nominal skin with a deep central return rib. Motor loads bypass this protective module.
body_center_0 | 1 | petg | 0.275445 | One 2.8 mm top-and-side clamshell. Four lateral screws attach to chassis bosses. Lift straight upward after removing screws; print roof-down, interior open upward.
body_nose_surround | 1 | petg | 0.055857 | Combined front upper/lower cap and nose wrap with a deep central return rib and four fascia posts. Two M3-sized body holes and four fascia holes provide assembly access; final inserts, screws and load qualification remain unselected.
body_serial | 1 | envelope | 0.001 | Geometry prototype; manufacturing qualification outstanding.
body_service_screw_-1_-112_22 | 1 | steel | 0.000102 | Upper M3 cover fastener; panel is located by two integral tabs. Pilot-boss screw specification remains provisional.
body_service_screw_-1_112_22 | 1 | steel | 0.000102 | Upper M3 cover fastener; panel is located by two integral tabs. Pilot-boss screw specification remains provisional.
body_service_screw_1_-112_22 | 1 | steel | 0.000102 | Upper M3 cover fastener; panel is located by two integral tabs. Pilot-boss screw specification remains provisional.
body_service_screw_1_112_22 | 1 | steel | 0.000102 | Upper M3 cover fastener; panel is located by two integral tabs. Pilot-boss screw specification remains provisional.
body_status_dot | 1 | envelope | 0.001 | Geometry prototype; manufacturing qualification outstanding.
body_wordmark | 1 | envelope | 0.002 | Geometry prototype; manufacturing qualification outstanding.
bolt_0 | 2 | steel | 0.005447 | Geometry prototype; manufacturing qualification outstanding.
bolt_0_right | 2 | steel | 0.005447 | Geometry prototype; manufacturing qualification outstanding.
bolt_1 | 2 | steel | 0.005447 | Geometry prototype; manufacturing qualification outstanding.
bolt_1_right | 2 | steel | 0.005447 | Geometry prototype; manufacturing qualification outstanding.
camera_-52 | 1 | envelope | 0.025 | Geometry prototype; manufacturing qualification outstanding.
camera_52 | 1 | envelope | 0.025 | Geometry prototype; manufacturing qualification outstanding.
cassette_nut_-1_-52 | 1 | steel | 0.000401 | M3 DIN 934 nut envelope, 5.5 mm flats and 2.4 mm thickness; retained in an integral top-loading pocket.
cassette_nut_-1_52 | 1 | steel | 0.000401 | M3 DIN 934 nut envelope, 5.5 mm flats and 2.4 mm thickness; retained in an integral top-loading pocket.
cassette_nut_1_-52 | 1 | steel | 0.000401 | M3 DIN 934 nut envelope, 5.5 mm flats and 2.4 mm thickness; retained in an integral top-loading pocket.
cassette_nut_1_52 | 1 | steel | 0.000401 | M3 DIN 934 nut envelope, 5.5 mm flats and 2.4 mm thickness; retained in an integral top-loading pocket.
cassette_screw_-1_-52 | 1 | steel | 0.001225 | Independent M3 x 12 cassette-to-frame screw. Does not retain the electronics deck.
cassette_screw_-1_52 | 1 | steel | 0.001225 | Independent M3 x 12 cassette-to-frame screw. Does not retain the electronics deck.
cassette_screw_1_-52 | 1 | steel | 0.001225 | Independent M3 x 12 cassette-to-frame screw. Does not retain the electronics deck.
cassette_screw_1_52 | 1 | steel | 0.001225 | Independent M3 x 12 cassette-to-frame screw. Does not retain the electronics deck.
chassis_beam_-102 | 1 | aluminum | 0.047251 | Metal C-section motor rail with thickened cartridge pads and lid mounting bosses. Printed versions are unloaded fit mockups; frame strength requires analysis and testing.
chassis_beam_102 | 1 | aluminum | 0.047251 | Metal C-section motor rail with thickened cartridge pads and lid mounting bosses. Printed versions are unloaded fit mockups; frame strength requires analysis and testing.
chassis_bolt_-1_-125.5_-12 | 1 | steel | 0.001225 | M3 x 12 nominal cartridge screw through the thickened rail pad; confirm engagement in cartridge ear.
chassis_bolt_-1_-125.5_24 | 1 | steel | 0.001225 | M3 x 12 nominal cartridge screw through the thickened rail pad; confirm engagement in cartridge ear.
chassis_bolt_-1_125.5_-12 | 1 | steel | 0.001225 | M3 x 12 nominal cartridge screw through the thickened rail pad; confirm engagement in cartridge ear.
chassis_bolt_-1_125.5_24 | 1 | steel | 0.001225 | M3 x 12 nominal cartridge screw through the thickened rail pad; confirm engagement in cartridge ear.
chassis_bolt_1_-125.5_-12 | 1 | steel | 0.001225 | M3 x 12 nominal cartridge screw through the thickened rail pad; confirm engagement in cartridge ear.
chassis_bolt_1_-125.5_24 | 1 | steel | 0.001225 | M3 x 12 nominal cartridge screw through the thickened rail pad; confirm engagement in cartridge ear.
chassis_bolt_1_125.5_-12 | 1 | steel | 0.001225 | M3 x 12 nominal cartridge screw through the thickened rail pad; confirm engagement in cartridge ear.
chassis_bolt_1_125.5_24 | 1 | steel | 0.001225 | M3 x 12 nominal cartridge screw through the thickened rail pad; confirm engagement in cartridge ear.
chassis_brace_screw_-1_-63 | 1 | steel | 0.000892 | M3 x 6 socket screw into integral metal rail ledge; verify tapped engagement. Retained during electronics or battery service.
chassis_brace_screw_-1_63 | 1 | steel | 0.000892 | M3 x 6 socket screw into integral metal rail ledge; verify tapped engagement. Retained during electronics or battery service.
chassis_brace_screw_1_-63 | 1 | steel | 0.000892 | M3 x 6 socket screw into integral metal rail ledge; verify tapped engagement. Retained during electronics or battery service.
chassis_brace_screw_1_63 | 1 | steel | 0.000892 | M3 x 6 socket screw into integral metal rail ledge; verify tapped engagement. Retained during electronics or battery service.
chassis_crossmember_-121 | 1 | aluminum | 0.012686 | Removable top transverse tie. Two screws per rail resist joint rotation; caps mount independently; the computer tray lifts between the two end crossmembers.
chassis_crossmember_121 | 1 | aluminum | 0.012686 | Removable top transverse tie. Two screws per rail resist joint rotation; caps mount independently; the computer tray lifts between the two end crossmembers.
chassis_lower_brace | 1 | aluminum | 0.081635 | Flat 3 mm aluminum frame diaphragm with four rail attachments and four tapped deck mounts. Carries the lower rail connection independently of the deck. Plastic copy is an unloaded fit mockup; frame stiffness and joints require qualification.
chassis_tie_bolt_-121_-1_-3 | 1 | steel | 0.000532 | M3 x 8 nominal countersunk metal-frame tie screw; nut below the rail flange.
chassis_tie_bolt_-121_-1_3 | 1 | steel | 0.000532 | M3 x 8 nominal countersunk metal-frame tie screw; nut below the rail flange.
chassis_tie_bolt_-121_1_-3 | 1 | steel | 0.000532 | M3 x 8 nominal countersunk metal-frame tie screw; nut below the rail flange.
chassis_tie_bolt_-121_1_3 | 1 | steel | 0.000532 | M3 x 8 nominal countersunk metal-frame tie screw; nut below the rail flange.
chassis_tie_bolt_121_-1_-3 | 1 | steel | 0.000532 | M3 x 8 nominal countersunk metal-frame tie screw; nut below the rail flange.
chassis_tie_bolt_121_-1_3 | 1 | steel | 0.000532 | M3 x 8 nominal countersunk metal-frame tie screw; nut below the rail flange.
chassis_tie_bolt_121_1_-3 | 1 | steel | 0.000532 | M3 x 8 nominal countersunk metal-frame tie screw; nut below the rail flange.
chassis_tie_bolt_121_1_3 | 1 | steel | 0.000532 | M3 x 8 nominal countersunk metal-frame tie screw; nut below the rail flange.
chassis_tie_nut_-121_-1_-3 | 1 | steel | 0.00036 | Geometry prototype; manufacturing qualification outstanding.
chassis_tie_nut_-121_-1_3 | 1 | steel | 0.00036 | Geometry prototype; manufacturing qualification outstanding.
chassis_tie_nut_-121_1_-3 | 1 | steel | 0.00036 | Geometry prototype; manufacturing qualification outstanding.
chassis_tie_nut_-121_1_3 | 1 | steel | 0.00036 | Geometry prototype; manufacturing qualification outstanding.
chassis_tie_nut_121_-1_-3 | 1 | steel | 0.00036 | Geometry prototype; manufacturing qualification outstanding.
chassis_tie_nut_121_-1_3 | 1 | steel | 0.00036 | Geometry prototype; manufacturing qualification outstanding.
chassis_tie_nut_121_1_-3 | 1 | steel | 0.00036 | Geometry prototype; manufacturing qualification outstanding.
chassis_tie_nut_121_1_3 | 1 | steel | 0.00036 | Geometry prototype; manufacturing qualification outstanding.
depth_sensor | 1 | envelope | 0.0 | Geometry prototype; manufacturing qualification outstanding.
electronics_clearance | 1 | envelope | 0.0 | Reserved 130 x 135 x 32 mm computer volume, 2 mm above the deck. Exact computer, standoffs, connectors and thermal airflow remain unselected.
electronics_shelf | 1 | petg | 0.088426 | Flat 134 x 186 x 4 mm PETG electronics deck. Six rounded openings, four top-access M3 holes and four adapter slots. Print broad face down without designed supports. Computer standoffs and wiring remain component-specific; the fixed metal brace carries frame loads.
end_cap_nut_-1_-18 | 1 | steel | 0.00036 | Geometry prototype; manufacturing qualification outstanding.
end_cap_nut_-1_18 | 1 | steel | 0.00036 | Geometry prototype; manufacturing qualification outstanding.
end_cap_nut_1_-18 | 1 | steel | 0.00036 | Geometry prototype; manufacturing qualification outstanding.
end_cap_nut_1_18 | 1 | steel | 0.00036 | Geometry prototype; manufacturing qualification outstanding.
end_cap_screw_-1_-18 | 1 | steel | 0.000532 | M3 x 8 countersunk screw joins end-cap lap to chassis crossmember independently of the removable lid.
end_cap_screw_-1_18 | 1 | steel | 0.000532 | M3 x 8 countersunk screw joins end-cap lap to chassis crossmember independently of the removable lid.
end_cap_screw_1_-18 | 1 | steel | 0.000532 | M3 x 8 countersunk screw joins end-cap lap to chassis crossmember independently of the removable lid.
end_cap_screw_1_18 | 1 | steel | 0.000532 | M3 x 8 countersunk screw joins end-cap lap to chassis crossmember independently of the removable lid.
foot | 2 | rubber | 0.042142 | Rounded boot envelope with a shin-aligned neck. Attachment cavity and retaining fastener remain to be detailed.
foot_right | 2 | rubber | 0.042142 | Rounded boot envelope with a shin-aligned neck. Attachment cavity and retaining fastener remain to be detailed.
front_fascia | 1 | petg | 0.034584 | Removable compound-curved face with an 8 mm horizontal crown and independent 10 mm vertical crown and a curved recessed sensor bezel. The rim preserves the body service gap.
front_fascia_screw_-89_-27 | 1 | steel | 4.5e-05 | Geometry prototype; manufacturing qualification outstanding.
front_fascia_screw_-89_27 | 1 | steel | 4.5e-05 | Geometry prototype; manufacturing qualification outstanding.
front_fascia_screw_89_-27 | 1 | steel | 4.5e-05 | Geometry prototype; manufacturing qualification outstanding.
front_fascia_screw_89_27 | 1 | steel | 4.5e-05 | Geometry prototype; manufacturing qualification outstanding.
hip_hub | 2 | aluminum | 0.062676 | Geometry prototype; manufacturing qualification outstanding.
hip_hub_right | 2 | aluminum | 0.062676 | Geometry prototype; manufacturing qualification outstanding.
hip_motor | 2 | envelope | 0.405 | Geometry prototype; manufacturing qualification outstanding.
hip_motor_right | 2 | envelope | 0.405 | Geometry prototype; manufacturing qualification outstanding.
input_crank | 2 | aluminum | 0.041379 | One machined output coupling and double-shear crank. Six motor-interface holes retain the vendor pattern; final screw length depends on actuator thread depth.
input_crank_right | 2 | aluminum | 0.041379 | One machined output coupling and double-shear crank. Six motor-interface holes retain the vendor pattern; final screw length depends on actuator thread depth.
input_pin | 2 | steel | 0.008294 | Nominal 6 x 20 mm shoulder with M5 x 6 thread; alloy-steel grade and fatigue qualification required.
input_pin_right | 2 | steel | 0.008294 | Nominal 6 x 20 mm shoulder with M5 x 6 thread; alloy-steel grade and fatigue qualification required.
iris_-52 | 1 | envelope | 0.0 | Geometry prototype; manufacturing qualification outstanding.
iris_52 | 1 | envelope | 0.0 | Geometry prototype; manufacturing qualification outstanding.
knee_axle | 2 | steel | 0.020421 | Removable 12 OD x 8.4 ID x 45.1 mm precision sleeve; M8 through-bolt retains it between the thigh cheeks. Bearing fit and clamp stack require physical verification.
knee_axle_right | 2 | steel | 0.020421 | Removable 12 OD x 8.4 ID x 45.1 mm precision sleeve; M8 through-bolt retains it between the thigh cheeks. Bearing fit and clamp stack require physical verification.
knee_inner_spacer | 2 | steel | 0.006943 | Geometry prototype; manufacturing qualification outstanding.
knee_inner_spacer_right | 2 | steel | 0.006943 | Geometry prototype; manufacturing qualification outstanding.
knee_motor | 2 | envelope | 0.405 | Geometry prototype; manufacturing qualification outstanding.
knee_motor_right | 2 | envelope | 0.405 | Geometry prototype; manufacturing qualification outstanding.
lens_-52 | 1 | envelope | 0.0 | Geometry prototype; manufacturing qualification outstanding.
lens_52 | 1 | envelope | 0.0 | Geometry prototype; manufacturing qualification outstanding.
lens_ring_-52 | 1 | envelope | 0.0 | Geometry prototype; manufacturing qualification outstanding.
lens_ring_52 | 1 | envelope | 0.0 | Geometry prototype; manufacturing qualification outstanding.
lidar | 1 | envelope | 0.15 | Geometry prototype; manufacturing qualification outstanding.
lidar_base | 1 | envelope | 0.04 | Geometry prototype; manufacturing qualification outstanding.
lidar_lid | 1 | aluminum | 0.012367 | Geometry prototype; manufacturing qualification outstanding.
motor_carrier_-1 | 1 | aluminum | 0.218108 | Single machined elbow carrier includes the roll-output coupling, bearing journal and perpendicular hip-stator mounting flange.
motor_carrier_-1_right | 1 | aluminum | 0.218108 | Single machined elbow carrier includes the roll-output coupling, bearing journal and perpendicular hip-stator mounting flange.
motor_carrier_1 | 1 | aluminum | 0.218108 | Single machined elbow carrier includes the roll-output coupling, bearing journal and perpendicular hip-stator mounting flange.
motor_carrier_1_right | 1 | aluminum | 0.218108 | Single machined elbow carrier includes the roll-output coupling, bearing journal and perpendicular hip-stator mounting flange.
motor_mount_ring | 2 | aluminum | 0.034845 | Geometry prototype; manufacturing qualification outstanding.
motor_mount_ring_right | 2 | aluminum | 0.034845 | Geometry prototype; manufacturing qualification outstanding.
output_pin | 2 | steel | 0.008294 | Double-shear shoulder pin; M5 threaded end retained by the captive nut in the structural shin.
output_pin_right | 2 | steel | 0.008294 | Double-shear shoulder pin; M5 threaded end retained by the captive nut in the structural shin.
output_pivot_nut | 2 | steel | 0.001124 | M5 nut seated in the integral inner-shin fork; secure in its pocket during assembly.
output_pivot_nut_right | 2 | steel | 0.001124 | M5 nut seated in the integral inner-shin fork; secure in its pocket during assembly.
pod_sleeve_210 | 2 | aluminum | 0.001311 | Geometry prototype; manufacturing qualification outstanding.
pod_sleeve_210_right | 2 | aluminum | 0.001311 | Geometry prototype; manufacturing qualification outstanding.
pod_sleeve_330 | 2 | aluminum | 0.001311 | Geometry prototype; manufacturing qualification outstanding.
pod_sleeve_330_right | 2 | aluminum | 0.001311 | Geometry prototype; manufacturing qualification outstanding.
pod_sleeve_90 | 2 | aluminum | 0.001311 | Geometry prototype; manufacturing qualification outstanding.
pod_sleeve_90_right | 2 | aluminum | 0.001311 | Geometry prototype; manufacturing qualification outstanding.
pod_tie_210 | 2 | steel | 0.003798 | Geometry prototype; manufacturing qualification outstanding.
pod_tie_210_right | 2 | steel | 0.003798 | Geometry prototype; manufacturing qualification outstanding.
pod_tie_330 | 2 | steel | 0.003798 | Geometry prototype; manufacturing qualification outstanding.
pod_tie_330_right | 2 | steel | 0.003798 | Geometry prototype; manufacturing qualification outstanding.
pod_tie_90 | 2 | steel | 0.003798 | Geometry prototype; manufacturing qualification outstanding.
pod_tie_90_right | 2 | steel | 0.003798 | Geometry prototype; manufacturing qualification outstanding.
power_button | 1 | petg | 8.1e-05 | Geometry prototype; manufacturing qualification outstanding.
pushrod | 2 | steel | 0.056717 | Steel 170 mm center-distance link with finished 8 mm bushing bores and enlarged 15 mm eyes.
pushrod_right | 2 | steel | 0.056717 | Steel 170 mm center-distance link with finished 8 mm bushing bores and enlarged 15 mm eyes.
rod_bush_input_0 | 2 | envelope | 0.000202 | GFM-0608-04 dimensional envelope; paired flanges provide replaceable thrust faces. Wear life requires validation.
rod_bush_input_0_right | 2 | envelope | 0.000202 | GFM-0608-04 dimensional envelope; paired flanges provide replaceable thrust faces. Wear life requires validation.
rod_bush_input_1 | 2 | envelope | 0.000202 | GFM-0608-04 dimensional envelope; paired flanges provide replaceable thrust faces. Wear life requires validation.
rod_bush_input_1_right | 2 | envelope | 0.000202 | GFM-0608-04 dimensional envelope; paired flanges provide replaceable thrust faces. Wear life requires validation.
rod_bush_output_0 | 2 | envelope | 0.000202 | GFM-0608-04 dimensional envelope; paired flanges provide replaceable thrust faces. Wear life requires validation.
rod_bush_output_0_right | 2 | envelope | 0.000202 | GFM-0608-04 dimensional envelope; paired flanges provide replaceable thrust faces. Wear life requires validation.
rod_bush_output_1 | 2 | envelope | 0.000202 | GFM-0608-04 dimensional envelope; paired flanges provide replaceable thrust faces. Wear life requires validation.
rod_bush_output_1_right | 2 | envelope | 0.000202 | GFM-0608-04 dimensional envelope; paired flanges provide replaceable thrust faces. Wear life requires validation.
roll_cartridge_-1 | 1 | aluminum | 0.045914 | 50 x 66 x 8 RA5008-size crossed-roller bearing envelope; preload, retention and moment capacity require supplier review.
roll_cartridge_-1_right | 1 | aluminum | 0.045914 | 50 x 66 x 8 RA5008-size crossed-roller bearing envelope; preload, retention and moment capacity require supplier review.
roll_cartridge_1 | 1 | aluminum | 0.045914 | 50 x 66 x 8 RA5008-size crossed-roller bearing envelope; preload, retention and moment capacity require supplier review.
roll_cartridge_1_right | 1 | aluminum | 0.045914 | 50 x 66 x 8 RA5008-size crossed-roller bearing envelope; preload, retention and moment capacity require supplier review.
roll_motor_-1 | 1 | envelope | 0.405 | Geometry prototype; manufacturing qualification outstanding.
roll_motor_-1_right | 1 | envelope | 0.405 | Geometry prototype; manufacturing qualification outstanding.
roll_motor_1 | 1 | envelope | 0.405 | Geometry prototype; manufacturing qualification outstanding.
roll_motor_1_right | 1 | envelope | 0.405 | Geometry prototype; manufacturing qualification outstanding.
sensor_bezel | 1 | petg | 0.01625 | Geometry prototype; manufacturing qualification outstanding.
sensor_window | 1 | envelope | 0.09 | Provisional dark sensor backing with lens apertures; selected protective glazing and seals remain unmodeled.
shin_clamp_bolt_105 | 2 | steel | 0.003181 | M4 x 20 socket screw; accessible from the front of the shin, with no loose washer.
shin_clamp_bolt_105_right | 2 | steel | 0.003181 | M4 x 20 socket screw; accessible from the front of the shin, with no loose washer.
shin_clamp_bolt_37 | 2 | steel | 0.003181 | M4 x 20 socket screw; accessible from the front of the shin, with no loose washer.
shin_clamp_bolt_37_right | 2 | steel | 0.003181 | M4 x 20 socket screw; accessible from the front of the shin, with no loose washer.
shin_clamp_nut_105 | 2 | steel | 0.00075 | M4 hex nut captured behind the compression sleeve in the rear half; no loose nut needed during routine service.
shin_clamp_nut_105_right | 2 | steel | 0.00075 | M4 hex nut captured behind the compression sleeve in the rear half; no loose nut needed during routine service.
shin_clamp_nut_37 | 2 | steel | 0.00075 | M4 hex nut captured behind the compression sleeve in the rear half; no loose nut needed during routine service.
shin_clamp_nut_37_right | 2 | steel | 0.00075 | M4 hex nut captured behind the compression sleeve in the rear half; no loose nut needed during routine service.
shin_clamp_sleeve_105 | 2 | aluminum | 0.001544 | Captive 8 OD x 4.3 ID x 16 mm compression sleeve; mating lands establish closure without crushing the bearing seats.
shin_clamp_sleeve_105_right | 2 | aluminum | 0.001544 | Captive 8 OD x 4.3 ID x 16 mm compression sleeve; mating lands establish closure without crushing the bearing seats.
shin_clamp_sleeve_37 | 2 | aluminum | 0.001544 | Captive 8 OD x 4.3 ID x 16 mm compression sleeve; mating lands establish closure without crushing the bearing seats.
shin_clamp_sleeve_37_right | 2 | aluminum | 0.001544 | Captive 8 OD x 4.3 ID x 16 mm compression sleeve; mating lands establish closure without crushing the bearing seats.
shin_inner | 2 | petg | 0.049053 | One of two fore/aft structural shin halves with integral split bearing seats and pushrod rocker. Opening the X=0 split releases both bearings radially. Two M4 clamps and hard mating lands control closure; bearing fit and printed strength remain unqualified.
shin_inner_right | 2 | petg | 0.049053 | One of two fore/aft structural shin halves with integral split bearing seats and pushrod rocker. Opening the X=0 split releases both bearings radially. Two M4 clamps and hard mating lands control closure; bearing fit and printed strength remain unqualified.
shin_outer | 2 | petg | 0.056809 | One of two fore/aft structural shin halves with integral split bearing seats and pushrod rocker. Opening the X=0 split releases both bearings radially. Two M4 clamps and hard mating lands control closure; bearing fit and printed strength remain unqualified.
shin_outer_right | 2 | petg | 0.056809 | One of two fore/aft structural shin halves with integral split bearing seats and pushrod rocker. Opening the X=0 split releases both bearings radially. Two M4 clamps and hard mating lands control closure; bearing fit and printed strength remain unqualified.
sleeve_0 | 2 | aluminum | 0.003976 | Geometry prototype; manufacturing qualification outstanding.
sleeve_0_right | 2 | aluminum | 0.003976 | Geometry prototype; manufacturing qualification outstanding.
sleeve_1 | 2 | aluminum | 0.003976 | Geometry prototype; manufacturing qualification outstanding.
sleeve_1_right | 2 | aluminum | 0.003976 | Geometry prototype; manufacturing qualification outstanding.
status_display | 1 | envelope | 0.03 | Geometry prototype; manufacturing qualification outstanding.
status_display_dial | 1 | envelope | 0.001 | Geometry prototype; manufacturing qualification outstanding.
thigh_inner | 2 | petg | 0.118985 | Structural motor cradle and inner thigh; the stator-retaining ring is integral with the removable outer clamshell. Knee actuator is recessed 12 mm into the limb root; metal flange and compression sleeves spread mounting loads.
thigh_inner_right | 2 | petg | 0.118985 | Structural motor cradle and inner thigh; the stator-retaining ring is integral with the removable outer clamshell. Knee actuator is recessed 12 mm into the limb root; metal flange and compression sleeves spread mounting loads.
thigh_outer | 2 | petg | 0.122552 | One outer structural clamshell incorporates the motor service ring through a broad open collar outside the crank sweep. Remove this half to expose the motor and stator plate.
thigh_outer_right | 2 | petg | 0.122552 | One outer structural clamshell incorporates the motor service ring through a broad open collar outside the crank sweep. Remove this half to expose the motor and stator plate.
tray_screw_-1_-52 | 1 | steel | 0.001003 | M3 x 8 top-access electronics-deck screw into the fixed brace. Battery and frame screws stay installed during removal.
tray_screw_-1_52 | 1 | steel | 0.001003 | M3 x 8 top-access electronics-deck screw into the fixed brace. Battery and frame screws stay installed during removal.
tray_screw_1_-52 | 1 | steel | 0.001003 | M3 x 8 top-access electronics-deck screw into the fixed brace. Battery and frame screws stay installed during removal.
tray_screw_1_52 | 1 | steel | 0.001003 | M3 x 8 top-access electronics-deck screw into the fixed brace. Battery and frame screws stay installed during removal.
