pedapudi/oddstride/tinfox/proposals/sculpted/model/output/manufacturing/inventory.csv

part | quantity | route | material | oriented size mm | orientation | supports | machining considerations
roll_cartridge_1 | 1 | machining | aluminum | 82.0 x 82.0 x 17.3 | Flange face on bed for a fit-only mockup. | Plastic mockup cannot replace the metal actuator load path. | Multi-setup machining; bore/journal, perpendicular flange and fastener access require supplier review.
roll_cartridge_1_right | 1 | machining | aluminum | 82.0 x 82.0 x 17.3 | Flange face on bed for a fit-only mockup. | Plastic mockup cannot replace the metal actuator load path. | Multi-setup machining; bore/journal, perpendicular flange and fastener access require supplier review.
roll_cartridge_-1 | 1 | machining | aluminum | 82.0 x 82.0 x 17.3 | Flange face on bed for a fit-only mockup. | Plastic mockup cannot replace the metal actuator load path. | Multi-setup machining; bore/journal, perpendicular flange and fastener access require supplier review.
roll_cartridge_-1_right | 1 | machining | aluminum | 82.0 x 82.0 x 17.3 | Flange face on bed for a fit-only mockup. | Plastic mockup cannot replace the metal actuator load path. | Multi-setup machining; bore/journal, perpendicular flange and fastener access require supplier review.
hip_hub | 2 | machining | aluminum | 96.0 x 96.0 x 8.0 | Broad stable face on bed. | Inspect small holes, edge overhangs and first-layer adhesion. | Review stock form, tool reach, setup datums and hole tolerances before CAM.
hip_hub_right | 2 | machining | aluminum | 96.0 x 96.0 x 8.0 | Broad stable face on bed. | Inspect small holes, edge overhangs and first-layer adhesion. | Review stock form, tool reach, setup datums and hole tolerances before CAM.
motor_mount_ring | 2 | machining | aluminum | 96.0 x 96.0 x 3.0 | Broad stable face on bed. | Inspect small holes, edge overhangs and first-layer adhesion. | Review stock form, tool reach, setup datums and hole tolerances before CAM.
motor_mount_ring_right | 2 | machining | aluminum | 96.0 x 96.0 x 3.0 | Broad stable face on bed. | Inspect small holes, edge overhangs and first-layer adhesion. | Review stock form, tool reach, setup datums and hole tolerances before CAM.
motor_carrier_1 | 1 | machining | aluminum | 111.3 x 88.0 x 77.4 | Flange face on bed for a fit-only mockup. | Plastic mockup cannot replace the metal actuator load path. | Multi-setup machining; bore/journal, perpendicular flange and fastener access require supplier review.
motor_carrier_1_right | 1 | machining | aluminum | 111.3 x 88.0 x 77.4 | Flange face on bed for a fit-only mockup. | Plastic mockup cannot replace the metal actuator load path. | Multi-setup machining; bore/journal, perpendicular flange and fastener access require supplier review.
motor_carrier_-1 | 1 | machining | aluminum | 111.3 x 88.0 x 77.4 | Flange face on bed for a fit-only mockup. | Plastic mockup cannot replace the metal actuator load path. | Multi-setup machining; bore/journal, perpendicular flange and fastener access require supplier review.
motor_carrier_-1_right | 1 | machining | aluminum | 111.3 x 88.0 x 77.4 | Flange face on bed for a fit-only mockup. | Plastic mockup cannot replace the metal actuator load path. | Multi-setup machining; bore/journal, perpendicular flange and fastener access require supplier review.
shin_outer | 2 | printed | petg | 166.0 x 34.0 x 24.5 | Fore/aft exterior down, split face upward. Limb length and bearing axis lie in the bed plane. | Use removable local support beneath the rounded exterior and bearing lip. Use both halves, broad mating lands and compression sleeves. Joint slip and layer separation remain unqualified. | Machine the open structural halves, then finish the split bearing bores with the halves bolted against their closure stops. The fork is integral; no internal head is installed.
shin_outer_right | 2 | printed | petg | 166.0 x 34.0 x 24.5 | Fore/aft exterior down, split face upward. Limb length and bearing axis lie in the bed plane. | Use removable local support beneath the rounded exterior and bearing lip. Use both halves, broad mating lands and compression sleeves. Joint slip and layer separation remain unqualified. | Machine the open structural halves, then finish the split bearing bores with the halves bolted against their closure stops. The fork is integral; no internal head is installed.
thigh_inner | 2 | printed | petg | 98.0 x 238.0 x 58.0 | Motor axis near vertical; leg length lies along the bed. | Support below the offset thigh web; the motor-plate recess is now open; use accessible support regions, not filled motor or bearing bores. | Open-ended motor cup and removable outer clamshell improve tool access; finish the motor and sleeve seats from common datums.
thigh_inner_right | 2 | printed | petg | 98.0 x 238.0 x 58.0 | Motor axis near vertical; leg length lies along the bed. | Support below the offset thigh web; the motor-plate recess is now open; use accessible support regions, not filled motor or bearing bores. | Open-ended motor cup and removable outer clamshell improve tool access; finish the motor and sleeve seats from common datums.
thigh_outer | 2 | printed | petg | 99.0 x 238.3 x 44.3 | Exterior down, open structural cavity up; leg length along the bed. | Local support beneath the exterior and integral service-ring webs; keep the cavity accessible and inspect the collar roots layer by layer. | Two setups with a ball-end finish on the outer skin; keep joint datum faces and compression-sleeve seats.
thigh_outer_right | 2 | printed | petg | 99.0 x 238.3 x 44.3 | Exterior down, open structural cavity up; leg length along the bed. | Local support beneath the exterior and integral service-ring webs; keep the cavity accessible and inspect the collar roots layer by layer. | Two setups with a ball-end finish on the outer skin; keep joint datum faces and compression-sleeve seats.
shin_inner | 2 | printed | petg | 166.0 x 34.0 x 24.5 | Fore/aft exterior down, split face upward. Limb length and bearing axis lie in the bed plane. | Use removable local support beneath the rounded exterior and bearing lip. Use both halves, broad mating lands and compression sleeves. Joint slip and layer separation remain unqualified. | Machine the open structural halves, then finish the split bearing bores with the halves bolted against their closure stops. The fork is integral; no internal head is installed.
shin_inner_right | 2 | printed | petg | 166.0 x 34.0 x 24.5 | Fore/aft exterior down, split face upward. Limb length and bearing axis lie in the bed plane. | Use removable local support beneath the rounded exterior and bearing lip. Use both halves, broad mating lands and compression sleeves. Joint slip and layer separation remain unqualified. | Machine the open structural halves, then finish the split bearing bores with the halves bolted against their closure stops. The fork is integral; no internal head is installed.
input_crank | 2 | machining | aluminum | 50.5 x 36.0 x 27.6 | Motor face on bed for a fit mockup. | Fork overhangs require accessible local support; metal production part. | One stepped motor-output coupling and double-shear crank. Finish pilot, bolt circle, pin shoulder bore and M5 thread.
input_crank_right | 2 | machining | aluminum | 50.5 x 36.0 x 27.6 | Motor face on bed for a fit mockup. | Fork overhangs require accessible local support; metal production part. | One stepped motor-output coupling and double-shear crank. Finish pilot, bolt circle, pin shoulder bore and M5 thread.
pushrod | 2 | machining | steel | 15.0 x 185.0 x 6.0 | Broad plate face on bed for a fit-only mockup. | Fit-only: retain metal for the loaded linkage. | Plate blank plus drilled/reamed pin holes; finish mating seats and edge radii.
pushrod_right | 2 | machining | steel | 15.0 x 185.0 x 6.0 | Broad plate face on bed for a fit-only mockup. | Fit-only: retain metal for the loaded linkage. | Plate blank plus drilled/reamed pin holes; finish mating seats and edge radii.
battery_access_latch_-1 | 1 | printed | petg | 22.0 x 4.0 x 1.8 | Broad stable face on bed. | Inspect small holes, edge overhangs and first-layer adhesion. | Review stock form, tool reach, setup datums and hole tolerances before CAM.
battery_access_latch_1 | 1 | printed | petg | 22.0 x 4.0 x 1.8 | Broad stable face on bed. | Inspect small holes, edge overhangs and first-layer adhesion. | Review stock form, tool reach, setup datums and hole tolerances before CAM.
battery_cassette | 1 | printed | petg | 140.0 x 198.6 x 69.5 | Closed base on bed; open pack cavity upward. | Continuous sloped webs support the guide edges; inspect local overhangs in the slicer. Keep the four top-loading nut pockets open; print the cassette base down. | Deep thin-wall enclosure; use an assembled sheet enclosure if machining cost dominates.
battery_latch_-1 | 1 | printed | petg | 18.0 x 9.0 x 5.0 | Broad stable face on bed. | Inspect small holes, edge overhangs and first-layer adhesion. | Review stock form, tool reach, setup datums and hole tolerances before CAM.
battery_latch_1 | 1 | printed | petg | 18.0 x 9.0 x 5.0 | Broad stable face on bed. | Inspect small holes, edge overhangs and first-layer adhesion. | Review stock form, tool reach, setup datums and hole tolerances before CAM.
battery_side_panel_-1 | 1 | printed | petg | 136.0 x 60.0 x 1.6 | Broad stable face on bed. | Inspect small holes, edge overhangs and first-layer adhesion. | Review stock form, tool reach, setup datums and hole tolerances before CAM.
battery_side_panel_1 | 1 | printed | petg | 136.0 x 60.0 x 1.6 | Broad stable face on bed. | Inspect small holes, edge overhangs and first-layer adhesion. | Review stock form, tool reach, setup datums and hole tolerances before CAM.
battery_skid | 1 | machining | aluminum | 138.0 x 190.0 x 1.5 | Broad stable face on bed. | Inspect small holes, edge overhangs and first-layer adhesion. | Review stock form, tool reach, setup datums and hole tolerances before CAM.
belly_center_0 | 1 | printed | petg | 37.7 x 222.4 x 250.8 | Measured orientation minimizes the screened overhang area among axial candidates. | Local supports at compound curves, ribs and shoulder recesses; inspect layer preview before printing. | Thin compound shell; two setups and soft jaws or a vacuum fixture need review.
body_aft_0 | 1 | printed | petg | 118.0 x 103.5 x 222.4 | Measured orientation minimizes the screened overhang area among axial candidates. | Local supports at compound curves, ribs and shoulder recesses; inspect layer preview before printing. | Thin compound shell; two setups and soft jaws or a vacuum fixture need review.
body_center_0 | 1 | printed | petg | 250.8 x 222.4 x 59.5 | Roof exterior down; integral side walls rise upward. | Interior remains open. Local support at display recess, curved roof perimeter and side screw bosses; no trapped bottom cavity. | Top-and-side shell requires two setups and thin-wall workholding; preserve lift-off clearance to frame.
body_nose_surround | 1 | printed | petg | 103.5 x 222.4 x 138.2 | Front rim toward bed; tongue rises upward. | Support beneath return tongue and fascia posts; remove through open rear. | Thin curved wrap with return tongue; multiple setups and workholding tabs need planning.
chassis_beam_-102 | 1 | machining | aluminum | 262.0 x 13.0 x 54.0 | Broad stable face on bed. | Inspect small holes, edge overhangs and first-layer adhesion. | Review stock form, tool reach, setup datums and hole tolerances before CAM.
chassis_beam_102 | 1 | machining | aluminum | 262.0 x 13.0 x 54.0 | Broad stable face on bed. | Inspect small holes, edge overhangs and first-layer adhesion. | Review stock form, tool reach, setup datums and hole tolerances before CAM.
chassis_crossmember_-121 | 1 | machining | aluminum | 8.8 x 202.0 x 12.0 | Broad stable face on bed. | Inspect small holes, edge overhangs and first-layer adhesion. | Review stock form, tool reach, setup datums and hole tolerances before CAM.
chassis_crossmember_121 | 1 | machining | aluminum | 8.8 x 202.0 x 12.0 | Broad stable face on bed. | Inspect small holes, edge overhangs and first-layer adhesion. | Review stock form, tool reach, setup datums and hole tolerances before CAM.
chassis_lower_brace | 1 | machining | aluminum | 134.0 x 202.0 x 3.0 | Broad flat face on bed for an unloaded fit mockup. | Constant 3 mm plate; vertical holes, no designed supports. Use metal for the structural frame candidate. | Flat-cut aluminum outline, clearance holes and four tapped deck mounts. Verify threads and rail-joint strength before loaded use.
electronics_shelf | 1 | printed | petg | 134.0 x 186.0 x 4.0 | Flat underside on bed; all holes and slots vertical. | Constant 4 mm extrusion; no designed bridges or supports. Inspect hole compensation and first layer in the slicer. | Flat cut plate candidate with drilled slots; a future thinner metal version needs a stiffness and mounting-height review.
front_fascia | 1 | printed | petg | 84.5 x 197.4 x 18.8 | Rear rim down, convex exterior upward. | Shallow supports beneath the curved rear skin and bezel; keep support off the visible face and screw holes. | Two setups; retain front perimeter and sensor-opening datums.
lidar_lid | 1 | purchased | aluminum |  | Purchased component; CAD envelope for assembly review. | Select the actual bearing, fastener or sensor component before assembly. | Verify vendor dimensions and retention; no machining operation is specified.
power_button | 1 | printed | petg | 9.0 x 9.0 x 1.0 | Broad stable face on bed. | Inspect small holes, edge overhangs and first-layer adhesion. | Review stock form, tool reach, setup datums and hole tolerances before CAM.
sensor_bezel | 1 | printed | petg | 46.0 x 174.0 x 10.5 | Rear rim down, convex exterior upward. | Shallow supports beneath the curved rear skin and bezel; keep support off the visible face and screw holes. | Two setups; retain front perimeter and sensor-opening datums.
axle_bolt | 2 | purchased | steel |  | Purchased component; CAD envelope for assembly review. | Select the actual bearing, fastener or sensor component before assembly. | Verify vendor dimensions and retention; no machining operation is specified.
axle_bolt_right | 2 | purchased | steel |  | Purchased component; CAD envelope for assembly review. | Select the actual bearing, fastener or sensor component before assembly. | Verify vendor dimensions and retention; no machining operation is specified.
axle_nut | 2 | purchased | steel |  | Purchased component; CAD envelope for assembly review. | Select the actual bearing, fastener or sensor component before assembly. | Verify vendor dimensions and retention; no machining operation is specified.
axle_nut_right | 2 | purchased | steel |  | Purchased component; CAD envelope for assembly review. | Select the actual bearing, fastener or sensor component before assembly. | Verify vendor dimensions and retention; no machining operation is specified.
bearing_inner | 2 | purchased | steel |  | Purchased component; CAD envelope for assembly review. | Select the actual bearing, fastener or sensor component before assembly. | Verify vendor dimensions and retention; no machining operation is specified.
bearing_inner_right | 2 | purchased | steel |  | Purchased component; CAD envelope for assembly review. | Select the actual bearing, fastener or sensor component before assembly. | Verify vendor dimensions and retention; no machining operation is specified.
bearing_outer | 2 | purchased | steel |  | Purchased component; CAD envelope for assembly review. | Select the actual bearing, fastener or sensor component before assembly. | Verify vendor dimensions and retention; no machining operation is specified.
bearing_outer_right | 2 | purchased | steel |  | Purchased component; CAD envelope for assembly review. | Select the actual bearing, fastener or sensor component before assembly. | Verify vendor dimensions and retention; no machining operation is specified.
bolt_0 | 2 | purchased | steel |  | Purchased component; CAD envelope for assembly review. | Select the actual bearing, fastener or sensor component before assembly. | Verify vendor dimensions and retention; no machining operation is specified.
bolt_0_right | 2 | purchased | steel |  | Purchased component; CAD envelope for assembly review. | Select the actual bearing, fastener or sensor component before assembly. | Verify vendor dimensions and retention; no machining operation is specified.
bolt_1 | 2 | purchased | steel |  | Purchased component; CAD envelope for assembly review. | Select the actual bearing, fastener or sensor component before assembly. | Verify vendor dimensions and retention; no machining operation is specified.
bolt_1_right | 2 | purchased | steel |  | Purchased component; CAD envelope for assembly review. | Select the actual bearing, fastener or sensor component before assembly. | Verify vendor dimensions and retention; no machining operation is specified.
foot | 2 | elastomer-fit | rubber | 41.0 x 44.0 x 42.0 | Flat neck toward bed; sole upward. | TPU shape/fit prototype only. The boot retention cavity and fastener are not yet detailed. | Elastomer part: print TPU or develop a mold; do not mill this as a rigid metal foot.
foot_right | 2 | elastomer-fit | rubber | 41.0 x 44.0 x 42.0 | Flat neck toward bed; sole upward. | TPU shape/fit prototype only. The boot retention cavity and fastener are not yet detailed. | Elastomer part: print TPU or develop a mold; do not mill this as a rigid metal foot.
input_pin | 2 | purchased | steel |  | Purchased component; CAD envelope for assembly review. | Select the actual bearing, fastener or sensor component before assembly. | Verify vendor dimensions and retention; no machining operation is specified.
input_pin_right | 2 | purchased | steel |  | Purchased component; CAD envelope for assembly review. | Select the actual bearing, fastener or sensor component before assembly. | Verify vendor dimensions and retention; no machining operation is specified.
knee_axle | 2 | stock-fabrication | steel |  | Cut and finish stock tube or rod to the modeled dimensions. | Use the specified metal stock; no production print orientation is assigned. | Deburr and finish end faces, bores and pin fits as required by the mating assembly.
knee_axle_right | 2 | stock-fabrication | steel |  | Cut and finish stock tube or rod to the modeled dimensions. | Use the specified metal stock; no production print orientation is assigned. | Deburr and finish end faces, bores and pin fits as required by the mating assembly.
knee_inner_spacer | 2 | stock-fabrication | steel |  | Cut and finish stock tube or rod to the modeled dimensions. | Use the specified metal stock; no production print orientation is assigned. | Deburr and finish end faces, bores and pin fits as required by the mating assembly.
knee_inner_spacer_right | 2 | stock-fabrication | steel |  | Cut and finish stock tube or rod to the modeled dimensions. | Use the specified metal stock; no production print orientation is assigned. | Deburr and finish end faces, bores and pin fits as required by the mating assembly.
output_pin | 2 | purchased | steel |  | Purchased component; CAD envelope for assembly review. | Select the actual bearing, fastener or sensor component before assembly. | Verify vendor dimensions and retention; no machining operation is specified.
output_pin_right | 2 | purchased | steel |  | Purchased component; CAD envelope for assembly review. | Select the actual bearing, fastener or sensor component before assembly. | Verify vendor dimensions and retention; no machining operation is specified.
output_pivot_nut | 2 | purchased | steel |  | Purchased component; CAD envelope for assembly review. | Select the actual bearing, fastener or sensor component before assembly. | Verify vendor dimensions and retention; no machining operation is specified.
output_pivot_nut_right | 2 | purchased | steel |  | Purchased component; CAD envelope for assembly review. | Select the actual bearing, fastener or sensor component before assembly. | Verify vendor dimensions and retention; no machining operation is specified.
pod_sleeve_210 | 2 | stock-fabrication | aluminum |  | Cut and finish stock tube or rod to the modeled dimensions. | Use the specified metal stock; no production print orientation is assigned. | Deburr and finish end faces, bores and pin fits as required by the mating assembly.
pod_sleeve_210_right | 2 | stock-fabrication | aluminum |  | Cut and finish stock tube or rod to the modeled dimensions. | Use the specified metal stock; no production print orientation is assigned. | Deburr and finish end faces, bores and pin fits as required by the mating assembly.
pod_sleeve_330 | 2 | stock-fabrication | aluminum |  | Cut and finish stock tube or rod to the modeled dimensions. | Use the specified metal stock; no production print orientation is assigned. | Deburr and finish end faces, bores and pin fits as required by the mating assembly.
pod_sleeve_330_right | 2 | stock-fabrication | aluminum |  | Cut and finish stock tube or rod to the modeled dimensions. | Use the specified metal stock; no production print orientation is assigned. | Deburr and finish end faces, bores and pin fits as required by the mating assembly.
pod_sleeve_90 | 2 | stock-fabrication | aluminum |  | Cut and finish stock tube or rod to the modeled dimensions. | Use the specified metal stock; no production print orientation is assigned. | Deburr and finish end faces, bores and pin fits as required by the mating assembly.
pod_sleeve_90_right | 2 | stock-fabrication | aluminum |  | Cut and finish stock tube or rod to the modeled dimensions. | Use the specified metal stock; no production print orientation is assigned. | Deburr and finish end faces, bores and pin fits as required by the mating assembly.
pod_tie_210 | 2 | purchased | steel |  | Purchased component; CAD envelope for assembly review. | Select the actual bearing, fastener or sensor component before assembly. | Verify vendor dimensions and retention; no machining operation is specified.
pod_tie_210_right | 2 | purchased | steel |  | Purchased component; CAD envelope for assembly review. | Select the actual bearing, fastener or sensor component before assembly. | Verify vendor dimensions and retention; no machining operation is specified.
pod_tie_330 | 2 | purchased | steel |  | Purchased component; CAD envelope for assembly review. | Select the actual bearing, fastener or sensor component before assembly. | Verify vendor dimensions and retention; no machining operation is specified.
pod_tie_330_right | 2 | purchased | steel |  | Purchased component; CAD envelope for assembly review. | Select the actual bearing, fastener or sensor component before assembly. | Verify vendor dimensions and retention; no machining operation is specified.
pod_tie_90 | 2 | purchased | steel |  | Purchased component; CAD envelope for assembly review. | Select the actual bearing, fastener or sensor component before assembly. | Verify vendor dimensions and retention; no machining operation is specified.
pod_tie_90_right | 2 | purchased | steel |  | Purchased component; CAD envelope for assembly review. | Select the actual bearing, fastener or sensor component before assembly. | Verify vendor dimensions and retention; no machining operation is specified.
shin_clamp_bolt_105 | 2 | purchased | steel |  | Purchased component; CAD envelope for assembly review. | Select the actual bearing, fastener or sensor component before assembly. | Verify vendor dimensions and retention; no machining operation is specified.
shin_clamp_bolt_105_right | 2 | purchased | steel |  | Purchased component; CAD envelope for assembly review. | Select the actual bearing, fastener or sensor component before assembly. | Verify vendor dimensions and retention; no machining operation is specified.
shin_clamp_bolt_37 | 2 | purchased | steel |  | Purchased component; CAD envelope for assembly review. | Select the actual bearing, fastener or sensor component before assembly. | Verify vendor dimensions and retention; no machining operation is specified.
shin_clamp_bolt_37_right | 2 | purchased | steel |  | Purchased component; CAD envelope for assembly review. | Select the actual bearing, fastener or sensor component before assembly. | Verify vendor dimensions and retention; no machining operation is specified.
shin_clamp_nut_105 | 2 | purchased | steel |  | Purchased component; CAD envelope for assembly review. | Select the actual bearing, fastener or sensor component before assembly. | Verify vendor dimensions and retention; no machining operation is specified.
shin_clamp_nut_105_right | 2 | purchased | steel |  | Purchased component; CAD envelope for assembly review. | Select the actual bearing, fastener or sensor component before assembly. | Verify vendor dimensions and retention; no machining operation is specified.
shin_clamp_nut_37 | 2 | purchased | steel |  | Purchased component; CAD envelope for assembly review. | Select the actual bearing, fastener or sensor component before assembly. | Verify vendor dimensions and retention; no machining operation is specified.
shin_clamp_nut_37_right | 2 | purchased | steel |  | Purchased component; CAD envelope for assembly review. | Select the actual bearing, fastener or sensor component before assembly. | Verify vendor dimensions and retention; no machining operation is specified.
shin_clamp_sleeve_105 | 2 | stock-fabrication | aluminum |  | Cut and finish stock tube or rod to the modeled dimensions. | Use the specified metal stock; no production print orientation is assigned. | Deburr and finish end faces, bores and pin fits as required by the mating assembly.
shin_clamp_sleeve_105_right | 2 | stock-fabrication | aluminum |  | Cut and finish stock tube or rod to the modeled dimensions. | Use the specified metal stock; no production print orientation is assigned. | Deburr and finish end faces, bores and pin fits as required by the mating assembly.
shin_clamp_sleeve_37 | 2 | stock-fabrication | aluminum |  | Cut and finish stock tube or rod to the modeled dimensions. | Use the specified metal stock; no production print orientation is assigned. | Deburr and finish end faces, bores and pin fits as required by the mating assembly.
shin_clamp_sleeve_37_right | 2 | stock-fabrication | aluminum |  | Cut and finish stock tube or rod to the modeled dimensions. | Use the specified metal stock; no production print orientation is assigned. | Deburr and finish end faces, bores and pin fits as required by the mating assembly.
sleeve_0 | 2 | stock-fabrication | aluminum |  | Cut and finish stock tube or rod to the modeled dimensions. | Use the specified metal stock; no production print orientation is assigned. | Deburr and finish end faces, bores and pin fits as required by the mating assembly.
sleeve_0_right | 2 | stock-fabrication | aluminum |  | Cut and finish stock tube or rod to the modeled dimensions. | Use the specified metal stock; no production print orientation is assigned. | Deburr and finish end faces, bores and pin fits as required by the mating assembly.
sleeve_1 | 2 | stock-fabrication | aluminum |  | Cut and finish stock tube or rod to the modeled dimensions. | Use the specified metal stock; no production print orientation is assigned. | Deburr and finish end faces, bores and pin fits as required by the mating assembly.
sleeve_1_right | 2 | stock-fabrication | aluminum |  | Cut and finish stock tube or rod to the modeled dimensions. | Use the specified metal stock; no production print orientation is assigned. | Deburr and finish end faces, bores and pin fits as required by the mating assembly.
