pedapudi/oddstride/tinfox/proposals/sculpted/model/output/limb-variants/cnc/inventory.csv

part | quantity | material | process | STEP | print STL
roll_cartridge_1 | 1 | aluminum | CNC manufacturing review | step/roll_cartridge_1.step
motor_carrier_1 | 1 | aluminum | CNC manufacturing review | step/motor_carrier_1.step
hip_hub | 2 | aluminum | CNC manufacturing review | step/hip_hub.step
motor_mount_ring | 2 | aluminum | CNC manufacturing review | step/motor_mount_ring.step
thigh_inner | 2 | aluminum | CNC manufacturing review | step/thigh_inner.step
thigh_outer | 2 | aluminum | CNC manufacturing review | step/thigh_outer.step
input_crank | 2 | aluminum | CNC manufacturing review | step/input_crank.step
pushrod | 2 | steel | CNC manufacturing review | step/pushrod.step
shin_inner | 2 | aluminum | CNC manufacturing review | step/shin_inner.step
shin_outer | 2 | aluminum | CNC manufacturing review | step/shin_outer.step
roll_cartridge_1_right | 1 | aluminum | CNC manufacturing review | step/roll_cartridge_1_right.step
motor_carrier_1_right | 1 | aluminum | CNC manufacturing review | step/motor_carrier_1_right.step
hip_hub_right | 2 | aluminum | CNC manufacturing review | step/hip_hub_right.step
motor_mount_ring_right | 2 | aluminum | CNC manufacturing review | step/motor_mount_ring_right.step
thigh_inner_right | 2 | aluminum | CNC manufacturing review | step/thigh_inner_right.step
thigh_outer_right | 2 | aluminum | CNC manufacturing review | step/thigh_outer_right.step
input_crank_right | 2 | aluminum | CNC manufacturing review | step/input_crank_right.step
pushrod_right | 2 | steel | CNC manufacturing review | step/pushrod_right.step
shin_inner_right | 2 | aluminum | CNC manufacturing review | step/shin_inner_right.step
shin_outer_right | 2 | aluminum | CNC manufacturing review | step/shin_outer_right.step
roll_cartridge_-1 | 1 | aluminum | CNC manufacturing review | step/roll_cartridge_-1.step
motor_carrier_-1 | 1 | aluminum | CNC manufacturing review | step/motor_carrier_-1.step
roll_cartridge_-1_right | 1 | aluminum | CNC manufacturing review | step/roll_cartridge_-1_right.step
motor_carrier_-1_right | 1 | aluminum | CNC manufacturing review | step/motor_carrier_-1_right.step
