pedapudi/oddstride/tinfox/proposals/sculpted/model/output/limb-variants/hybrid/front-left-inventory.csv

part | quantity | material | STEP | print STL
roll_cartridge_1 | 1 | aluminum | step/roll_cartridge_1.step
motor_carrier_1 | 1 | aluminum | step/motor_carrier_1.step
hip_hub | 1 | aluminum | step/hip_hub.step
motor_mount_ring | 1 | aluminum | step/motor_mount_ring.step
thigh_inner | 1 | petg | step/thigh_inner.step | print-stl/thigh_inner.stl
thigh_outer | 1 | petg | step/thigh_outer.step | print-stl/thigh_outer.stl
input_crank | 1 | aluminum | step/input_crank.step
pushrod | 1 | steel | step/pushrod.step
shin_inner | 1 | petg | step/shin_inner.step | print-stl/shin_inner.stl
shin_outer | 1 | petg | step/shin_outer.step | print-stl/shin_outer.stl
