pedapudi/oddstride/tinfox/proposals/sculpted/model/output/limb-variants/printed/front-left-inventory.csv

part | quantity | material | STEP | print STL
roll_cartridge_1 | 1 | petg | step/roll_cartridge_1.step | print-stl/roll_cartridge_1.stl
hip_hub | 1 | petg | step/hip_hub.step | print-stl/hip_hub.stl
motor_mount_ring | 1 | petg | step/motor_mount_ring.step | print-stl/motor_mount_ring.stl
thigh_inner | 1 | petg | step/thigh_inner.step | print-stl/thigh_inner.stl
thigh_outer | 1 | petg | step/thigh_outer.step | print-stl/thigh_outer.stl
input_crank | 1 | petg | step/input_crank.step | print-stl/input_crank.stl
pushrod | 1 | petg | step/pushrod.step | print-stl/pushrod.stl
shin_inner | 1 | petg | step/shin_inner.step | print-stl/shin_inner.stl
shin_outer | 1 | petg | step/shin_outer.step | print-stl/shin_outer.stl
motor_carrier_1_trunnion | 1 | petg | step/motor_carrier_1_trunnion.step | print-stl/motor_carrier_1_trunnion.stl
motor_carrier_1_flange | 1 | petg | step/motor_carrier_1_flange.step | print-stl/motor_carrier_1_flange.stl
