pedapudi/oddstride/tinfox/proposals/sculpted/model/output/limb-variants/printed/inventory.csv

part | quantity | material | process | STEP | print STL
roll_cartridge_1 | 1 | petg | Print and inspect | step/roll_cartridge_1.step | print-stl/roll_cartridge_1.stl
hip_hub | 2 | petg | Print and inspect | step/hip_hub.step | print-stl/hip_hub.stl
motor_mount_ring | 2 | petg | Print and inspect | step/motor_mount_ring.step | print-stl/motor_mount_ring.stl
thigh_inner | 2 | petg | Print and inspect | step/thigh_inner.step | print-stl/thigh_inner.stl
thigh_outer | 2 | petg | Print and inspect | step/thigh_outer.step | print-stl/thigh_outer.stl
input_crank | 2 | petg | Print and inspect | step/input_crank.step | print-stl/input_crank.stl
pushrod | 2 | petg | Print and inspect | step/pushrod.step | print-stl/pushrod.stl
shin_inner | 2 | petg | Print and inspect | step/shin_inner.step | print-stl/shin_inner.stl
shin_outer | 2 | petg | Print and inspect | step/shin_outer.step | print-stl/shin_outer.stl
roll_cartridge_1_right | 1 | petg | Print and inspect | step/roll_cartridge_1_right.step | print-stl/roll_cartridge_1_right.stl
hip_hub_right | 2 | petg | Print and inspect | step/hip_hub_right.step | print-stl/hip_hub_right.stl
motor_mount_ring_right | 2 | petg | Print and inspect | step/motor_mount_ring_right.step | print-stl/motor_mount_ring_right.stl
thigh_inner_right | 2 | petg | Print and inspect | step/thigh_inner_right.step | print-stl/thigh_inner_right.stl
thigh_outer_right | 2 | petg | Print and inspect | step/thigh_outer_right.step | print-stl/thigh_outer_right.stl
input_crank_right | 2 | petg | Print and inspect | step/input_crank_right.step | print-stl/input_crank_right.stl
pushrod_right | 2 | petg | Print and inspect | step/pushrod_right.step | print-stl/pushrod_right.stl
shin_inner_right | 2 | petg | Print and inspect | step/shin_inner_right.step | print-stl/shin_inner_right.stl
shin_outer_right | 2 | petg | Print and inspect | step/shin_outer_right.step | print-stl/shin_outer_right.stl
roll_cartridge_-1 | 1 | petg | Print and inspect | step/roll_cartridge_-1.step | print-stl/roll_cartridge_-1.stl
roll_cartridge_-1_right | 1 | petg | Print and inspect | step/roll_cartridge_-1_right.step | print-stl/roll_cartridge_-1_right.stl
motor_carrier_1_trunnion | 1 | petg | Print and inspect | step/motor_carrier_1_trunnion.step | print-stl/motor_carrier_1_trunnion.stl
motor_carrier_1_flange | 1 | petg | Print and inspect | step/motor_carrier_1_flange.step | print-stl/motor_carrier_1_flange.stl
motor_carrier_1_right_trunnion | 1 | petg | Print and inspect | step/motor_carrier_1_right_trunnion.step | print-stl/motor_carrier_1_right_trunnion.stl
motor_carrier_1_right_flange | 1 | petg | Print and inspect | step/motor_carrier_1_right_flange.step | print-stl/motor_carrier_1_right_flange.stl
motor_carrier_-1_trunnion | 1 | petg | Print and inspect | step/motor_carrier_-1_trunnion.step | print-stl/motor_carrier_-1_trunnion.stl
motor_carrier_-1_flange | 1 | petg | Print and inspect | step/motor_carrier_-1_flange.step | print-stl/motor_carrier_-1_flange.stl
motor_carrier_-1_right_trunnion | 1 | petg | Print and inspect | step/motor_carrier_-1_right_trunnion.step | print-stl/motor_carrier_-1_right_trunnion.stl
motor_carrier_-1_right_flange | 1 | petg | Print and inspect | step/motor_carrier_-1_right_flange.step | print-stl/motor_carrier_-1_right_flange.stl
