pedapudi/oddstride/tinfox/proposals/sculpted/model/output/flat-patterns/chassis_lower_brace.dxf

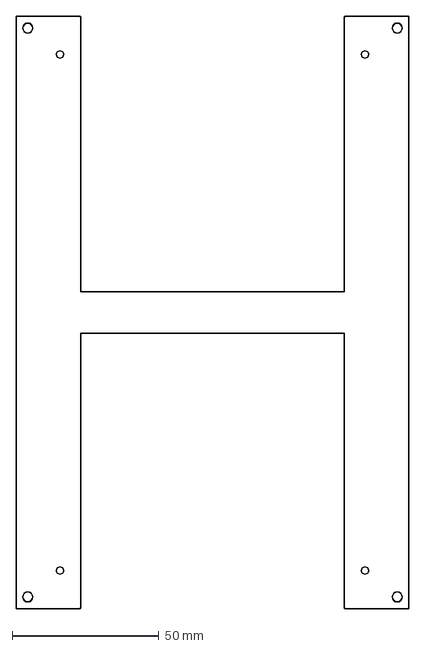
[picture p67: CAD file, 2026-11-11]
tinfox/proposals/sculpted/model/output/flat-patterns/chassis_lower_brace.dxf
134.0 x 202.0 mm
