pedapudi/oddstride/tinfox/proposals/sculpted/model/output/flat-patterns/electronics_shelf.dxf

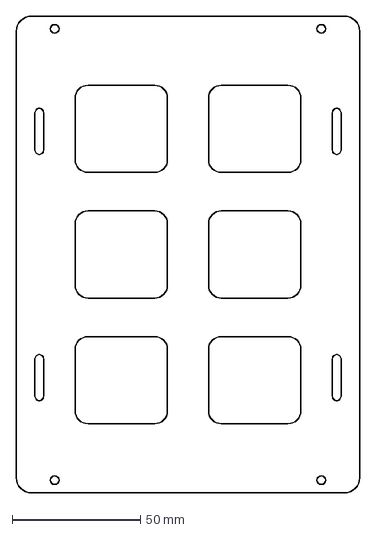
[picture p68: CAD file, 2026-11-11]
tinfox/proposals/sculpted/model/output/flat-patterns/electronics_shelf.dxf
134.0 x 186.0 mm
