pedapudi/oddstride/tinfox/proposals/sculpted/model/output/print-handoff/Tinfox-Motor-Interface-Fit-20261029T082638Z/README.md

# RS02 case and output-hub fit plate

Print the two case-clearance gauges and the native hip output hub in
`00-RS02-motor-fit.3mf`. The gauges retain their recorded generated source;
the reusable hub derives from the canonical native Fusion part. The manifest
records exact source hashes. Motor stator plates and the motor cup are being
revised for confirmed fastener contacts and are deliberately omitted here.

Use the actual H2D single-nozzle, filament and nozzle profile in Bambu Studio.
This plate is unsliced. Inspect orientation, supports and layers, then let
prints cool before checking motor seating and output-hole alignment. Keep
the motor disconnected and supported. Do not pull a misaligned fit together
with screw tension. These checks do not qualify loaded or powered operation.
