pedapudi/oddstride/tinfox/proposals/sculpted/model/output/print-handoff/Tinfox-Motor-Interface-Fit-20261029T091525Z/README.md

# RS02 auxiliary case gauges

The plate contains only two generated diagnostic gauges: 80.5 mm for the thigh
case opening and 81.5 mm for the hip cup. Their immutable source hashes are
recorded in the manifest. Robot components are omitted while their native
fastener and case-clearance revisions complete independent assembly checks.

Open `00-RS02-motor-fit.3mf` in Bambu Studio using the actual H2D single-nozzle,
filament and nozzle profile. This file is unsliced; inspect the layers and let
prints cool before checking motor-case fit. These short rings do not test
mounting holes, connectors, bearings or the complete motor assembly.
