pedapudi/oddstride/tinfox/proposals/sculpted/model/output/print-handoff/Tinfox-Motor-Interface-Fit-20261029T094548Z/README.md

# RS02 motor fit plate

Open `00-RS02-motor-fit.3mf` in Bambu Studio using the actual H2D single-nozzle,
filament and nozzle profile. This file is unsliced; review orientation, supports
and layers before printing.

The two short case-clearance gauges retain their recorded generated source.
The three reusable motor interfaces derive from the current canonical native
Fusion parts. Their source versions, export hashes and print provenance are
recorded in the manifests. These gauges do not qualify loaded operation.

Use the revised countersunk knee-stator interface and the specified common
M3 flat-head screws. The earlier socket-head stator plate is a historical fit
reference and must not be reused for the actuated limb. The hip flange and hub
can be reused if their actual fit and source geometry match the current parts.

Let every print cool, then check motor seating and mounting-hole alignment.
Keep motors disconnected and supported; do not use screw tension to pull a
misaligned interface into place. The complete motor-complex package contains
the current hardware table and assembly instructions.
