pedapudi/oddstride/tinfox/proposals/sculpted/model/output/print-handoff/Tinfox-Motor-Interface-Fit-20261029T233900Z/README.md

# RS02 integrated motor fit plate

Open `00-RS02-motor-fit.3mf` in Bambu Studio using the actual H2D single-nozzle,
filament and nozzle profile. The plate contains the native primary structural
motor cradle and two unchanged generated case gauges. It is unsliced. Review
supports, especially beneath the cradle's offset motor face and knee region.

The primary cradle is a reusable part of the integrated thigh. It tests the hip
output flange, knee motor insertion and short socket-head stator seats. The
two rings test only nominal case clearance: 80.5 mm for the thigh and 81.5 mm
for the hip cup. They do not test connectors, bearings or complete assembly.
Separate hip hubs and stator plates belong to an earlier design.

Source versions and hashes are recorded in the manifests. Let prints cool
before checking fit. Keep motors disconnected and supported; do not pull a
misaligned interface together with screw tension. Use the full motor-complex
package's hardware list and assembly guide. These parts qualify only supported,
unpowered fit checks, not printed strength or loaded operation.
