pedapudi/oddstride/tinfox/analysis/dfma/motor-complex-fit/rs02-manual.txt

RS02使用说明书
注意事项
 1. 请按照本文规定的工作参数使用，否则可能会对本产品造成严重的损坏！

 2. 在关节运行时不可切换控制方式，如需切换需要发送停止运行命令后再做切换。

 3. 使用前请检查各部件是否完好，如发生部件缺失、损坏请及时联系技术支持。

 4. 请勿随意拆卸电机，以免出现无法恢复的故障。

 5. 确保电机连接时无短路，接口按要求正确连接。

法律声明
  在使用本产品前，请用户务必仔细阅读本手册，按照本手册内容操作本产品。如用户违反本手册内
容使用本产品，造成的任何财产损失、人身伤害事故，本公司不承担任何责任。 因本产品由众多零部件
构成，切勿让儿童接触本产品，以免发生意外事故。为延长产品使用寿命，请勿在高温、高压环境中使
用本产品。本手册在印刷时已尽可能的包含各项功能介绍和使用说明。但由于产品功能不断完善、设计
变更等，仍可能与用户购买的产品有不符之处。

  本手册与实际产品在颜色、外观等方面可能有所偏差，请以实际产品为准。本手册由北京灵足时代
科技有限公司（下简称灵足）出版，灵足随时可能对本手册中不准确的最新信息进行必要的改进和更
改，或对程序和/或设备进行改进。此类更改将上传电子版说明书到公司官网，详情可查看下载中心栏
（www.robstride.com）。所有图片仅供功能说明参考，请以实物为准。

售后政策
  本产品售后服务严格依据《中华人民共和国消费者权益保护法》、《中华人民共和国产品质量法》
实行售后服务，服务内容如下：

 1. 保修期限及内容

    1. 凡在线上渠道下单购买本产品的用户，可在自签收次日起七日内享受无理由退货服务。退货时
     用户须出示有效购买凭证，并退回发票。用户须保证退货商品保持原有品质和功能、外观完
     好、商品本身及配件的商标和各种标识完整齐全，如有赠品需一并退回。如果商品出现人为损
     坏、人为拆机、包装箱缺失、零配件缺失的情况，不予办理退货。 退货时产生的物流费用由
     用户承担（收费标准见“售后服务收费标准”）。如果用户未结清物流费用，将按实际发生额从
     退款金额中扣除。 自收到退货商品之日起七日内向用户返还已支付的货款。退款方式与付款
     方式相同。具体到账日期可能会受银行、支付机构等因素影响。

    2. 本产品保修期为1年。

    3. 自用户签收次日起7天内，发生非人为损坏性能故障，经由灵足售后服务中心检测确认后，为
     用户办理退货业务，退货时用户须出示有效购买凭证，并退回发票。如有赠品需一并退回。

    4. 自用户签收次日起7天后至15天内，发生非人为损坏性能故障，经由灵足售后服务中心检测确
     认后，为用户办理换货业务，更换整套商品。换货后，商品本身三包期重新计算。

    5. 自用户签收次日起15天后至365天内，经由灵足售后服务中心检测确认后，属于产品本身质量
     故障，可免费提供维修服务。更换的故障产品归灵足公司所有。无故障产品，将原样返回。本
     产品经过各项严格检测后出厂，如有非产品本身质量故障，我们将有权拒绝用户的退换货需
     求。

 2. 非保修条例以下情况不属于保修范围：

    1. 超出保修条款所限定的保修期限。

    2. 未按照说明书要求，错误使用造成的产品损坏损毁。

    3. 不当的操作、维修、安装、改装、测试等不正当使用造成的损坏损毁。

    4. 非质量故障引起的常规机械损耗、磨损。

    5. 非正常工况下造成的损坏，包括但不限于跌落、撞击、液体浸入、剧烈撞击等。

    6. 天灾（如水灾、火灾、雷击、地震等）或不可抗击力造成的损坏。

    7. 超过峰值扭矩使用造成的损坏。

    8. 超过峰值扭矩使用造成的损坏。

    9. 其他非产品的设计、技术、制造、质量等问题导致的故障或损坏。

   10. 将本产品应用于商业用途。

  如果出现上述情况，用户需自行支付费用。

电机规格参数
外形及安装尺寸

固定时螺丝深入长度请勿超过机壳螺纹深度

标准使用状态
1. 额定电压： 48 VDC

2. 使用电压范围： 24V—60 VDC

3. 额定负载（CW）： 6 N.m

4. 运转方向： CW/CCW 从出轴方向看

5. 使用姿势：出轴方向为水平或者垂直

6. 标准使用温度：25±5℃

7. 使用温度范围：-20～50℃

8. 标准使用湿度：65%

9. 使用湿度范围：5～85%,无凝露

10. 保存温度范围：-30～70℃

11. 绝缘等级：Class B

电气特性
1. 空载转速：410 rpm±10%

2. 空载电流：0.5 Arms

3. 额定负载： 6 N.m

4. 额定负载转速：360rpm±10%

5. 额定负载相电流(峰值)：7Apk±10%

6. 峰值负载：17 N.m

7. 最大负载相电流(峰值)：23Apk±10%

8. 绝缘电阻/定子绕组：DC 500VAC, 100M Ohms

9. 耐高压/定子与机壳： 600 VAC, 1s, 2mA

10. 电机反电势：0.096Vrms/rpm±10%

11. 转矩常数：1.22N.m/Arms

12. T-N曲线 （36V）

13. T-N曲线 （48V）

14. 最大过载曲线

测试条件：环境温度：25℃

绕阻极限温度：135℃（此为约束温度，实际为180度）

转速：24rpm

测试数据

机械特性
 1. 重量：380g±3g

 2. 极数：28极

 3. 相数：3相

 4. 驱动方式：FOC

 5. 减速比：7.75：1

驱动器产品信息
驱动器产品规格
项目                               数据

额定工作电压                           48VDC

允许最大电压                           60VDC

额定工作相电流                          7Apk

最大允许相电流                          23Apk

待机功率                             ≤18mA

CAN总线比特率                         1Mbps

尺寸                               Φ58mm

工作环境温度                           -20℃至50℃

控制板允许最大温度                        80℃

编码器分辨率                           14bit（单圈绝对值）

驱动器接口定义

驱动器接口推荐品牌及型号
板端型号                品牌厂家           线端型号              品牌厂家

XT30PB(2+2)-M.G.B   AMASS（艾迈斯）     XT30(2+2)-F.G.B   AMASS（艾迈斯）

驱动器功能引脚及器件说明
1. 电源及CAN通信

     引脚              说明

     1               电源正极（+）

      引脚             说明

      2              电源负极（-）

      3              CAN通信低侧CAN_L

      4              CAN通信高侧CAN_H

 2. 下载口

      引脚              说明

      1               SWDIO（数据）

      2               SWCLK（时钟）

      3               3V3（正极3.3V）

      4               GND（负极地）

 3. 指示灯

      引脚        说明

      1         蓝色信号灯闪烁时，证明程序运行正常

      2         电源指示灯，该灯亮红色，则证明整个网络供电正常

主要器件及规格
 序号        项目        规格                                   数量

 1         MCU芯片     GD32F303RGT6                         1 PCS

 2         驱动芯片      DRV8353-SRTAR                        1 PCS

 3         磁编码器芯片    AS5047P                              2 PCS

 4         热敏电阻      NXFT15XH103FEAB021/NCP18XH103F03RB   2 PCS

 5         功率MOS     JMGG031V06A                          6 PCS

上位机使用说明
请前往www.robstride.com官网下载中心下载

硬件配置
     关节电机采用CAN通信方式，通信线有两根，通过can转USB工具与调试器相连，调试器需要提前安
装ch340驱动，默认工作在AT模式。

     需要注意的是，我们是根据特定的can转USB工具开发的调试器，因此需要用我们推荐的串口工具来
进行调试器调试，如果想要##移植到其他调试器平台可以参照说明书的第三章进行开发。

     can转USB工具推荐使用灵足时代官方的USB-CAN模块，对应串口协议的帧头为41 54，帧尾为0D
0A。

上位机界面及说明

主要包括：

A. 模块选择

   设备模块

   配置模块

   分析模块

   帮助模块

B. 子模块选择

   连接或断开电机设备

   电机设备信息

   电机编码器标定

   修改电机CAN ID

   设置电机的机械零位

   电机程序升级

参数表，可以查看并修改电机参数

   上传参数，可以将电机中参数上传到参数表中

   下载参数，可以将参数表中数据下载到电机中

   导出参数，可以将参数表中数据下载到本地

   恢复出厂，可以将参数表中数据恢复出厂设置

   清除警告，可以清除电机报错，如温度过高等

分析模块包括：

   示波器，可以查看参数随时间变化曲线

   频率，可以调整查看数据的频率

   信道，可以配置查看的数据

   开始、停止绘图

   输出波形数据到本地

帮助模块包括：

   使用说明，可以打开使用说明书

   关于，可以查看软件信息

C. 电机信息查询

   设备信息

   参数表信息

D. 数据栏

   日志信息

   通信信息

E. 运行调试区

   选择设备

   便捷操作区，可以快速控制电机正反转

   运动控制区，可以控制电机按各模式运行

F. 子模块显示区

电机设置
电机连接设置

连接can转USB工具（安装ch340驱动，默认工作在AT模式），点击设备模块中的连接子模块，选择对应
串口连接和电机类型，点击连接。

基本设置

 1. 修改电机id号。

 2. 电机磁编标定，电机板与电机重新安装，或电机三相线重新换顺序连接等，需要重新进行磁编标
   定。

 3. 设置零位（掉电丢失），设置当前位置为0。

 4. 电机程序升级，当电机程序有更新时，点击升级按钮选中升级文件即可进行升级。

参数表

  成功连接电机后，点击配置模块中的参数表模块，日志中会显示全部参数加载成功，说明成功读取
到电机相关参数（注：参数表需要在电机处于待机状态下进行配置，如果电机处于运行状态则无法进行
参数表刷新），界面会显示电机的相关参数，蓝色的参数为电机内部的存储参数，可以在相应参数后面
的当前值栏进行修改，点击下载参数可以将调试器中参数下载到电机中，点击上传参数可以将电机中的
参数上传到调试器中，电机恢复绿色参数为观测参数，为采集得到的参数，可进行实时观测。

  注：电机的转矩限制、保护温度、过温时间请勿随意更改。因违规操作本产品导致对人体造成伤
害，或对关节造成不可逆的损伤，我司将不承担任何法律责任。

                           参数类      属          最小   当前值（供参
功能码      名称                              最大值                       备注
                           型        性          值    考）

                                    读/
0X0000   Name              String                   ÿÿÿÿÿÿÿÿÿÿÿÿ
                                    写

                                    读/
0X0001   BarCode           String                   ÿÿÿÿÿÿÿÿÿÿÿÿ
                                    写

                                    只
0X1000   BootCodeVersion   String                   0.1.5
                                    读

                                    只
0X1001   BootBuildDate     String                   Mar 16 2022
                                    读

                                    只
0X1002   BootBuildTime     String                   20:22:09
                                    读

                                    只                              电机程序
0X1003   AppCodeVersion    String                   0.0.0.1
                                    读                              版本号

                                    只
0X1004   AppGitVersion     String                   7b844b0fM
                                    读

                        参数类      属              最小     当前值（供参
功能码      名称                           最大值                             备注
                        型        性              值      考）

                                 只
0X1005   AppBuildDate   String                         Apr 14 2022
                                 读

                                 只
0X1006   AppBuildTime   String                         20:30:22
                                 读

                                 只
0X1007   AppCodeName    String                         Lingzu_motor
                                 读

                                 配
0X2000   echoPara1      uint16        74        5      5
                                 置

                                 配
0X2001   echoPara2      uint16        74        5      5
                                 置

                                 配
0X2002   echoPara3      uint16        74        5      5
                                 置

                                 配
0X2003   echoPara4      uint16        74        5      5
                                 置

                                 读/
0X2004   echoFreHz      uint32        10000     1      500
                                 写

                                                                      电机磁编
                                 设
0X2005   MechOffset     float         7         -7     4.619583       码器角度
                                 定
                                                                      偏置

                                                                      初始多圈
                                 读/
0X2006   MechPos_init   float         50        -50    4.52           时的参考
                                 写
                                                                      角度

                                 读/
0X2007   limit_torque   float         17        0      17             转矩限制
                                 写

                                 读/                                   弱磁电流
0X2008   I_FW_MAX       float         33        0      0
                                 写                                    值，默认0

                                                                      电机
                                 设                                    index，标
0X2009   motor_baud     uint8         20        0      1
                                 定                                    记电机关
                                                                      节位置

                                 设
0X200a   CAN_ID         uint8         127       0      1              本节点id
                                 定

                                 设
0X200b   CAN_MASTER     uint8         127       0      0              can主机id
                                 定

                                 读/                                   can超时阈
0X200c   CAN_TIMEOUT    uint32        100000    0      0
                                 写                                    值，默认0

                                 读/
0X200d   status2        int16         1500      0      800            保留参数
                                 写

                                 读/
0X200e   status3        uint32        1000000   1000   20000          保留参数
                                 写

                         参数类      属          最小   当前值（供参
功能码      名称                            最大值                 备注
                         型        性          值    考）

                                  读/
0X200f   status1         float         64    1    7.75     保留参数
                                  写

                                  读/
0X2010   Status6         uint8         1     0    1        保留参数
                                  写

                                  读/                       电流滤波
0X2011   cur_filt_gain   float         1     0    0.9
                                  写                        参数

                                  读/
0X2012   cur_kp          float         200   0    0.025    电流kp
                                  写

                                  读/
0X2013   cur_ki          float         200   0    0.0258   电流ki
                                  写

                                  读/
0X2014   spd_kp          float         200   0    2        速度kp
                                  写

                                  读/
0X2015   spd_ki          float         200   0    0.021    速度ki
                                  写

                                  读/
0X2016   loc_kp          float         200   0    30       位置kp
                                  写

                                  读/                       速度滤波
0X2017   spd_filt_gain   float         1     0    0.1
                                  写                        参数

                                  读/                       位置模式
0X2018   limit_spd       float         200   0    2
                                  写                        速度限制

                                                           位置、速
                                  读/
0X2019   limit_cur       float         23    0    23       度模式 电
                                  写
                                                           流限制

                                  只
0X3000   timeUse0        uint16                   5
                                  读

                                  只
0X3001   timeUse1        uint16                   0
                                  读

                                  只
0X3002   timeUse2        uint16                   10
                                  读

                                  只
0X3003   timeUse3        uint16                   0
                                  读

                                  只                        磁编码器
0X3004   encoderRaw      int16                    11396
                                  读                        采样值

                                                           mcu内部
                                  只
0X3005   mcuTemp         int16                    337      温度，
                                  读
                                                           *10

                                  只                        电机ntc温
0X3006   motorTemp       int16                    333
                                  读                        度，*10

                                  只
0X3007   vBus(mv)        uint16                   24195    母线电压
                                  读

                      参数类      属         最小   当前值（供参
功能码      名称                        最大值                   备注
                      型        性         值    考）

                                                         adc采样通
                               只
0X3008   adc1Offset   int32                   2084       道1 零电
                               读
                                                         流偏置

                                                         adc采样通
                               只
0X3009   adc2Offset   int32                   2084       道2 零电
                               读
                                                         流偏置

                               只                         adc采样值
0X300a   adc1Raw      uint16                  1232
                               读                         1

                               只                         adc采样值
0X300b   adc2Raw      uint16                  1212
                               读                         2

                               只
0X300c   VBUS         float                   36         母线电压V
                               读

                               只                         id环指
0X300d   cmdId        float                   0
                               读                         令，A

                               只                         iq环指
0X300e   cmdIq        float                   0
                               读                         令，A

                               只                         位置环指
0X300f   cmdlocref    float                   0
                               读                         令，rad

                               只                         速度环指
0X3010   cmdspdref    float                   0
                               读                         令，rad/s

                               只                         转矩指
0X3011   cmdTorque    float                   0
                               读                         令，nm

                               只                         mit协议角
0X3012   cmdPos       float                   0
                               读                         度指令

                               只                         mit协议速
0X3013   cmdVel       float                   0
                               读                         度指令

                               只
0X3014   rotation     int16                   1          圈数
                               读

                                                         电机未计
                               只
0X3015   modPos       float                   4.363409   圈机械角
                               读
                                                         度，rad

                                                         负载端计
                               只
0X3016   mechPos      float                   0.777679   圈机械角
                               读
                                                         度，rad

                               只                         负载端转
0X3017   mechVel      float                   0.036618
                               读                         速,rad/s

                               只
0X3018   elecPos      float                   4.714761   电气角度
                               读

                               只                         U线电
0X3019   ia           float                   0
                               读                         流，A

                      参数类      属         最小   当前值（供参
功能码      名称                        最大值                 备注
                      型        性         值    考）

                               只                       V线电流，
0X301a   ib           float                   0
                               读                       A

                               只                       W线电
0X301b   ic           float                   0
                               读                       流，A

                               只
0X301c   tick         uint32                  31600
                               读

                               只                       标定方向
0X301d   phaseOrder   uint8                   0
                               读                       标记

                               只                       iq滤波
0X301e   iqf          float                   0
                               读                       值，A

                               只                       板上温
0X301f   boardTemp    int16                   359
                               读                       度，*10

                               只
0X3020   iq           float                   0        iq原值，A
                               读

                               只
0X3021   id           float                   0        id原值，A
                               读

                               只                       故障状态
0X3022   faultSta     uint32                  0
                               读                       值

                               只                       警告状态
0X3023   warnSta      uint32                  0
                               读                       值

                               只                       驱动芯片
0X3024   drv_fault    uint16                  0
                               读                       故障值

                                                       驱动芯片
                               只
0X3025   drv_temp     int16                   48       温度值，
                               读
                                                       度

                               只
0X3026   Uq           float                   0        q轴电压
                               读

                               只
0X3027   Ud           float                   0        d轴电压
                               读

                               只                       U相输出
0X3028   dtc_u        float                   0
                               读                       占空比

                               只                       V相输出占
0X3029   dtc_v        float                   0
                               读                       空比

                               只                       W相输出
0X302a   dtc_w        float                   0
                               读                       占空比

                               只                       闭环中
0X302b   v_bus        float                   24.195
                               读                       vbus

                               只                       闭环vq,vd
0X302c   v_ref        float                   0
                               读                       合成电压

                                参数类       属                  最小      当前值（供参
  功能码       名称                                   最大值                           备注
                                型         性                  值       考）

                                          只                                    转矩反馈
  0X302d    torque_fdb          float                                0
                                          读                                    值，nm

                                          只                                    电机额定
  0X302e    rated_i             float                                8
                                          读                                    电流

                                          只                                    电机限制
  0X302f    limit_i             float                                27
                                          读                                    最大电流

示波器
    该界面支持观看观察实时数据所生成的图谱，可观测的数据包括电机Id/Iq电流、温度、输出端实时
转速、转子（编码器）位置、输出端位置等。

    点击分析模块中的示波器模块，信道内选定合适的参数（参数含义可参考参数表），设置输出频率
后点击开始绘图即可观测数据图谱，停止绘图即可停止观测图谱。

通信框指令说明
通信框指令示例：

41 54 90 07 e8 0c 08 05 70 00 00 01 00 00 00 0d 0a

含义如下

  41 54       90 07 e8 0c         08                 05 70 00 00 01 00 00 00   0d 0a

  帧头          扩展帧                 数据位个数              数据帧                       帧尾

其中扩展帧canid转译为真实canid需要经过以下转换：

90 07 e8 0c转换成二进制为1001 0000 0000 0111 1110 1000 0000 1100‬，去掉右边的100，则为1
0010 0000 0000 1111 1101 0000 0001‬，将其转换为16进制，为 12 00 FD 01‬，对照通信协议说明，含
义如下：

     12（16进制）             00       FD        01

     通信类型18（10进制）         无含义      主机id      电机canid

can通信故障保护
当CAN_TIMEOUT值为0时，该功能不启用

当CAN_TIMEOUT值为非0时，当电机在一定时间段内没收到can指令时，电机进入reset模式，20000为
1s

控制演示

jog运行

      设置最大速度，点击运行后，点击JOG运行即可让电机正反运行

控制模式切换

      在运动模式界面可以进行电机控制模式的转换

零点模式

  点击右侧开关按钮，电机会缓慢回到机械零位位置

运控模式

  点击右侧开关按钮，然后设置五个参数值，点击开始或连续发送，电机将返回反馈帧并按目标指令
运行；再次点击右侧开关按钮，电机将停机。

电流模式

  手动切换电流模式，点击右侧开关按钮，然后设置Iq电流指令值，开始或连续发送，电机将跟随电
流指令运行，再次点击右侧开关按钮，电机将停机。

  点击控制模式右侧开关按钮，输入正弦化自动测试的幅值和频率，然后点击正弦化自动测试右侧开
关按钮，电机的iq（A）会按设定的幅值和频率来运行。

速度模式

  手动切速度模式，点击右侧开关按钮，然后设置速度指令值，开始或连续发送，电机将跟随速度指
令运行，再次点击右侧开关按钮，电机将停机。

点击控制模式右侧开关按钮，输入正弦化自动测试的幅值和频率，然后点击正弦化自动测试右侧开关按
钮，电机的速度（rad/s）会按设定的幅值和频率来运行。

位置模式（CSP）

  手动切换位置模式（CSP），点击右侧开关按钮，然后设置位置指令值（rad），开始或连续发送，
电机将跟随目标位置指令运行，再次点击右侧开关按钮，电机将停机。可通过设置速度，修改位置跟随
的最大速度。

  点击控制模式右侧开关按钮，输入正弦化自动测试的幅值和频率，然后点击正弦化自动测试右侧开
关按钮，电机的位置（rad）会按设定的幅值和频率来运行。

位置模式（PP）

  手动切换位置模式（PP），点击右侧开关按钮，然后设置位置指令值（rad）、速度设置指令值
（rad/s）、加速度设置（rad/s^2))开始或连续发送，电机将跟随目标位置指令运行，再次点击右侧开关
按钮，电机将停机。可通过设置速度，修改位置跟随的最大速度及加速度。

固件更新

  第一步，点击设备模块的升级，选择待烧录bin文件；第二步，确认升级，电机开始更新固件，进度
完成后，电机更新完成，自动重启。

驱动器协议及使用说明
  电机通信为CAN 2.0通信接口，波特率1Mbps，采用扩展帧格式，如下所示：

 数据域     29位ID                            8Byte数据区

 大小      Bit28~bit24   bit23~8   bit7~0   Byte0~Byte7

 描述      通信类型          数据区2      目标地址     数据区1

  电机支持的控制模式包括：

  运控模式：给定电机运控5个参数；

  电流模式：给定电机指定的Iq 电流；

  速度模式：给定电机指定的运行速度；

  位置模式：给定电机指定的位置，电机将运行到该指定的位置；

通信协议类型说明
通信类型0：获取设备ID
获取设备的ID和64位MCU唯一标识符

 数据域       29位ID                                                               8Byte数据区

 大小        Bit28~bit24       bit23~8                        bit7~0             Byte0~Byte7

 描述        0                 bit15~8:用来标识主机CAN_ID           目标电机CAN_ID         0

应答帧：

 数据域           29位ID                                                 8Byte数据区

 大小            Bit28~bit24         bit23~8             bit7~0        Byte0~Byte7

 描述            0                   目标电机CAN_ID          0XFE          64位MCU唯一标识符

通信类型1：运控模式电机控制指令

 数
 据     29位ID                                                8Byte数据区
 域

 大
       Bit28~bit24       bit23~8             bit7~0         Byte0~Byte7
 小

                                                            Byte0~1: 目标角度[0~65535]对应
                                                            (-4π~4π) Byte2~3: 目标角速度
                         Byte2:力矩(0~65535)   目标电            [0~65535]对应(-44rad/s~44rad/s)
 描
       1                 对应                  机CAN           Byte4~5：Kp [0~65535]对应
 述
                         （-17Nm~17Nm）        _ID            (0.0~500.0) Byte6~7：Kd
                                                            [0~65535]对应(0.0~5.0) 以上数据转
                                                            换后高字节在前，低字节在后

通信类型2：电机反馈数据

 数
 据     29位ID                                                    8Byte数据区
 域

 大
       Bit28~bit24       bit23~8                   bit7~0       Byte0~Byte7
 小

 数
 据     29位ID                                                    8Byte数据区
 域

                             Bit8~Bit15:当前电机CAN
                             ID bit21~16:故障信息（0                 Byte0~1: 当前角度[0~65535]对
                             无 1有） bit21: 未标定                   应(-4π~4π) Byte2~3: 当前角速
                             bit20: HALL编码故障                    度[0~65535]对应
                                                       主机
 描                           bit19: 磁编码故障 bit18:                (-44rad/s~44rad/s) Byte4~5:当
       2                                               CAN
 述                           过温 bit17: 过流 bit16: 欠              前力矩[0~65535]对应
                                                       _ID
                             压故障 bit22~23:模式状                   （-17Nm~17Nm） Byte6~7:当
                             态 0 : Reset模式[复位] 1 :              前温度：Temp(摄氏度）*10 以
                             Cali 模式[标定] 2 : Motor              上数据高字节在前，低字节在后
                             模式[运行]

通信类型3：电机使能运行

 数据域           29位ID                                                            8Byte数据区

 大小            Bit28~bit24       bit23~8                     bit7~0             Byte0~Byte7

 描述            3                 bit15~8:用来标识主CAN_ID         目标电机CAN_ID

应答帧：应答电机反馈帧(见通信类型2)

通信类型4：电机停止运行

 数
 据         29位ID                                               8Byte数据区
 域

 大
           Bit28~bit24        bit23~8              bit7~0      Byte0~Byte7
 小

 描                            bit15~8:用来标识         目标电机        正常运行时，data区需清0；
           4
 述                            主CAN_ID              CAN_ID      Byte[0]=1时：清故障；

应答帧：应答电机反馈帧(见通信类型2)

通信类型6：设置电机机械零位

 数据域           29位ID                                                            8Byte数据区

 大小            Bit28~bit24       bit23~8                     bit7~0             Byte0~Byte7

 描述            6                 bit15~8:用来标识主CAN_ID         目标电机CAN_ID         Byte[0]=1

应答帧：应答电机反馈帧(见通信类型2)

通信类型7：设置电机CAN_ID
更改当前电机CAN_ID , 立即生效。

 数据
        29位ID                                                            8Byte数据区
 域

 大小     Bit28~bit24    bit23~8                            bit7~0         Byte0~Byte7

                       bit15~8:用来标识主CAN_ID                目标电机
 描述     7
                       Bit16~23: 预设置CAN_ID                CAN_ID

应答帧：应答电机广播帧(见通信类型0)

通信类型17：单个参数读取

 数
 据     29位ID                                              8Byte数据区
 域

 大
       Bit28~bit24    bit23~8                 bit7~0      Byte0~Byte7
 小

                                                          Byte0~1: index，参数列表详
                      bit15~8:用来标识主
 描                                            目标电机        见4.1.11 Byte2~3: 00
       17             CAN_ID Bit23~16:00为
 述                                            CAN_ID      Byte4~7: 00 以上数据低字节在
                      读取成功01为读取失败
                                                          前，高字节在后

应答帧：

 数
 据     29位ID                                    8Byte数据区
 域

 大
       Bit28~bit24    bit23~8       bit7~0      Byte0~Byte7
 小

                                                Byte0~1: index，参数列表详见4.1.11
                      bit15~8:目
 描                                  主机          Byte2~3: 00 Byte4~7: 参数数据，1字节数
       17             标电机
 述                                  CAN_ID      据在Byte4 以上数据低字节在前，高字节
                      CAN_ID
                                                在后

通信类型18：单个参数写入（掉电丢失）

 数
 据     29位ID                                       8Byte数据区
 域

 大
       Bit28~bit24    bit23~8        bit7~0        Byte0~Byte7
 小

 数
 据    29位ID                                              8Byte数据区
 域

                     bit15~8:用来                          Byte0~1: index，参数列表详见4.1.11
 描                                    目标电机
      18             标识主                                 Byte2~3: 00 Byte4~7: 参数数据 以上数
 述                                    CAN_ID
                     CAN_ID                              据低字节在前，高字节在后

通信类型21：故障反馈帧

 数
 据    29位ID                                         8Byte数据区
 域

 大
      Bit28~bit24    bit23~8      bit7~0            Byte0~Byte7
 小

                                                    Byte0~3: fault值(非0:有故障，0：正常）
                                                    bit16:A相电流采样过流 bit15~bit8:过载故障
                     bit15~8:     用来标识              bit7:编码器未标定 bit5:C相电流采样过流
 描
      21             电机           主                 bit4:B相电流采样过流 bit3:过压故障 bit2:欠
 述
                     CAN_ID       CAN_ID            压故障 bit1:驱动芯片故障 bit0:电机过温故
                                                    障，默认80度 Byte4~7: warning值 bit0：电
                                                    机过温预警，默认75度

通信类型22：电机波特率修改帧

 数据
       29位ID                                                      8Byte数据区
 域

 大小    Bit28~bit24    bit23~8                 bit7~0              Byte0~Byte7

                      bit15~8:用来标识            目标电机                Byte0：01为1M 02为500K 03
 描述    22
                      主CAN_ID                 CAN_ID              为250K 04为100K

应答帧：应答电机反馈帧(见通信类型0)

通信类型23：电机主动上报帧

 数
 据     29位ID                                               8Byte数据区
 域

 大
       Bit28~bit24    bit23~8              bit7~0          Byte0~Byte7
 小

                                                           Byte0：00 为关闭主动上报（默认）
 描                    bit15~8:用来标          目标电机
       23                                                  01 为开启主动上报默认上报间隔为
 述                    识主CAN_ID             CAN_ID
                                                           10ms

应答帧：应答电机反馈帧(见通信类型2)

通信类型24：电机数据保存帧

 数据域      29位ID                                                         8Byte数据区

 大小       Bit28~bit24      bit23~8                   bit7~0             Byte0~Byte7

 描述       24               bit15~8:用来标识主CAN_ID       目标电机CAN_ID

应答帧：应答电机反馈帧(见通信类型2)

可读写单个参数列表

                                                         字                    R/W
 参数
           参数名称             描述               类型          节    单位/说明           读写
 index
                                                         数                    权限

                            0: 运控模式 1: 位置
                            模式 （PP）2: 速度
 0X7005    run_mode         模式 3: 电流模式       uint8       1                    W/R
                            5：位置模式
                            （CSP）

 0X7006    iq_ref           电流模式Iq指令         float       4    -23~23A         W/R

 0X700A    spd_ref          转速模式转速指令         float       4    -44~44rad/s     W/R

 0X700B    limit_torque     转矩限制             float       4    0~17Nm          W/R

 0X7010    cur_kp           电流的Kp            float       4    默认值0.17         W/R

 0X7011    cur_ki           电流的Ki            float       4    默认值0.012        W/R

                            电流滤波系数                            0~1.0，默认
 0X7014    cur_filt_gain                     float       4                    W/R
                            filt_gain                         值0.1

 0X7016    loc_ref          位置模式角度指令         float       4    rad             W/R

 0X7017    limit_spd        位置模式速度限制         float       4    0~44rad/s       W/R

                            速度位置模式电流
 0X7018    limit_cur                         float       4    0~23A           W/R
                            限制

                            负载端计圈机械角
 0x7019    mechPos                           float       4    rad             R
                            度

 0x701A    iqf              iq滤波值            float       4    -23~23A         R

 0x701B    mechVel          负载端转速            float       4    -44~44rad/s     R

 0x701C    VBUS             母线电压             float       4    V               R

 0x701E    loc_kp           位置的kp            float       4    默认值40           W/R

 0x701F    spd_kp           速度的kp            float       4    默认值6            W/R

 0x7020    spd_ki           速度的ki            float       4    默认值0.02         W/R

                                                                        字                      R/W
 参数
               参数名称                 描述                      类型          节      单位/说明           读写
 index
                                                                        数                      权限

                                    主动上报间隔默认
                                    为0（10ms），每
 0x7024        EPScan_time                                  Uint16      2      默认值0            W
                                    加1增加5ms间隔时
                                    长

                                                                               默认值
 0x7025        vel_max              位置模式最大速度                float       4                      W
                                                                               10rad/s

                                                                               默认值
 0x7026        acc_set              位置模式加速度                 float       4                      W
                                                                               10rad/s^2

 0x7027        spd_filt_gain        速度滤波值                   float       4      默认值0.1          W

                                    can超时阈值，
 0x7028        cantimeout                                   Uint32      4      默认值0            W
                                    20000代表1s

读取示例：

以读取loc_kp为例：

读取指令为

 大
          Bit28~bit24                   bit23~8        bit7~0               Byte0~Byte7
 小

          11                            00FD           7F                   1E 70 00 00 00 00 00 00

 描        类型17 十六进制                     主机id           目标电机CAN_ID           Byte0~1: index，对应
 述        0x11                          0xFD           7F                   loc_kp

反馈指令为

 大
         Bit28~bit24           bit23~8            bit7~0        Byte0~Byte7
 小

         11                    007F               FD            1E 70 00 00 00 00 F0 41

                                                                Byte0~1: index，对应loc_kp
                               bit15~8:目标
 描       类型17 十六进                                 主机id          Byte4~7:loc_kp值为30，右高字节，
                               电机CAN_ID
 述       制0x11                                    0xFD          （32位单精度）16进制IEEE-754标准浮
                               7F
                                                                点数

控制模式使用说明
程序样例
以下提供各种模式控制电机实例（以gd32f303为例）

下面为各种实例调用库，函数与宏定义

 #define P_MIN -12.5f

 #define P_MAX 12.5f

 #define V_MIN 44.0f

 #define V_MAX 44.0f

 #define KP_MIN 0.0f

 #define KP_MAX 500.0f

 #define KD_MIN 0.0f

 #define KD_MAX 5.0f

 #define T_MIN -17.0f

 #define T_MAX 17.0f

 struct exCanIdInfo{

      uint32_t id:8;

      uint32_t data:16;

      uint32_t mode:5;

      uint32_t res:3;

 };

 can_receive_message_struct rxMsg;

 can_trasnmit_message_struct txMsg={

      .tx_sfid = 0,

      .tx_efid = 0xff,

      .tx_ft = CAN_FT_DATA,

      .tx_ff = CAN_FF_EXTENDED,

      .tx_dlen = 8,

 };

#define txCanIdEx (((struct exCanIdInfo)&(txMsg.tx_efid)))

#define rxCanIdEx (((struct exCanIdInfo)&(rxMsg.rx_efid))) //将扩展帧id解析为自定义数
据结构

int float_to_uint(float x, float x_min, float x_max, int bits){

    float span = x_max - x_min;

    float offset = x_min;

    if(x > x_max) x=x_max;

    else if(x < x_min) x= x_min;

    return (int) ((x-offset)*((float)((1<<bits)-1))/span);

}

#define can_txd() can_message_transmit(CAN0, &txMsg)

#define can_rxd() can_message_receive(CAN0, CAN_FIFO1, &rxMsg)

下面列举常见的通信类型发送：

电机使能运行帧（通信类型3）

void motor_enable(uint8_t id, uint16_t master_id)
{
    txCanIdEx.mode = 3;
    txCanIdEx.id = id;
    txCanIdEx.res = 0;
    txCanIdEx.data = master_id;
    txMsg.tx_dlen = 8;
    txCanIdEx.data = 0;
    can_txd();
}

运控模式电机控制指令（通信类型1）

void motor_controlmode(uint8_t id, float torque, float MechPosition, float speed,
float kp, float kd)

{

    txCanIdEx.mode = 1;

    txCanIdEx.id = id;

    txCanIdEx.res = 0;

    txCanIdEx.data = float_to_uint(torque,T_MIN,T_MAX,16);

    txMsg.tx_dlen = 8;

    txMsg.tx_data[0]=float_to_uint(MechPosition,P_MIN,P_MAX,16)>>8;

    txMsg.tx_data[1]=float_to_uint(MechPosition,P_MIN,P_MAX,16);

    txMsg.tx_data[2]=float_to_uint(speed,V_MIN,V_MAX,16)>>8;

    txMsg.tx_data[3]=float_to_uint(speed,V_MIN,V_MAX,16);

    txMsg.tx_data[4]=float_to_uint(kp,KP_MIN,KP_MAX,16)>>8;

    txMsg.tx_data[5]=float_to_uint(kp,KP_MIN,KP_MAX,16);

    txMsg.tx_data[6]=float_to_uint(kd,KD_MIN,KD_MAX,16)>>8;

    txMsg.tx_data[7]=float_to_uint(kd,KD_MIN,KD_MAX,16);

    can_txd();

}

电机停止运行帧（通信类型4）

void motor_reset(uint8_t id, uint16_t master_id)

{

    txCanIdEx.mode = 4;

    txCanIdEx.id = id;

    txCanIdEx.res = 0;

    txCanIdEx.data = master_id;

    txMsg.tx_dlen = 8;

    for(uint8_t i=0;i<8;i++)

    {

        txMsg.tx_data[i]=0;

    }

    can_txd();

}

电机模式参数写入命令（通信类型18，运行模式切换）

uint8_t runmode;

uint16_t index;

void motor_modechange(uint8_t id, uint16_t master_id)

{

    txCanIdEx.mode = 0x12;

    txCanIdEx.id = id;

    txCanIdEx.res = 0;

    txCanIdEx.data = master_id;

    txMsg.tx_dlen = 8;

    for(uint8_t i=0;i<8;i++)

    {

        txMsg.tx_data[i]=0;

    }

    memcpy(&txMsg.tx_data[0],&index,2);

    memcpy(&txMsg.tx_data[4],&runmode, 1);

    can_txd();

}

电机模式参数写入命令（通信类型18，控制参数写入）

uint16_t index;

float ref;

void motor_write(uint8_t id, uint16_t master_id)

{

    txCanIdEx.mode = 0x12;

    txCanIdEx.id = id;

    txCanIdEx.res = 0;

    txCanIdEx.data = master_id;

      txMsg.tx_dlen = 8;

      for(uint8_t i=0;i<8;i++)

      {

          txMsg.tx_data[i]=0;

      }

      memcpy(&txMsg.tx_data[0],&index,2);

      memcpy(&txMsg.tx_data[4],&ref,4);

      can_txd();

 }

运控模式

电机上电后默认处于运控模式；

     发送电机使能运行帧（通信类型3）-->发送运控模式电机控制指令（通信类型1）-->收到电机反馈帧
（通信类型2）

电流模式
     发送电机模式参数写入命令（通信类型18）设置runmode参数为3 ---> 发送电机使能运行帧（通信
类型3）--> 发送电机模式参数写入命令（通信类型18）设置 iq_ref参数为预设电流指令

速度模式

  发送电机模式参数写入命令（通信类型18）设置runmode参数为2 ---> 发送电机使能运行帧（通信
类型3）--> 发送电机模式参数写入命令（通信类型18）设置 limit_cur参数为预设最大电流指令-->发送电
机模式参数写入命令（通信类型18）设置 spd_ref参数为预设速度指令

位置模式 （CSP）

  发送电机模式参数写入命令（通信类型18）设置runmode参数为5 --> 发送电机使能运行帧（通信
类型3）--> 发送电机模式参数写入命令（通信类型18）设置 limit_spd参数为预设最大速度指令-->发送
电机模式参数写入命令（通信类型18）设置 loc_ref参数为预设位置指令

位置模式 （PP）

  发送电机模式参数写入命令（通信类型18）设置runmode参数为1 --> 发送电机使能运行帧（通信
类型3）--> 发送电机模式参数写入命令（通信类型18）设置 vel_max参数为预设最大速度指令-->发送电
机模式参数写入命令（通信类型18）设置 acc_set参数为预设加速度指令-->发送电机模式参数写入命令
（通信类型18）设置 loc_ref参数为预设位置指令

注：该模式不支持运行过程中改速度和加速度，如想急停可以在过程中将vel_max修改为0，会以当前速
度和加速度规划停止

停止运行
发送电机停止运行帧（通信类型4）
