pedapudi/oddstride/tinfox/proposals/sculpted/model/fusion_native/exports/dfma-architecture-v1/dfma-thigh-assembled.png

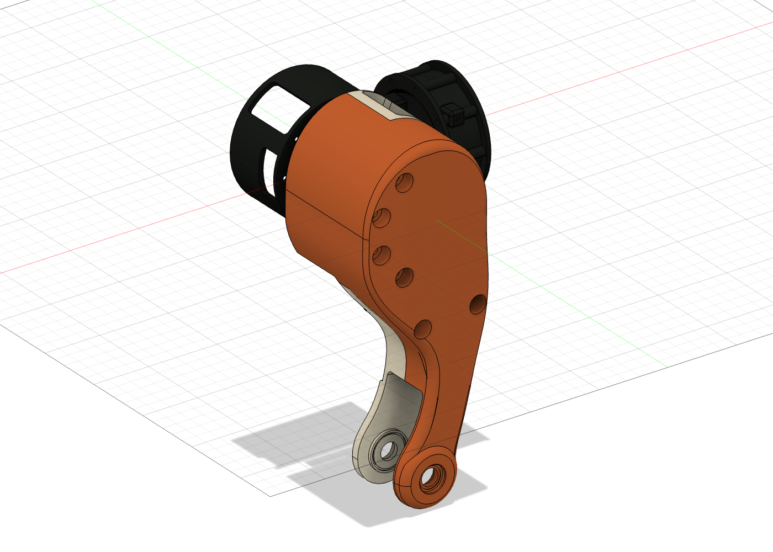
tinfox/proposals/sculpted/model/fusion_native/exports/dfma-architecture-v1/dfma-thigh-assembled.png
