pedapudi/oddstride/tinfox/proposals/sculpted/model/output/assembly-stage-1.png

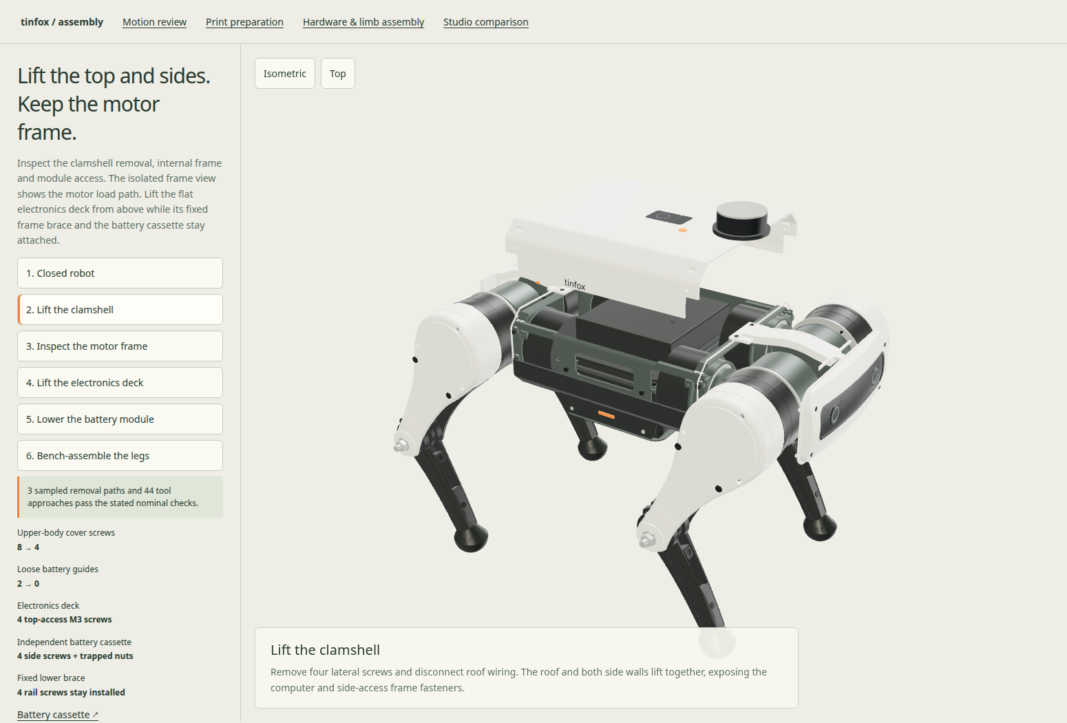
tinfox/proposals/sculpted/model/output/assembly-stage-1.png
