pedapudi/oddstride/tinfox/proposals/sculpted/model/output/fascia-print-orientation.png

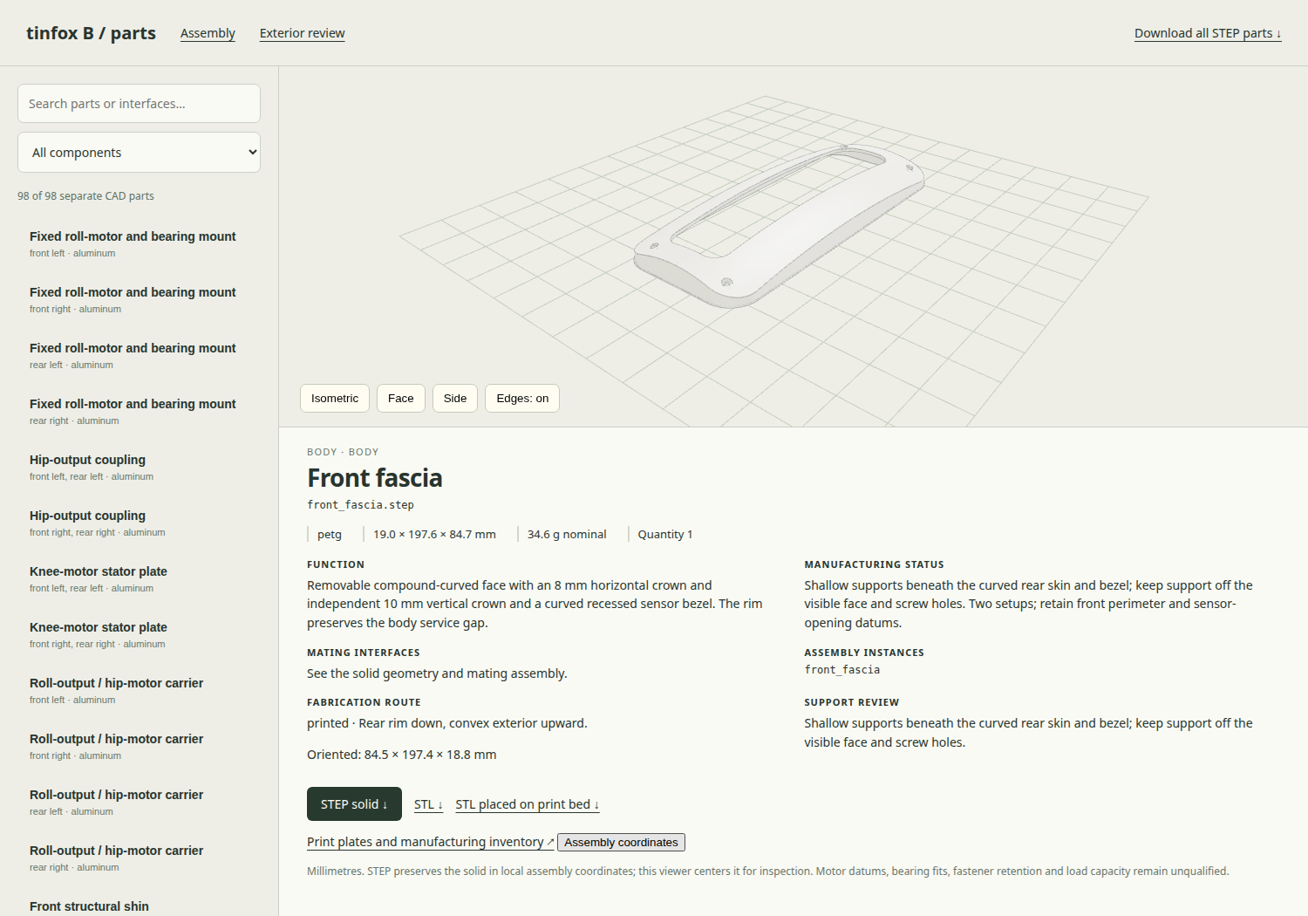
tinfox/proposals/sculpted/model/output/fascia-print-orientation.png
