pedapudi/oddstride/tinfox/proposals/sculpted/model/output/knee_head-print-preview.png

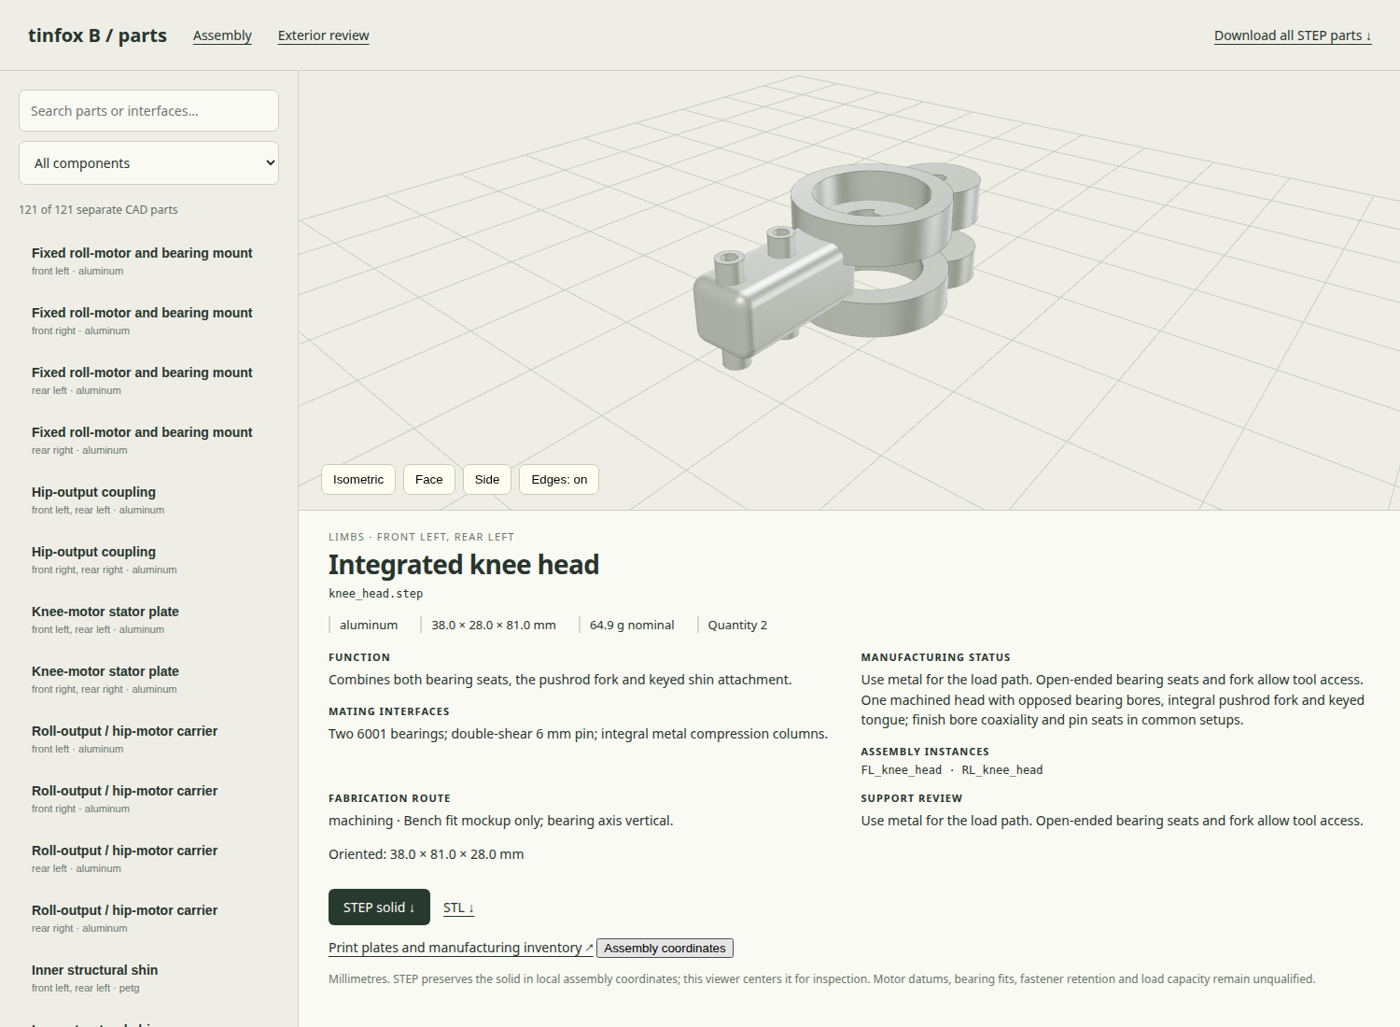
tinfox/proposals/sculpted/model/output/knee_head-print-preview.png
