pedapudi/oddstride/tinfox/proposals/sculpted/model/output/limb-variants/cnc/assembly-preview.png

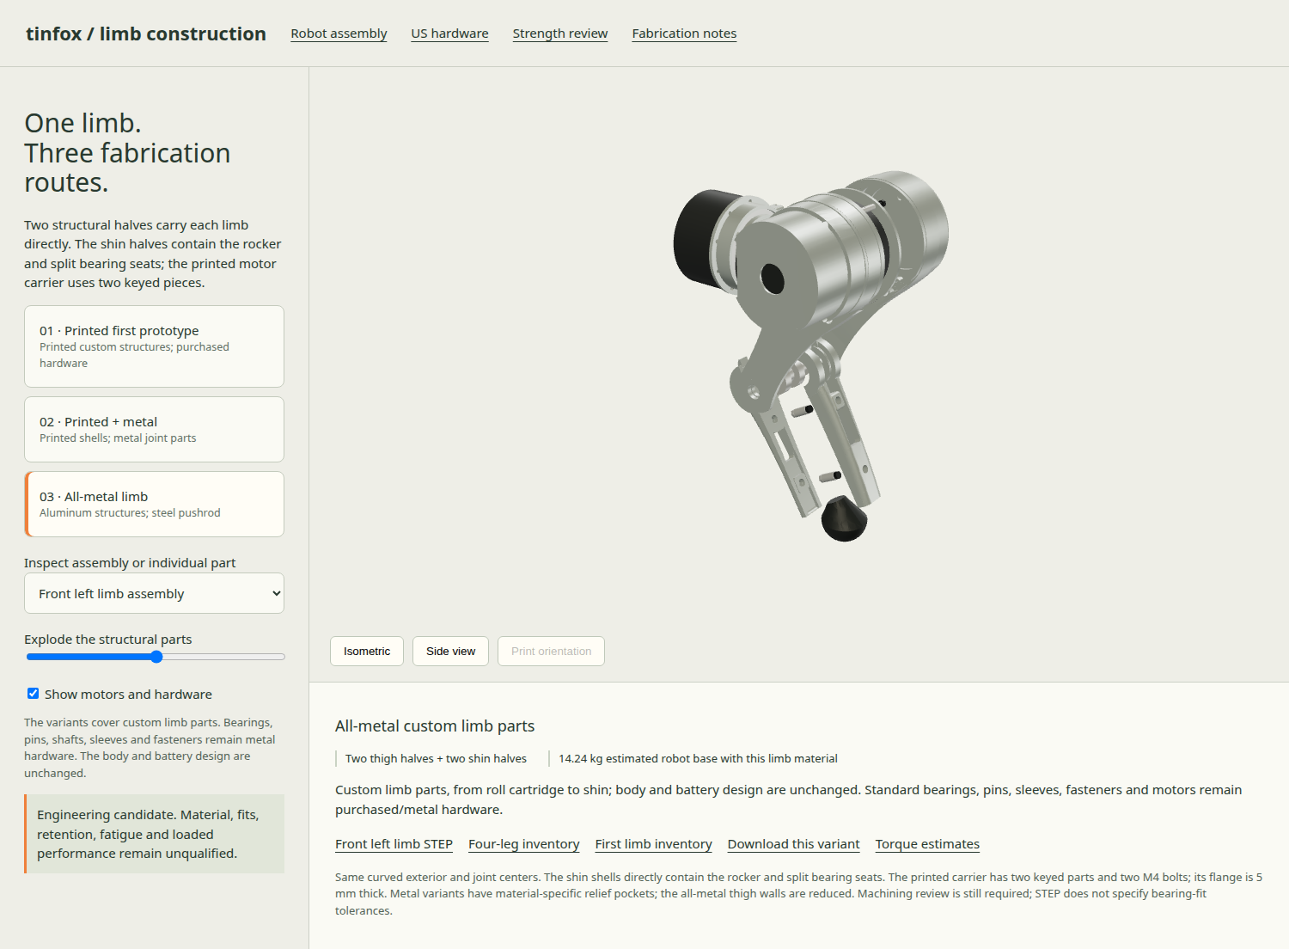
tinfox/proposals/sculpted/model/output/limb-variants/cnc/assembly-preview.png
