pedapudi/oddstride/tinfox/proposals/sculpted/model/output/manufacturing-preview.png

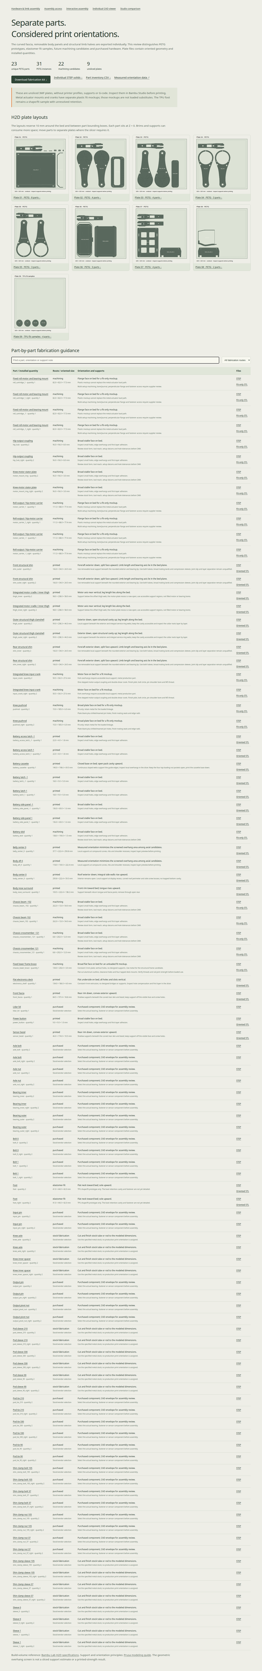
tinfox/proposals/sculpted/model/output/manufacturing-preview.png
