pedapudi/oddstride/tinfox/proposals/sculpted/model/output/motor_carrier_1-print-preview.png

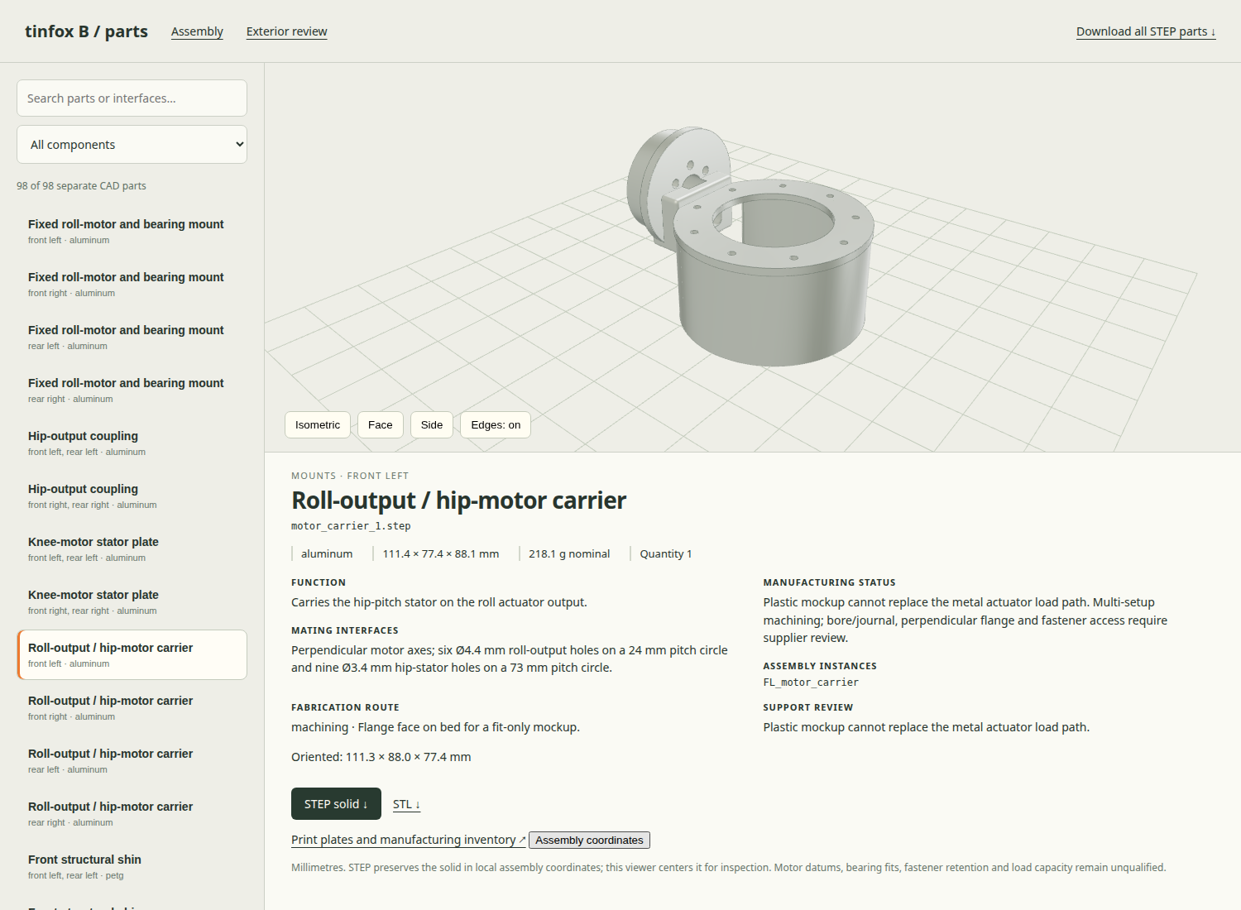
tinfox/proposals/sculpted/model/output/motor_carrier_1-print-preview.png
