pedapudi/oddstride/tinfox/proposals/sculpted/model/output/print-handoff/Tinfox-FL-fit-b968fea9-20261029T040522Z/assembled-limb-reference.png

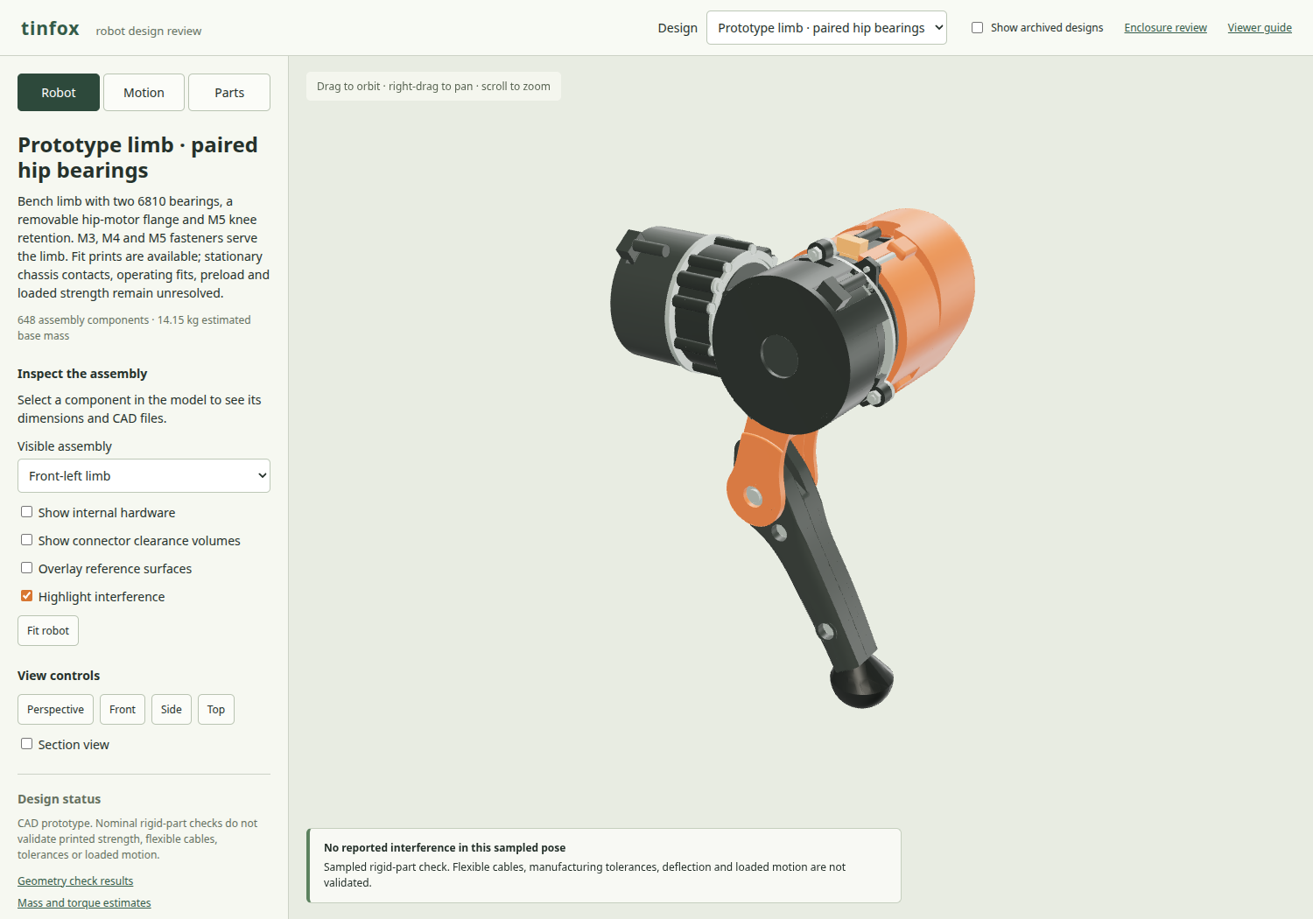
tinfox/proposals/sculpted/model/output/print-handoff/Tinfox-FL-fit-b968fea9-20261029T040522Z/assembled-limb-reference.png
