pedapudi/oddstride/tinfox/proposals/sculpted/model/output/print-handoff/Tinfox-Motor-Complex-20261029T045513Z/three-motors-reference.png

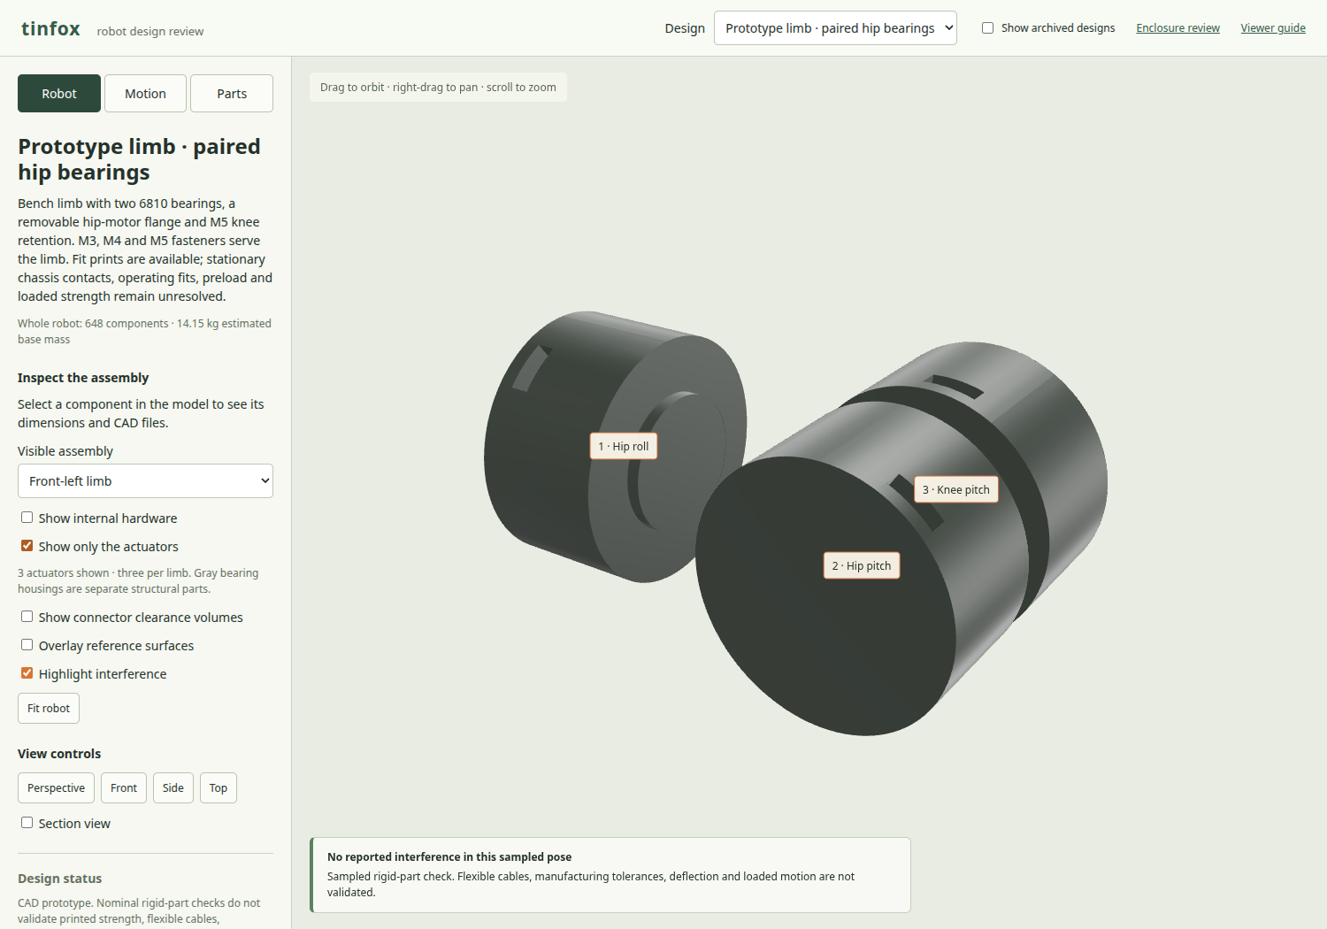
tinfox/proposals/sculpted/model/output/print-handoff/Tinfox-Motor-Complex-20261029T045513Z/three-motors-reference.png
