pedapudi/oddstride/tinfox/proposals/sculpted/model/output/print-strength-preview.png

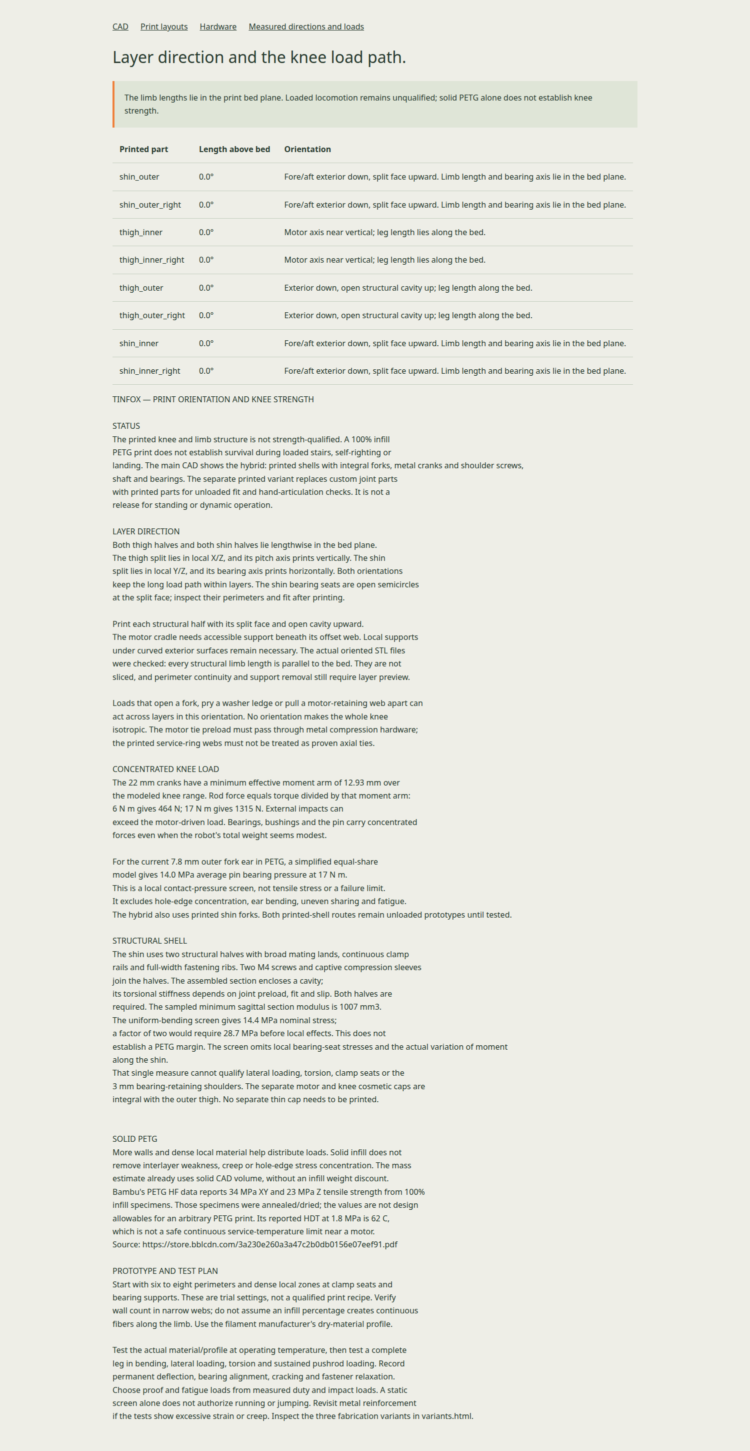
tinfox/proposals/sculpted/model/output/print-strength-preview.png
