pedapudi/oddstride/tinfox/proposals/sculpted/model/output/shin_inner-print-preview.png

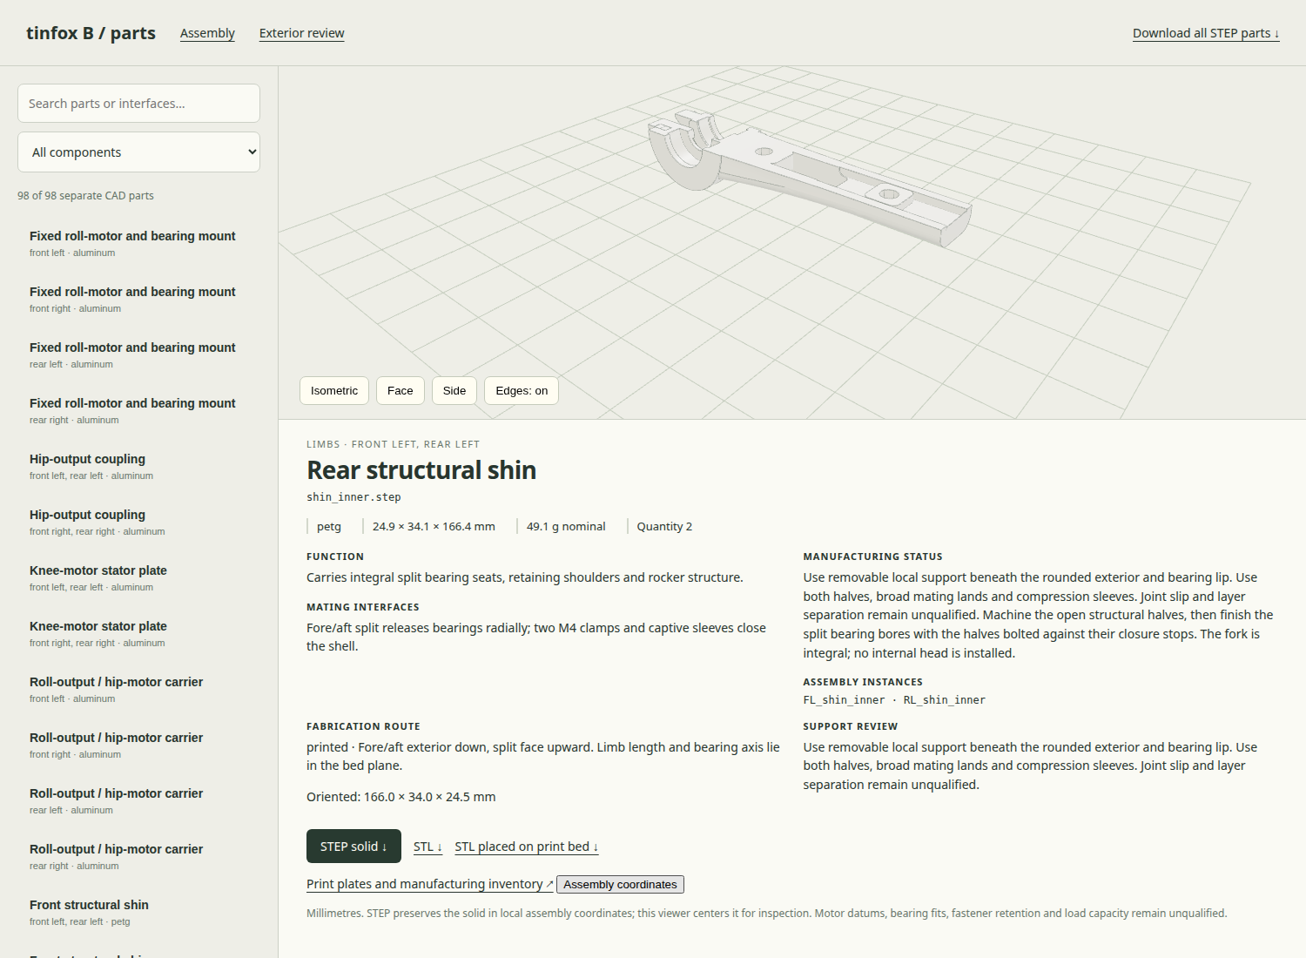
tinfox/proposals/sculpted/model/output/shin_inner-print-preview.png
