pedapudi/oddstride/tinfox/proposals/sculpted/model/output/shin_shell-print-preview.png

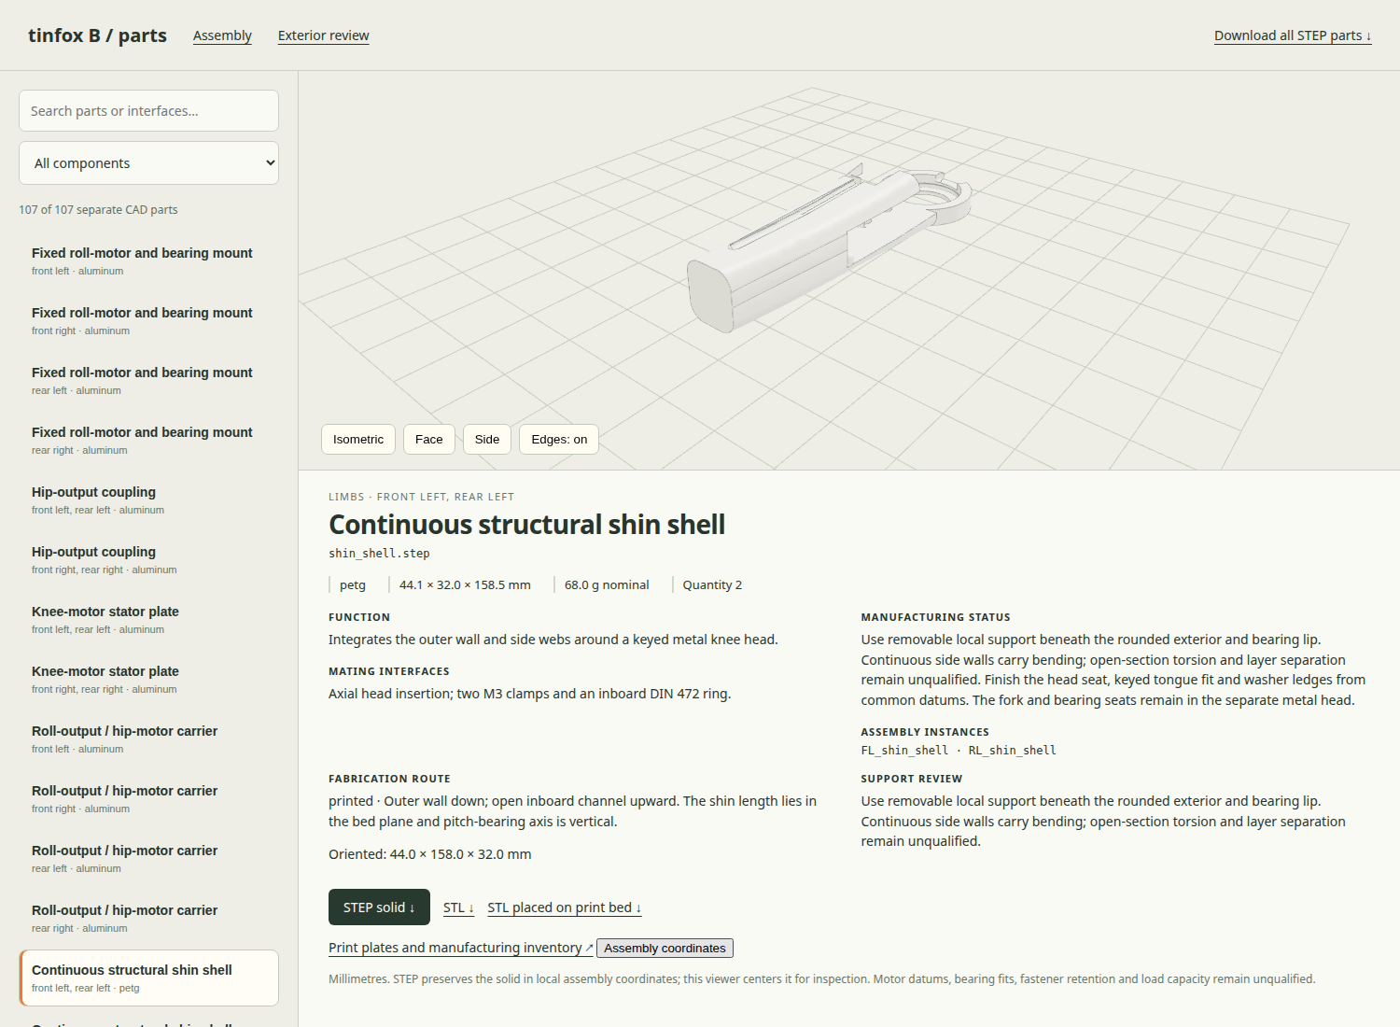
tinfox/proposals/sculpted/model/output/shin_shell-print-preview.png
