pedapudi/oddstride/tinfox/proposals/sculpted/model/output/thigh_outer-print-preview.png

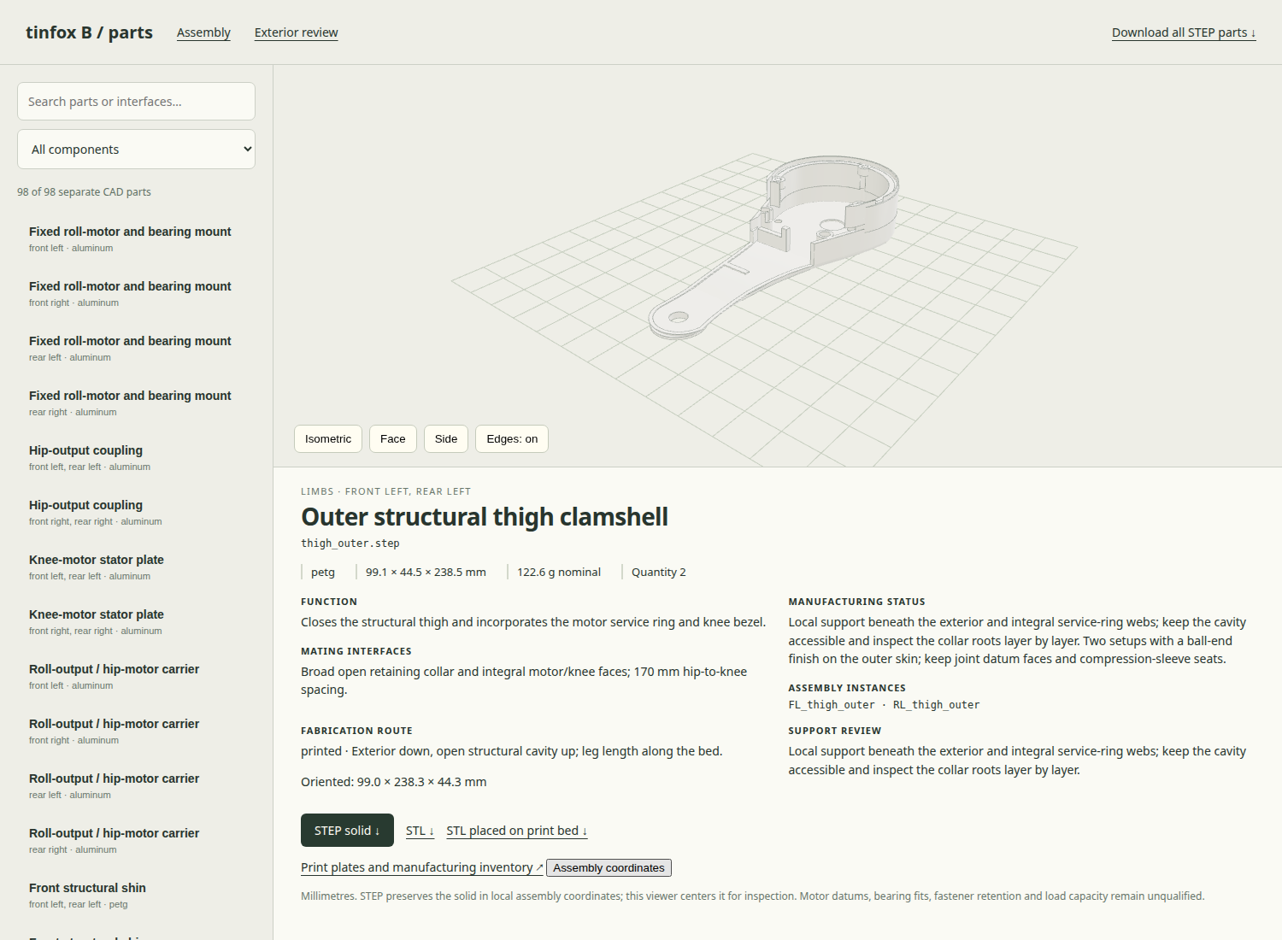
tinfox/proposals/sculpted/model/output/thigh_outer-print-preview.png
