pedapudi/oddstride/tinfox/proposals/sculpted/model/fusion_native/source/promote_motor_complex.py

"""Promote only the checked saved motor-complex scope; preserve full-robot reference authority."""
import json,hashlib,gzip,datetime
from pathlib import Path
ROOT=Path(__file__).resolve().parents[1]
def read(name):return json.loads((ROOT/name).read_text())
def sha(path):return hashlib.sha256(path.read_bytes()).hexdigest()
def evidence(name):
 p=ROOT/name;assert p.is_file();return {'path':name,'sha256':sha(p)}
manifest=read('manifests/motor-complex-native-candidate.json');candidate_hash=sha(ROOT/'manifests/motor-complex-native-candidate.json');saved=read('audits/motor-complex-saved-reopen.json');assert saved['passed'] and saved['reopened'] and saved['complete'] and not saved['modified'];version=saved['version'];assert saved['snapshot']['visible_root']==['BENCH_MOTOR_COMPLEX'];assert len(saved['snapshot']['placement'])==13
family=read('audits/motor-complex-family-edits.json');assert family['passed'] and len(family['tests'])==6
interfaces=read('audits/motor-complex-native-critical-interfaces.json');assert interfaces['passed'] and len(interfaces['checks'])==28 and len(interfaces['references'])==103
exports=read('audits/motor-complex-native-export-validation.json');assert exports['overall_passed'] and exports['candidate_manifest']['sha256']==candidate_hash
browser=read('audits/motor-complex-browser-candidate.json');assert not browser['browser_errors'] and not browser['missing_assets']
assert read('audits/motor-complex-browser-placements.json')['passed'];assembly=read('audits/native-motor-complex-assembly/release-report.json');assert assembly['overall_passed'];target=read('manifests/motor-complex-native-target.json');comparisons=[]
for key,row in manifest['parts'].items():
 step=ROOT/row['native_step'];assert sha(step)==row['native_step_sha256'];assert sha(ROOT/row['native_3mf'])==row['native_3mf_sha256'];assert sha(ROOT/target['parts'][key]['source_step'])==target['parts'][key]['sha256'];comparison=read('audits/motor-complex-'+key+'-comparison.json');assert comparison['native_sha256']==sha(step) and comparison['source_sha256']==target['parts'][key]['sha256']
 if key=='thigh_outer':
  proof=read('audits/motor-complex-thigh-qualified-geometry.json');assert proof['passed'] and proof['native_step_sha256']==sha(step);reports=['audits/motor-complex-thigh-qualified-geometry.json']+proof['evidence']
 elif key=='thigh_inner':
  assert comparison['geometry_passed'];proof=read('audits/slim-thigh-temporary-native-section-comparison.json');assert all(s['passed']for s in proof['sections']if s['part']==key);live=next(x for x in read('audits/slim-thigh-live-surface-comparison.json')['parts']if x['part']==key);assert live['source_sha256']==target['parts'][key]['sha256'] and live['source_to_native_max_mm']<.03 and live['native_to_source_max_mm']<.03;reports=['audits/motor-complex-thigh_inner-comparison.json','audits/slim-thigh-temporary-native-section-comparison.json','audits/slim-thigh-live-surface-comparison.json']
 else:
  assert comparison['geometry_passed'] and comparison['sections_passed'];reports=['audits/motor-complex-'+key+'-comparison.json']
 current=saved['snapshot']['parts'][key];assert current['features']==row['native_feature_count'] and current['sketches']==row['native_sketch_count'];assert max(abs(a-b)for a,b in zip(current['bounds_mm'],row['native_bounds_mm']))<.000001;volume_delta=abs(current['volume_mm3']-row['native_volume_mm3'])
 if volume_delta>=.002:
  resolution=read('audits/motor-complex-span-restore-independent.json');assert key=='motor_carrier_1' and resolution['independent_restored_geometry_passed'] and resolution['independent_span_volume_restore_gate']['passed'] and resolution['before']['sha256']==row['native_step_sha256'];assert abs(current['volume_mm3']-read('audits/motor-complex-post-restore-solid.json')['volume_mm3'])<.002;row['physical_property_numerical_adjudication']={'native_property_delta_mm3':volume_delta,'evidence':evidence('audits/motor-complex-span-restore-independent.json')}
 expected=[1.,0,0,row['assembly_translation_mm'][0]/10,0,1.,0,0,0,0,1.,0,0,0,0,1.];assert all(abs(a-b)<1e-8 for a,b in zip(expected,saved['snapshot']['placement'][key]))
 row.update(saved_version=version,export_checkpoint_version=19,state='canonical_native',saved_native_fingerprint=current,geometry_comparison_evidence=[evidence(p)for p in reports]);comparisons.append({'part':key,'passed':True,'reports':reports})
raw=gzip.decompress((ROOT/manifest['review_model']).read_bytes());assert hashlib.sha256(raw).hexdigest()==manifest['review_model_sha256'];model=json.loads(raw);original_geometry_hash=hashlib.sha256(json.dumps({'parts':model['parts'],'meshes':model['meshes']},sort_keys=True,separators=(',',':')).encode()).hexdigest();model['native_migration'].update(authority='Canonical native Fusion geometry for the detached 13-part motor complex',native_source_of_truth=True,saved_version=version,working_modified=False,export_checkpoint_version=19,saved_reopen_evidence='audits/motor-complex-saved-reopen.json',full_robot_authority='Generated migration reference; not promoted');out=ROOT/'exports/motor-complex-native/native-bench-review-canonical.json.gz';final_raw=json.dumps(model,separators=(',',':')).encode();out.write_bytes(gzip.compress(final_raw,mtime=0));assert hashlib.sha256(json.dumps({'parts':model['parts'],'meshes':model['meshes']},sort_keys=True,separators=(',',':')).encode()).hexdigest()==original_geometry_hash
for row in manifest['stock_references']:
 assert sha(ROOT/row['native_3mf'])==row['native_3mf_sha256'];row.update(saved_version=version,export_checkpoint_version=19)
report_names=['audits/motor-complex-span-restore-independent.json','audits/motor-complex-saved-reopen.json','audits/motor-complex-family-edits.json','audits/motor-complex-native-critical-interfaces.json','audits/motor-complex-native-export-validation.json','audits/motor-complex-browser-candidate.json','audits/motor-complex-browser-placements.json','audits/native-motor-complex-assembly/release-report.json','audits/motor-complex-effective-visibility.json','audits/motor-complex-final-checkpoint.json','audits/retired-leg-solver-cleanup.json','audits/loaded-document-contexts.json']
now=datetime.datetime.now(datetime.UTC).isoformat();manifest.update(native_source_of_truth=True,authority='Native Fusion is canonical for these 13 custom parts and this static detached motor-complex assembly only.',global_migration_status='partial',source_target_retained_as_reference=True,full_robot_authority='Generated current robot remains a migration reference until its native assembly is updated and audited.',latest_leg_checkpoint=version,review_model=str(out.relative_to(ROOT)),review_model_sha256=hashlib.sha256(final_raw).hexdigest(),review_model_gzip_sha256=sha(out),review_geometry_sha256=original_geometry_hash,private_candidate_manifest_sha256=candidate_hash,private_candidate_model_sha256=hashlib.sha256(raw).hexdigest(),promotion_evidence=[evidence(p)for p in report_names],native_file_id=saved['file_id'],updated_utc=now,candidate_exports_are_not_manufacturing_release=False,manufacturing_scope='Supported unpowered fit/assembly prototype; physical fit, polymer strength, load-bearing material substitutions and powered operation remain unqualified.',limitations=['Static bench: no joint preview or automatic hardware repositioning after family edits is claimed.','Fifteen postclosure tool routes are intentionally unavailable; follow the checked staged assembly/service order.','Purchased references are independently hideable envelopes; verify actual hardware dimensions.','No full-robot, loaded-strength, continuous-motion, or 20 kg payload qualification.'])
(ROOT/'manifests/motor-complex-native-exports.json').write_text(json.dumps(manifest,indent=2)+'\n');status={'status':'partial','canonical_scopes':{'motor_complex':{'manifest':'manifests/motor-complex-native-exports.json','manifest_sha256':sha(ROOT/'manifests/motor-complex-native-exports.json'),'saved_leg_version':version,'custom_parts':list(manifest['parts']),'motion_available':False}},'full_robot_native_source_of_truth':False,'full_robot_reference':'Current generated robot; use explicitly scoped native motor-complex exports for these parts.','updated_utc':now};(ROOT/'manifests/source-authority.json').write_text(json.dumps(status,indent=2)+'\n')
subs=read('manifests/subsystems.json');subs['subsystems']['leg'].update(version=version,save_verified=True,verification_report='audits/motor-complex-saved-reopen.json',canonical_scope='13-part static motor complex only');(ROOT/'manifests/subsystems.json').write_text(json.dumps(subs,indent=2)+'\n')
master=read('manifests/native-master-status.json');master['partial_native_scope']='manifests/motor-complex-native-exports.json';master['open_gates']=['Replace the installed older limb definitions/references with the current saved native families, including handed paired-bearing variants and explicit motor-complex access corrections.','Audit current whole-robot native placements, critical interfaces, linkage, motion and service paths against the frozen target; report inherited design limitations separately.','Save/reopen the current full assembly and generate its review/manufacturing exports from a verified native allowlist.'];master['physical_qualification_remaining']=['CNC process/tool access qualification where unreviewed, manufacturing fits, structural strength, continuous motion and loaded performance; these are separate from CAD-authority scope.'];master['updated_utc']=now;(ROOT/'manifests/native-master-status.json').write_text(json.dumps(master,indent=2)+'\n');print(json.dumps({'promoted_scope':'motor_complex','custom_parts':13,'saved_leg_version':version,'manifest':'manifests/motor-complex-native-exports.json','review_model':manifest['review_model'],'full_robot_promoted':False},indent=2))
