pedapudi/oddstride/tinfox/proposals/sculpted/model/fusion_native/source/export_motor_complex_native.py

"""Export direct Fusion surfaces in canonical part coordinates and the visible bench scene."""
import json
from pathlib import Path
from run_native import rpc
from fetch_exports import fetch
from motor_complex_exports import COMPONENTS
ROOT=Path(__file__).resolve().parents[1]
s=(ROOT/'source/native_documents.py').read_text()+'''\nimport adsk.core as core,adsk.fusion as fusion,json,os,tempfile,gzip,hashlib,time,re

def run(_context:str):
 app=core.Application.get();doc=authoring_document(app,'leg');assert doc==app.activeDocument or doc.activate();d=fusion.Design.cast(app.activeProduct);root=d.rootComponent;bench=next(o for o in root.occurrences if o.component.partNumber=='BENCH_MOTOR_COMPLEX');library=next(o for o in root.occurrences if o.component.partNumber=='BENCH_PURCHASED_LIBRARY');folder=os.path.join(tempfile.gettempdir(),'tinfox-native','motor-complex-native');os.makedirs(folder,exist_ok=True);tick=time.monotonic();files=[];custom=[];expected=set(PARTS.values());reverse={v:k for k,v in PARTS.items()}
 def export3mf(geometry,name):
  path=os.path.join(folder,name+'.3mf');options=d.exportManager.createC3MFExportOptions(geometry,path);options.sendToPrintUtility=False;options.surfaceDeviation=.001;options.normalDeviation=.03;assert d.exportManager.execute(options);assert os.path.getsize(path)>1000;files.append(path);return {'path':path,'sha256':hashlib.sha256(open(path,'rb').read()).hexdigest(),'bytes':os.path.getsize(path)}
 for key,number in PARTS.items():
  c=next(c for c in d.allComponents if c.partNumber==number);assert c.bRepBodies.count==1;b=c.bRepBodies.item(0);record=export3mf(b,key);bb=b.boundingBox;record.update(part=key,component_part_number=number,coordinate_system='Canonical native part coordinates, millimetres; no print orientation applied.',native_bounds_mm=[v*10 for v in [*bb.minPoint.asArray(),*bb.maxPoint.asArray()]],features=c.features.count,sketches=c.sketches.count,faces=b.faces.count,native_volume_mm3=b.getPhysicalProperties(fusion.CalculationAccuracy.VeryHighCalculationAccuracy).volume*1000);custom.append(record)
 stock=[];pod=next(c for c in d.allComponents if c.partNumber=='CANDIDATE_bt_pod_sleeve_90');assert pod.bRepBodies.count==2;pod_bodies=sorted(list(pod.bRepBodies),key=lambda b:b.boundingBox.maxPoint.y-b.boundingBox.minPoint.y,reverse=True);clamp=next(c for c in d.allComponents if c.partNumber=='CANDIDATE_bt_sleeve_0').bRepBodies.item(0)
 for name,body,quantity,dims in [('fit-only-pod-long-sleeve',pod_bodies[0],3,[5,3.4,41]),('fit-only-pod-short-sleeve',pod_bodies[1],3,[5,3.4,6]),('fit-only-thigh-clamp-sleeve',clamp,2,[8,4.3,18])]:
  record=export3mf(body,name);bb=body.boundingBox;assert abs((bb.maxPoint.y-bb.minPoint.y)*10-dims[2])<.00001;record.update(part=name,quantity=quantity,nominal_od_id_length_mm=dims,native_bounds_mm=[v*10 for v in [*bb.minPoint.asArray(),*bb.maxPoint.asArray()]],coordinate_system='Native cut-stock body coordinates; print placement is a separate transform.',purpose='Optional printed dimensional surrogate; actual clamp load requires the specified metal stock.');stock.append(record)
 visibility=library.isLightBulbOn;library.isLightBulbOn=True
 try:references=export3mf(library,'purchased-references')
 finally:library.isLightBulbOn=visibility
 assembled=export3mf(bench,'assembled-motor-complex');meshes={};parts=[];identity=[1.,0,0,0,0,1.,0,0,0,0,1.,0,0,0,0,1.]
 def multiply(a,b):return [sum(a[i*4+k]*b[k*4+j]for k in range(4))for i in range(4)for j in range(4)]
 def transformed(p,m):
  v=[p.x,p.y,p.z,1];return [sum(m[i*4+j]*v[j]for j in range(4))*10 for i in range(3)]
 def walk(occ):
  component=occ.component;matrix=list(occ.transform2.asArray());path=occ.fullPathName
  ref=component.attributes.itemByName('Tinfox','BenchReferenceName');role_attr=component.attributes.itemByName('Tinfox','BenchReferenceRole');custom_key=reverse.get(component.partNumber);role=role_attr.value if role_attr else 'custom_structure'if custom_key else'cut_stock';name=ref.value if ref else custom_key or component.partNumber.removeprefix('CANDIDATE_bt_')
  for index,body in enumerate(component.bRepBodies):
   key=re.sub('[^A-Za-z0-9_-]','_',name)+(('_'+str(index))if component.bRepBodies.count>1 else'');assert key not in meshes,key;calculator=body.meshManager.createMeshCalculator();calculator.surfaceTolerance=.001;calculator.maxNormalDeviation=.03;mesh=calculator.calculate();vertices=[transformed(p,matrix)for p in mesh.nodeCoordinates];ids=list(mesh.nodeIndices);assert ids and len(ids)%3==0;faces=[ids[i:i+3]for i in range(0,len(ids),3)];meshes[key]={'vertices':vertices,'faces':faces};bounds=[min(v[i]for v in vertices)for i in range(3)]+[max(v[i]for v in vertices)for i in range(3)];com=transformed(body.getPhysicalProperties(fusion.CalculationAccuracy.HighCalculationAccuracy).centerOfMass,matrix);material='envelope'if role.startswith(('vendor_','connector_'))else'steel'if role in['standard_hardware','cut_stock']else'petg';parts.append({'name':('mc_'+custom_key if custom_key else {'Roll motor':'mc_roll_motor','Hip pitch motor':'mc_hip_motor','Knee pitch motor':'mc_knee_motor'}.get(name,name))+((' '+str(index+1))if component.bRepBodies.count>1 else''),'mesh':key,'material':material,'com_mm':com,'bounds_mm':bounds,'leg':None,'group':'body','reference_role':role,'native_component':component.partNumber,'native_path':path,'native_occurrence_matrix_cm':matrix,'volume_mm3':body.volume*1000,'mass_kg':0,'mass_status':'Bench geometry review; material density and complete robot mass are not qualified.'})
  for child in component.occurrences:
   if child.isLightBulbOn:walk(child.createForAssemblyContext(occ))
 walk(bench);assert sum(p['reference_role']=='vendor_motor'for p in parts)==3;assert sum(p['reference_role'].startswith('connector_')for p in parts)==24;assert sum(p['reference_role']=='custom_structure'for p in parts)==13
 model={'parts':parts,'meshes':meshes,'parameters':{},'poses':{'stand':{'FL':[0,0,0],'FR':[0,0,0],'RL':[0,0,0],'RR':[0,0,0]}},'native_migration':{'scope':'Detached motor complex','authority':'Pending saved-state and export validation','native_source_of_truth':False,'document_file_id':doc.dataFile.id,'checkpoint_version_at_export':doc.dataFile.versionNumber,'working_modified':doc.isModified,'geometry':'Fusion meshManager, 0.01 mm surface tolerance; actual native occurrence transforms.','motion_enabled':False},'scope':'Static detached unpowered motor complex. This is not the complete robot or a loaded-strength release.'};raw=json.dumps(model,separators=(',',':')).encode();path=os.path.join(folder,'native-bench-review.json.gz');open(path,'wb').write(gzip.compress(raw,mtime=0));files.append(path);review={'path':path,'sha256':hashlib.sha256(open(path,'rb').read()).hexdigest(),'model_sha256':hashlib.sha256(raw).hexdigest(),'parts':len(parts),'custom_parts':13,'motors':3,'connector_bodies':24};parameters={p.name:{'expression':p.expression,'value_internal':p.value,'unit':p.unit}for p in d.userParameters};print(json.dumps({'saved':False,'document_file_id':doc.dataFile.id,'checkpoint_version_at_export':doc.dataFile.versionNumber,'working_modified':doc.isModified,'custom_parts':custom,'optional_fit_stock':stock,'references_3mf':references,'assembly_3mf':assembled,'review_model':review,'parameters':parameters,'files':files,'mesh_tolerances':{'surface_mm':.01,'normal_radians':.03},'elapsed_seconds':time.monotonic()-tick,'native_source_of_truth':False}))
'''.replace('PARTS',repr({k:v[0]for k,v in COMPONENTS.items()}))
compile(s,'export_motor_complex_native.py','exec');r=rpc(s,'motor-complex-native-direct-exports',timeout=900);assert r[0]['success'],r;record=json.loads(r[0]['message']);(ROOT/'audits/motor-complex-native-direct-exports.json').write_text(json.dumps(record,indent=2));folder=ROOT/'exports/motor-complex-native';folder.mkdir(exist_ok=True)
for path in record['files']:fetch(path,'motor-complex-native/'+Path(path).name)
print({'parts':len(record['custom_parts']),'review_parts':record['review_model']['parts'],'seconds':record['elapsed_seconds']})
