pedapudi/oddstride/tinfox/proposals/sculpted/model/publish_limb_variants.py

"""Package material-specific limb parts with assembly and manufacturing limits."""
import csv,json,zipfile,hashlib
from pathlib import Path
ROOT=Path(__file__).resolve().parent;OUT=ROOT/'output';D=OUT/'limb-variants'
manifest=json.loads((D/'manifest.json').read_text());verification=json.loads((D/'verification.json').read_text())
assert manifest['parent_model_sha256']==verification['parent_model_sha256']==hashlib.sha256((OUT/'model.json').read_bytes()).hexdigest()
notes="TINFOX LIMB CONSTRUCTION STUDIES\n\nScope\nThe printed route is the first unloaded fit and hand-articulation prototype.\nPrinted forks, bearing seats and motor carriers have no qualified load rating.\nAll routes use purchased motors, metal shafts, bearings, bushes and fasteners.\nThe printed route includes a widened plastic pushrod for unloaded fit checks.\nHybrid and CNC routes use a steel pushrod. The rest of the robot is shared.\n\nStructural parts and service\nEach thigh has two structural halves. Its inner half houses the knee motor;\nthe outer half includes the service ring and motor face. Each shin has two\nfore/aft structural halves with integral bearing seats and pushrod rocker.\nOpening the split releases the bearings radially. There is no internal bearing\nhousing, separate knee head, or blind pocket to press a bearing through.\nTwo M4 x 20 screws close each shin against hard mating lands. Captive sleeves\nand nuts simplify service. Install the M5 pivot nut through its side-loading\npocket before closing the shell. Check bore roundness and free rotation.\nThe knee axle uses a 12 OD x 8.4 ID x 45.1 mm precision sleeve, recessed M8 x 60\nbutton-head screw and outboard flange nut. Preload and bearing fits need testing.\nRemove the pushrod pivot, axle retention and sleeve before opening the shin.\n\nPrinted carrier\nThe printed carrier has two parts: a roll trunnion and a perpendicular hip flange\nwith integral shroud. A broad key and two M4 x 16 button-head screws join them.\nThe 5 mm flange prints with its motor face parallel to the bed. The trunnion\nprints with its roll axis vertical. Metal carriers remain one piece.\nThe shroud belongs to the roll carrier; the thigh rotates independently in pitch.\n\nPrinting\nUse the oriented print-STLs, resting at Z=0. The planning envelope is\n305 x 300 x 315 mm. All structural limb lengths lie in the bed plane.\nThigh cavities face upward with their pitch axes vertical. Shin halves lie on\nopposite curved exteriors, with their fore/aft split faces upward and bearing\naxes horizontal. Local support or a shaped cradle may be needed below curves.\nInspect layer previews for support removal, bearing seats and thin webs.\nStart with dry PETG, ample perimeters and dense local material at holes and roots.\nSolid infill does not establish strength, thermal resistance or creep life.\nPrint fit coupons and one front-left assembly before the complete set.\n\nMachining\nMetal variants have relief in the thigh cradle, service collar, motor face,\nhubs and carrier. Critical roots, bearing seats and closure lands retain material.\nThese are weight-reduced candidates, not stress-optimized production parts.\nMachine open shells from the split face and finish curves in a second setup.\nCarrier elbows need indexed setups. Finish critical split bores with the mating\nhalves fixed against their stops; obtain a shop review of tolerances and fixtures.\nSendCutSend lists a standard +/-0.005 inch CNC tolerance and no custom tolerancing.\nPrecision bearing and shaft fits need drawing-controlled finishing elsewhere.\nSource: https://sendcutsend.com/guidelines/cnc-machining/\n\nUS hardware sourcing\nAmazon.com is the default for ordinary matching fasteners. Use McMaster-Carr,\nFastenal or US manufacturer stores for precision interfaces. Lowe's is a local\nfallback. The hardware shortlist distinguishes measured dimensions from candidates;\nstock, delivery, material certification and fit are not guaranteed.\n6001-2RS bearings: https://littlemachineshop.com/products/bearing-6001-2rs\nFlanged bushes: https://www.igus.com/iglide-ibh/flange-bearings/product-details/iglide-g-m?artnr=GFM-0608-04\nM4 x 20 screw candidate: https://www.amazon.com/dp/B0DYSQZHC9\nShoulder screws: https://www.mcmaster.com/products/shoulder-screws/fastener-head-type~socket/material~steel-2/\nThe CAD shoulder screw has a 6 x 20 mm shoulder and M5 x 6 mm thread. Catalog\n94361A525 has a 5 mm thread; 92981A103 has a 10 mm thread. Neither is approved\nwithout an engagement and motor-clearance check. The rod and sleeves need finishing.\n\nMotor interfaces and remaining work\nRS-02 stators use nine M3 positions on a 73 mm circle; outputs use six M4 positions\non a 24 mm circle. Select screw lengths from actual clamp stacks and delivered\nmotor thread depths. Low-head output screws require separate clearance checks.\nSource: https://robstride.com/products/robStride02\nRoll-bearing retainers, motor ties, foot attachment, cable routing, fastener\nengagement and axle preload remain unfinished. Printed carrier, forks and bearing\nlands need temperature, creep, fatigue and impact qualification before loaded use.\n\nVerification\nCustom STEP files reopen as single valid solids. Printed meshes are watertight\nand fit the planning envelope. Eight reference poses are checked for each variant.\nThis does not prove clearance during every motion or qualify physical strength.\nMass estimates use solid CAD volume. Torque screens use prescribed force cases,\nnot gait simulation. Additional cargo is 1 kg; the robot remains above 10 kg.\n"
(D/'README.txt').write_text(notes)
rows=[]
for v in manifest['variants']:
 f=D/v['id'];catalog=json.loads((f/'parts.json').read_text());model=json.loads((f/'model.json').read_text());records=catalog['parts']
 ledger=json.loads((f/'torque-screen.json').read_text())['mass']
 custom=sum(r['mass_kg']*r['quantity'] for r in records)
 summary=f"\n{v['title']}\nEstimated whole-robot base mass: {v['base_mass_estimate_kg']:.3f} kg.\nCustom limb parts across all four legs: {custom:.3f} kg.\nMaterial-specific relief saves {v['weight_relief_kg']:.3f} kg versus unreduced shapes in the same material.\nWith 1 kg cargo: {v['base_mass_estimate_kg']+1:.3f} kg.\n\n"
 (f/'README.txt').write_text(summary+notes)
 with (f/'front-left-inventory.csv').open('w') as h:
  w=csv.writer(h);w.writerow(['part','quantity','material','STEP','print STL'])
  for r in records:
   n=sum(p['leg']=='FL' and p['mesh']==r['id'] for p in model['parts'])
   if n:w.writerow([r['id'],n,r['material'],r['step'],r.get('print_stl','')])
 ids={r['id'] for r in records}
 with (f/'hardware-inventory.csv').open('w') as h:
  w=csv.writer(h);w.writerow(['instance','material','CAD mass kg','note'])
  for p in model['parts']:
   if p['mesh'] not in ids:w.writerow([p['name'],p['material'],p['mass_kg'],p.get('note','')])
 rows.append({'variant':v['id'],'base_mass_kg':v['base_mass_estimate_kg'],'custom_limb_mass_kg':custom,'relief_savings_kg':v['weight_relief_kg'],'mass_categories':ledger['categories_kg']})
 with zipfile.ZipFile(f/'parts.zip','w',zipfile.ZIP_DEFLATED) as z:
  for p in sorted(f.rglob('*')):
   if p.is_file() and p.suffix!='.zip':z.write(p,p.relative_to(f))
  z.write(D/'verification.json','verification.json')
(D/'mass-comparison.json').write_text(json.dumps({'variants':rows,'scope':'Material-volume estimates, not measured masses. Body and payload assumptions are shared.'},indent=2))
with zipfile.ZipFile(D/'tinfox-three-limb-designs.zip','w',zipfile.ZIP_DEFLATED) as z:
 for p in sorted(D.rglob('*')):
  if p.is_file() and p.suffix!='.zip':z.write(p,p.relative_to(D))
print('Packaged all three variants with front-left inventories, hardware lists and fabrication notes.')
