pedapudi/oddstride/(commit log)

2026-11-11 Add Tinfox design sources, native-migration records and project conventions
    Add the Tinfox generators, analysis, design notes, viewer, audit manifests
    and review images, plus AGENTS.md. Generated CAD, mesh and archive payloads
    are ignored and remain local; native Fusion documents hold the CAD source.
    [Tinfox-Motor-Complex-20261029T050757Z.delivery.json, Tinfox-Motor-Complex-20261029T050757Z.release.json, Tinfox-Motor-Interface-Fit-20261029T082638Z-mac-delivery.json, Tinfox-Motor-Interface-Fit-20261029T091525Z-mac-delivery.json, Tinfox-Motor-Interface-Fit-20261029T094548Z-mac-delivery.json, Tinfox-Motor-Interface-Fit-20261029T102551Z-mac-delivery.json, Tinfox-Motor-Interface-Fit-20261029T233900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]
2026-11-12 Record knee linkage pivot and test pushrod revision (Leg v41, Tinfox v66)
